aguileraGit/bf/hours.md

#PCB Design
~6 before 16 Sep
16 Sep 3hr
17 Sep 0.5
18 Sep 2
19 Sep 1.5
20 Sep 1.5
21 Sep 0.5
23 Sep 1
24 Sep 0.5
29 Sep 1.5
30 Sep 1.5

#Troubleshooting
