aguileraGit/bf/wishList.md

Dummy Load Tester: https://www.amazon.com/KKmoon-Multi-functional-Constant-Electronic-Discharge/dp/B0713ZMFGZ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

12V Power Supplies:
https://www.alibaba.com/product-detail/ac100v-240v-50-60hz-Power-transformer_60697817835.html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

Fuses:
https://www.amazon.com/Blade-Fuses-Assortment-220PCS-Standard/dp/B07786GPGK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

12V to 5V DC/DC converter:
https://www.digikey.com/products/en/power-supplies-board-mount/dc-dc-converters/922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

http://www.cui.com/product/resource/pdq15-d.pdf Might work. Need to check the specs of the PRi
https://raspberrypi.stackexchange.com/questions/1617/how-do-i-supply-power-through-the-gpio

Connector:
https://www.digikey.com/products/en/connectors-interconnects/terminal-blocks-wire-to-board/371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

Fuse:
https://www.raspberrypi.org/forums/viewtopic.php?t=10500#p1063279

5V specs:
https://electronics.stackexchange.com/questions/12935/stability-of-usb-5v-output

Possible 12V-5V DC-DC Converters - All these meet the USB specs if designed right!
# Option 3
https://www.digikey.com/product-detail/en/delta-electronics/S24SE05004PDFA/941-1603-ND/3528194
I like this option

# Option 2
http://www.cui.com/product/resource/pdq30-d.pdf

# Option 1 with inductor
https://www.digikey.com/product-detail/en/recom-power/R-745.0P/945-1028-ND/2256208
https://www.digikey.com/product-detail/en/murata-power-solutions-inc/60B474C/811-2465-ND/3178536
https://www.digikey.com/product-detail/en/panasonic-electronic-components/EEE-FC1V330AP/PCE4368CT-ND/1142028

Filter:
https://www.digikey.com/products/en/filters/emi-rfi-filters-lc-rc-networks/835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

12V Power supplies
https://www.digikey.com/product-detail/en/mean-well-usa-inc/SP-240-12/1866-4737-ND/7706906
https://www.digikey.com/product-detail/en/mean-well-usa-inc/SP-320-12/1866-4740-ND/7706913 or 709-SP-320-12

USB Specs:
https://en.wikipedia.org/wiki/USB
