aguileraGit/bf/initScope.md

#### Title

### Scope
Design a circuit board to go to market with software being developed.

### Version overview

### Version 1
v1 simple PCB to replace wires.

Deliverables:
- Fully working PCBs (No active components. Only fuses and connections)
- Able to control

### Version 2
Deliverables:
- Fully working HW solution
- All documents needed to source assembled PCBs

A plug and play drop-in replacement

### Cost & Timeline v1
Two iterations.

### Cost & Timeline v2
Three iterations.

Design time.
Manufacturing/wait time.
Troubleshooting/assembly time.

### Assumptions
(5 day lead time + shipping)

### Expectations

### Unknowns
Solenoids being used

Operating conditions (Temp/Hum) standards
