aguileraGit/bf/questions.md

Relays - NO or NC (2-3)

5V and USB 5V - Same?
