aguileraGit/bf/PCB/mainPCB/mainPCB-v04-ImageBottom.png

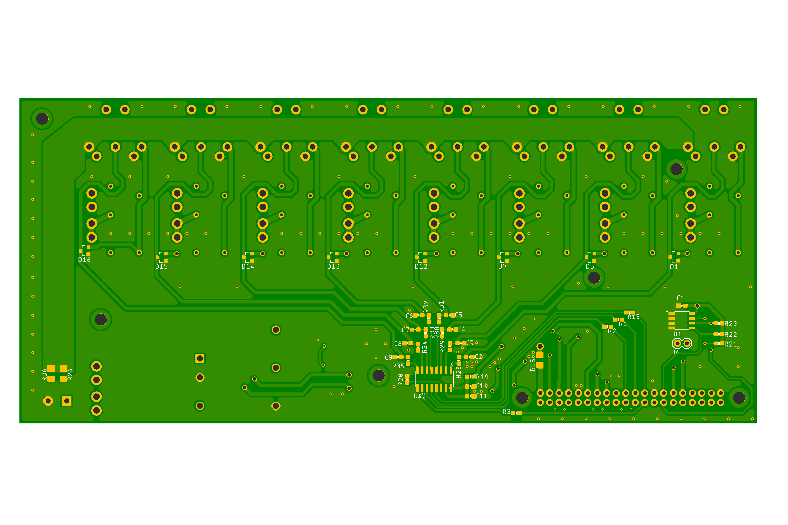
PCB/mainPCB/mainPCB-v04-ImageBottom.png
