aguileraGit/bf/PCB/mainPCB/mainPCB-v04-ImageTop.png

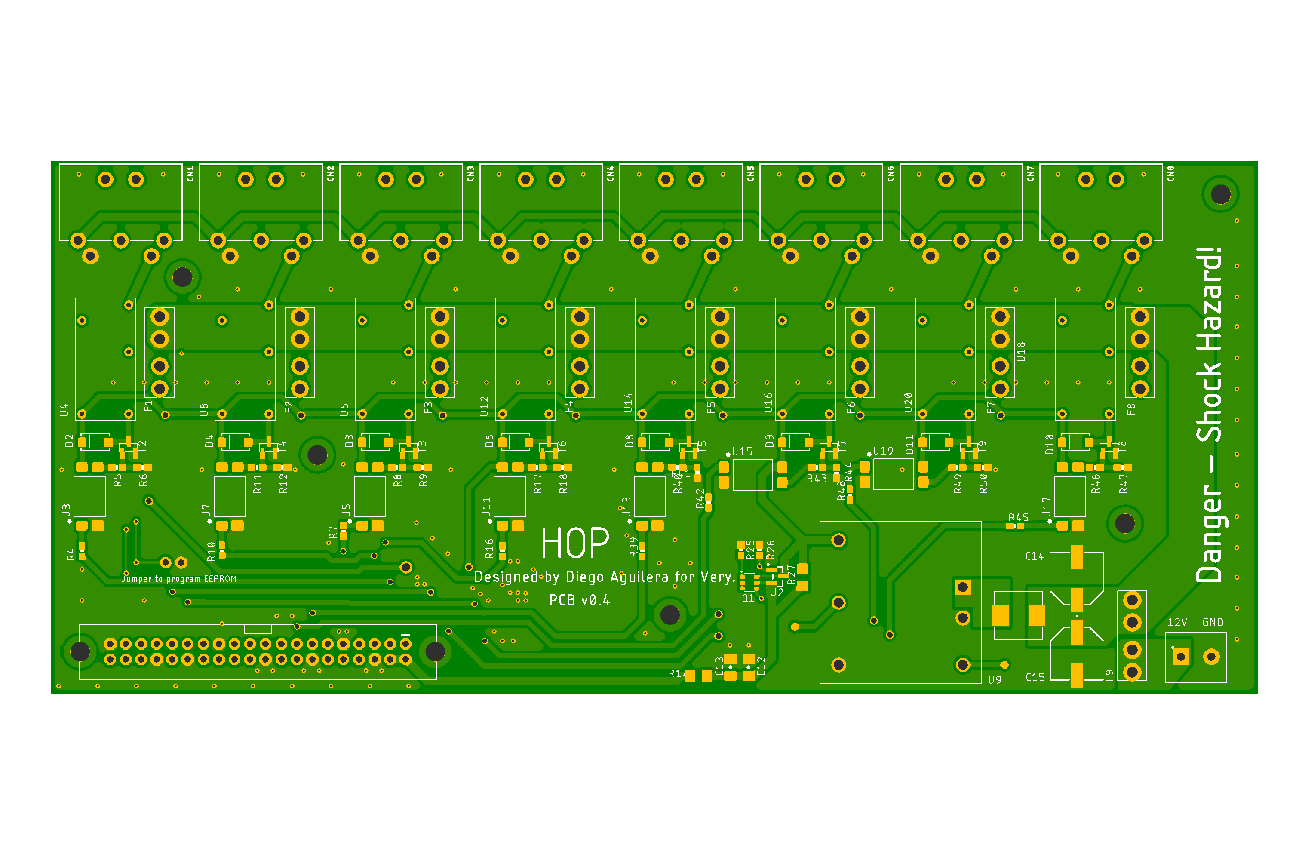
PCB/mainPCB/mainPCB-v04-ImageTop.png
