aguileraGit/bf/components.md

Relays:

Original - http://pub.ucpros.com/download/27115-Songle-Relay-Datasheet.pdf?osCsid=lkmundpgbffvh4nscdn8atdrd6

Z5439-ND
255-4029-5-ND
255-3565-ND  - closest one so far

Optoisolators
TLP785(GR-TP6F)CT-ND
TLP785(TP6F)CT-ND - closest match (https://cdn.instructables.com/FW2/0P9O/IFR69UOP/FW20P9OIFR69UOP.MEDIUM.jpg)

Vishay has spice models
https://www.vishay.com/optocouplers/related/

https://i.stack.imgur.com/lKYxf.png
https://i.stack.imgur.com/pe4n5.png

https://toshiba.semicon-storage.com/ap-en/product/opto/photocoupler/detail.TLP785.html

ratio - https://electronics.stackexchange.com/questions/59456/driving-a-relay-with-transistor-and-opto-isolator

## Final

##### Following sample circuit
http://www.electroschematics.com/8512/microcontroller-relay-interface-and-driver/

#### For LT Simulation help
LT Spice: http://cds.linear.com/docs/en/software-and-simulation/LTspiceShortcutsForMacOSX.pdf

#### Opto-coupler
- SFH615A-3X009TCT-ND (SFH615A-3X007T or SFH615A-3X009T) 100-200% CTR
- 255-3565-ND
https://www.vishay.com/optocouplers/related/#pspzip

#### Transistor
BC817-16WDICT-ND

#### Transistor
