aguileraGit/bf/originalBOM.xlsx

Sheet: Totals
Control Unit Count | Sensor Unit Count | Testing Supplies Count
2 | 16 | 2
Total Price: | $1243.49
Price Per tap: | $77.72

Sheet: Control Unit
Item No. | Item Description | Vendor Info / Purchase Link | Documentation Link | Unit Price | Qty | Qty Units | Total
0 | ADC Pi Hat | http://www.nationelectronics.com/raspberry-pi-extensions/3-raspberry-pi-hat-8-channel-adc-v11-0648260628215.html |  | $19.95 | 1 | unit | $165.98
1 | Raspberry Pi Model 3B | https://www.amazon.com/Raspberry-Model-A1-2GHz-64-bit-quad-core/dp/B01CD5VC92/ |  | $35.70 | 1 | unit
2 | SD Cards | https://www.amazon.com/SanDisk-micro-Memory-Card-Tablets/dp/B013TMN4GW/ |  | $10.08 | 2 | unit
3 | Whole System Power Supply | http://www.mouser.com/ProductDetail/Mean-Well/RD-65A | http://meanwellusa.com/productPdf.aspx?i=166#1 | $20.99 | 1 | unit
4 | Right angle micro USB | https://www.aliexpress.com/item/Free-Shipping-Left-turn-or-Right-turn-90-Degree-USB2-0-Male-to-micro-Extension-mini/32793720467.html |  | $1.20 | 1 | unit
5 | Main Power Switch | https://www.aliexpress.com/item/MYLB-3-Pin-IEC320-C14-Inlet-Module-Plug-Fuse-Switch-Male-Power-Socket-10A-250V/32745820008.html |  | $1.66 | 1 | unit
6 | Relays for Solenoids | https://www.aliexpress.com/item/8-Channel-5V-Relay-Shield-Module-Board-Optocoupler-module-For-Arduino-ARM-AVR/32790038065.html |  | $4.28 | 1 | unit
7 | 5 Pin Female External Connector | https://www.digikey.com/product-detail/en/cui-inc/SD-50SN/CP-1250-ND/97021 |  | $2.24 | 8 | unit
8 | Assorted Fuses | https://www.amazon.com/Ginsco-110pcs-5x20mm-Quick-Assorted/dp/B01CEB6B1Y/ |  | $6.99 | 1 | unit
9 | Fuse Block | https://www.aliexpress.com/item/12V-8-Way-Car-Truck-Automotive-Auto-Blade-Fuse-Box-Block-Holder-Circuit/32377857382.html |  | $8.79 | 1 | unit
10 | 2A Fuses | https://www.digikey.com/product-detail/en/littelfuse-inc/0287002.PXCN/F4192-ND/3102552 |  | $0.28 | 16 | unit
11 | Power Cord | https://www.amazon.com/Amamax-Power-Cable-VIZIO-Warranty/dp/B004TNKZ1I/ |  | $5.99 | 1 | unit
12 | Wire | https://www.amazon.com/Remington-Industries-20UL1007STRKIT-Stranded-Diameter/dp/B00N51OT6C/ |  | $20.85 | 0.25 | unit
13 | Terminal Block | https://www.aliexpress.com/item/1pcs-600V-20A-8-Position-Movable-Terminal-Blocks-TA-2008/783282597.html |  | $6.64 | 1 | unit
14 | 12mm Standoffs | https://www.aliexpress.com/item/100PCS-M2-5-male-to-female-Brass-Standoff-spacer-length-6mm-30mm/32789600225.html |  | $2.55 | 0.12 | unit
15 | M2.5 x 4mm Screws | https://www.aliexpress.com/item/100pcs-brass-flat-head-screw-M2-M2-5-M3-Brass-cross-recessed-countersunk-head-machine-screws/32792555301.html |  | $4.25 | 0.08 | lot (100)
16 | M2.5 Hex Nut | https://www.aliexpress.com/item/1000pcs-Metric-Thread-M2-5-Brass-Hex-Nuts-DIN934-Hexagon-Nut-Screw-Nut/32754809960.html |  | $7.55 | 0.008 | lot (1000)
17 | Heat Shrink | https://www.amazon.com/gp/product/B01MFA3OFA/ |  | $7.39 | 0.25 | unit
18 | Panel Mount Ethernet Jumper | https://www.aliexpress.com/item/Up-Down-Angled-RJ45-Cat5-8P8C-FTP-STP-UTP-Cat-5e-Male-to-Female-Panel-Mount/32809895058.html |  | $2.25 | 1 | unit
19 | 10pin Female Dupont (Relay board to Pi) | https://www.aliexpress.com/item/20Sets-Pitch-2-54mm-1x10-Pin-Single-Row-Dupont-Jumper-Wire-Cable-Female-Pin-Connector-And/32776723875.html |  | $3.13 | 0.05 | lot (20)
20 | 8pin Female Dupont (Pi Flow Signal) | https://www.aliexpress.com/item/Free-shipping-500Pcs-lot-Wholesale-2-54mm-Pitch-1-8-Pins-Female-Dupont-Header-Connector-Pin/1683241962.html |  | $16.40 | 0.001 | lot(1000)
21 | 2x8pin Female Dupont (Pi Flow +/-) | https://www.aliexpress.com/item/Free-shipping-500Pcs-lot-Wholesale-2-0mm-Pitch-2-8-16-Pins-Female-Dupont-Header-Connector/1277901038.html |  | $31.70 | 0.002 | lot(500)
22 | 3pin Female Dupont (Relay board to PSU) | https://www.aliexpress.com/item/200Pcs-3P-Dupont-Jumper-Wire-Cable-Housing-Plug-Female-Pin-Terminal-Dupont-Shell-Kit-Connector-2/32530544555.html |  | $1.44 | 0.005 | lot(200)
23 | 3M VHB Tape 1inch width | https://www.amazon.com/Tape-RP25-width-length-Roll/dp/B007Y7DV4E |  | $11.09 | 0.045 | roll
24 | 1/4" Spade Connector | https://www.aliexpress.com/item/6-3mm-6-3-Crimp-Terminal-Female-Spade-Connector/32679710199.html |  | $5.92 | 0.08 | lot(200)

Sheet: Sensor Unit
Item No. | Item Description | Vendor Info / Purchase Link | Documentation Link | Unit Price | Qty | Qty Units | Total
0 | Flow Meter 3/8" PTC (Male) | https://www.amazon.com/0-1-3L-1-2Mpa-Water-Sensor-Coffer/dp/B01FFHTE0E |  | $7.25 | 1 | unit | $44.33
1 | Solenoid Valve 1/4" NPT (Female) | https://www.amazon.com/Solenoid-Normally-Crack-resistant-U-S-Solid/dp/B007N0DN3Q/ |  | $11.77 | 1 | unit
2 | 5 Conductor Wire | https://www.amazon.com/ALEKO-LM150-5-Core-Conductor-Strand/dp/B01B3PKB1S/ |  | $1.12 | 8 | feet
3 | 5 Pin Male wired connector | https://www.digikey.com/product-detail/en/cui-inc/SD-50/CP-1050-ND/96997 |  | $1.47 | 1 | unit
6 | PTC Adapter 3/8" PTC (Female) to 1/4" NPTF (Male) | https://www.mcmaster.com/#9087K13 |  | $3.44 | 2 | unit
7 | 3/8" Push to Connect Splice | https://www.mcmaster.com/#9087K62 |  | $3.98 | 2 | unit

Sheet: Testing Supplies
Item No. | Item Description | Vendor Info / Purchase Link | Documentation Link | Unit Price | Qty | Qty Units | Total
0 | 3/8" Push to Connect Tubing | https://www.mcmaster.com/#5384K556 |  | $0.34 | 25 | feet | $101.12
1 | 3/8" Push to Connect to 1/4" NPT (Female) | https://www.mcmaster.com/#9087K28 |  | $6.39 | 1 | units
2 | Garden Hose (Female) to 3/8" NPT (Male) | https://www.mcmaster.com/#73605T67 |  | $4.22 | 1 | units
3 | Faucet to Garden Hose Adapter | https://www.amazon.com/LDR-530-2050-Aerator-Adapter/dp/B00BHZLR4K/ |  | $8.33 | 1 | units
4 | 3/8" NPT (Female) to 1/4" NPT (Male) | https://www.amazon.com/Anderson-Metals-Fitting-Adapter-Female/dp/B000BQUI8M/ |  | $5.61 | 1 | units
5 | IR Flashlight | https://www.amazon.com/VastFire-Adjustable-Infrared-Flashlight-Hunting/dp/B01IEYFGNO |  | $21.99 | 1 | units
6 | Extra SD Card | https://www.amazon.com/SanDisk-micro-Memory-Card-Tablets/dp/B013TMN4GW/ |  | $10.08 | 1 | unit
7 | Switched USB Cable | https://www.amazon.com/JBtek-Raspberry-Micro-Cable-Switch/dp/B00JU24Z3W |  | $6.49 | 1 | unit
8 | Peripheral Switch | https://www.amazon.com/IOGEAR-Computer-Peripheral-Sharing-GUS402/dp/B00BD8I2OY/ |  | $29.51 | 1 | unit
