aguileraGit/bf/PCB/mainPCB/mainPCB-BOM-v0_4-01.xlsx

Populate | Qty | Value | Device | Package | Parts | PN | Digikey PN | Description | Unit Price | Ext Price
Y | 8 |  | DIODESMA | SMA-DIODE | D2, D3, D4, D6, D8, D9, D10, D11 | S1A-13-F | S1A-E3/5ATGICT-ND | Diode | 0.33 | 2.64
Y | 1 |  | M02PTH | 1X02 | J6 | M20-9990246 | 952-2262-ND | Standard 2-pin 0.1 header. Use with" | 0.11 | 0.11
Y | 6 | 0 | RESISTOR0603-RES | 0603-RES | R1, R2, R3, R13, R19, R20 | RC0603JR-070RL | 311-0.0GRCT-ND | Resistor | 0.1 | 0.60
Y | 4 | 0 | RESISTOR1206 | 1206 | R14, R15, R24, R36 | HCJ1206ZT0R00 | HCJ1206ZT0R00CT-ND | Resistor | 0.55 | 2.20
Y | 11 | 0.1uF | 0.1UF-25V(+80/-20%)(0603) | 0603-CAP | C1, C2, C3, C4, C5, C6, C7, C8, C9, C10, C11 | C0603C104K8RACTU | 399-1095-1-ND | CAP-00810 | 0.029 | 0.32
Y | 9 | 10k | RESISTOR0603-RES | 0603-RES | R5, R8, R11, R17, R25, R40, R43, R46, R49 | RC0603FR-0710KL | 311-10.0KHRCT-ND | Resistor | 0.1 | 0.90
Y | 1 | 1935161 | 1935161 | PHOENIX_1935161 | J1 | 277-1667-ND | 1935161 | Conn Terminal Blocks 2 POS 5mm Solder ST Thru-Hole 16A | 0.41 | 0.41
Y | 2 | 1uF | 1.0UF50V10%(1206) | 1206-CAP | C12, C13 | CC1206KKX7R6BB105 | 311-1951-1-ND | CAP-09822 | 0.26 | 0.52
Y | 3 | 3.9k | RESISTOR0603-RES | 0603-RES | R21, R22, R23 | RC0603FR-073K9L | 311-3.90KHRCT-ND | Resistor | 0.1 | 0.30
Y | 8 | 330 | RESISTOR0603-RES | 0603-RES | R28, R29, R30, R31, R32, R33, R34, R35 | RC0603FR-07300RL | 311-300HRCT-ND | Resistor | 0.1 | 0.80
Y | 9 | 3544-2 | 3544-2 | 3544-2 | F1, F2, F3, F4, F5, F6, F7, F8, F9 | 3544-2 | 36-3544-2-ND | Keystone Electronics Fuse Holder - 3544-2 | 0.91 | 8.19
Y | 8 | 47 | RESISTOR0603-RES | 0603-RES | R4, R7, R10, R16, R39, R42, R45, R48 | RC0603JR-0747RL | 311-47GRCT-ND | Resistor | 0.1 | 0.80
Y | 9 | 47k | RESISTOR0603-RES | 0603-RES | R6, R9, R12, R18, R26, R41, R44, R47, R50 | RC0603FR-0747KL | 311-47.0KHRCT-ND | Resistor | 0.1 | 0.90
Y | 8 | ALQ105 | ALQ105 | ALQ105 | U4, U6, U8, U12, U14, U16, U18, U20 | ALQ105 | 255-3565-ND | ALQ105 Solenoid | 2.42 | 19.36
Y | 1 | AT24C256C-SSHL-B | AT24C256C-SSHL-B | SOIC127P600X175-8N | U1 | AT24C256C-SSHL-B | AT24C256C-SSHL-B-ND | EEPROM Serial-2Wire 256K-bit 32K x 8 1.8V/2.5V/3.3V/5V 8-Pin SOIC Bulk | 0.7 | 0.70
Y | 8 | BAV99-7-F | BAV99 | SOT23-3 | D1, D5, D7, D12, D13, D14, D15, D16 | BAV99-7-F | BAV99-FDICT-ND | Two small signal silicon diodes connected anode to cathode. | 0.16 | 1.28
Y | 8 | BC817 | BC817 | BC817 | T2, T3, T4, T5, T6, T7, T8, T9 | BC817-25-7-F | BC817-25FDICT-ND | NPN Transistor BC817 | 0.22 | 1.76
Y | 1 | DMG2305UX-13SOT-23-M | DMG2305UX-13SOT-23-M | SOT-23-M | U2 | DMG2305UX-13 | DMG2305UX-13DICT-ND |  | 0.44 | 0.44
Y | 1 | DMMT5401-7-F | DMMT5401-7-F | SOT26 | Q1 | DMMT5401-7-F | DMMT5401-FDICT-ND | http://octopart.com/dmmt5401-7-f-diodes+inc.-39560120 | 0.46 | 0.46
N | 1 | DNP | RESISTOR1206 | 1206 | R27 |  |  | Resistor |  |  |  | N
Y | 1 | DR73-1R0-R | DR73-1R0-R | DR73 | L1 | DR73-1R0-R | 513-1130-1-ND |  | 1.13 | 1.13
Y | 2 | EEE-HA1C471UPCAP_PAN_EEE_F-L | EEE-HA1C471UPCAP_PAN_EEE_F-L | CAP_PAN_EEE_F-L | C14, C15 | EEE-HA1C471UP | PCE4192CT-ND |  | 0.68 | 1.36
N | 1 | FRAME-LETTER | FRAME-LETTER | CREATIVE_COMMONS | FRAME3 |  |  | Schematic Frame |  |  |  | N
N | 2 | FRAME-LETTERNO_PACKAGE | FRAME-LETTERNO_PACKAGE | DUMMY | FRAME1, FRAME2 |  |  | Schematic Frame |  |  | Nobody | N | v01
Y | 1 | MCP3208T-CI/SL | MCP3208T-CI/SL | SOIC16-N_MC | U$2 | MCP3208T-CI/SL | MCP3208T-CI/SLCT-ND | Microchip MCP3208 ADC | 3.69 | 3.69
Y | 1 | RASPBERRYPI-40-PIN-GPIO | RASPBERRYPI-40-PIN-GPIO | 2X20-SHROUDED | J2 | 929975-01-20-RK | 929975E-01-20-ND | Second Generation Raspberry Pi GPIO Header | 3.2 | 3.20
Y | 1 | S24SE05004PDFA | S24SE05004PDFA | CONV_S24SE05002PDFA | U9 | S24SE05004PDFA | 941-1603-ND | None | 34.48 | 34.48
Y | 8 | SDS-50J | SDS-50J | SDS-50J | CN1, CN2, CN3, CN4, CN5, CN6, CN7, CN8 | SDS-50J | CP-2350-ND | DIN 5-Pin - Circular | 1.57 | 12.56
Y | 8 | SFH615A-07 | SFH615A-07 | SFH615A-07 | U3, U5, U7, U11, U13, U15, U17, U19 | SFH615A-4X017T | SFH615A-4X017TCT-ND | Vishay Optocoupler SFH615A-007 | 1.3 | 10.40
N | 2 | TEST-POINT3X5 | TEST-POINT3X5 | PAD.03X.05 | TP_ON/OFF, TP_TRIM |  |  | Bare copper test points for troubleshooting or ICT
 |  |  |  |  |  |  |  |  |  | 109.51
