aguileraGit/bf/PCB/mainPCB/mainPCB-BOM-v0_4-00.xlsx

Sheet: BOM
POPULATE | Qty | Value | Device | Package | Parts | PN | Digikey PN | Price | Description | AVAILABILITY | DESCRIPTION | DESIGNER | DIGI-KEY_PART_NUMBER | DIGI-KEY_PURCHASE_URL | MANUFACTURER_PART_NUMBER | MF | MP | PACKAGE | PRICE | PROD_ID | VALUE | VENDOR | VERSION
Y | 8 |  | DIODESMA | SMA-DIODE | D2, D3, D4, D6, D8, D9, D10, D11 | BAV21WS-7-F | BAV21WS-FDICT-ND | 0.22 | Diode
Y | 1 |  | M02PTH | 1X02 | J6 | M20-9990246 | 952-2262-ND | 0.1 | Standard 2-pin 0.1 header. Use with"
Y | 6 | 0 | RESISTOR0603-RES | 0603-RES | R1, R2, R3, R13, R19, R20 | RC0603JR-070RL | 311-0.0GRCT-ND | 0.1 | Resistor
Y | 3 | 0 | RESISTOR1206 | 1206 | R14, R15, R24 | HCJ1206ZT0R00 | HCJ1206ZT0R00CT-ND | 0.5 | Resistor
Y | 11 | 0.1uF | 0.1UF-25V(+80/-20%)(0603) | 0603-CAP | C1, C2, C3, C4, C5, C6, C7, C8, C9, C10, C11 | C0603C104K8RACTU | 399-1095-1-ND | 0.1 | CAP-00810 |  |  |  |  |  |  |  |  |  |  | CAP-00810 | 0.1uF
Y | 9 | 10k | RESISTOR0603-RES | 0603-RES | R5, R8, R11, R17, R25, R40, R43, R46, R49 | RC0603FR-0710KL | 311-10.0KHRCT-ND | 0.1 | Resistor
Y | 2 | 1uF | 1.0UF50V10%(1206) | 1206-CAP | C12, C13 | CC1206KKX7R6BB105 | 311-1951-1-ND |  | CAP-09822 |  |  |  |  |  |  |  |  |  |  | CAP-09822 | 1.0uF
Y | 1 | 1776244-4 | 1776244-4 | 1776244-4 | CON1 | 1776244-4 | A97998-ND |  | TE 1776244-4
Y | 3 | 3.9k | RESISTOR0603-RES | 0603-RES | R21, R22, R23 | RC0603FR-073K9L | 311-3.90KHRCT-ND |  | Resistor
Y | 8 | 330 | RESISTOR0603-RES | 0603-RES | R28, R29, R30, R31, R32, R33, R34, R35 | RC0603FR-07300RL | 311-300HRCT-ND |  | Resistor
Y | 9 | 3544-2 | 3544-2 | 3544-2 | F1, F2, F3, F4, F5, F6, F7, F8, F9 | 3544-2 | 36-3544-2-ND | 0.91 | Keystone Electronics Fuse Holder - 3544-2
Y | 8 | 47 | RESISTOR0603-RES | 0603-RES | R4, R7, R10, R16, R39, R42, R45, R48 | RC0603JR-0747RL | 311-47GRCT-ND | 0.1 | Resistor
Y | 9 | 47k | RESISTOR0603-RES | 0603-RES | R6, R9, R12, R18, R26, R41, R44, R47, R50 | RC0603FR-0747KL | 311-47.0KHRCT-ND | 0.1 | Resistor
Y | 8 | ALQ105 | ALQ105 | ALQ105 | U4, U6, U8, U12, U14, U16, U18, U20 | ALQ105 | 255-3565-ND | 2.42 | ALQ105 Solenoid
Y | 1 | AT24C256C-SSHL-B | AT24C256C-SSHL-B | SOIC127P600X175-8N | U1 | AT24C256C-SSHL-B | AT24C256C-SSHL-B-ND | 0.69 | EEPROM Serial-2Wire 256K-bit 32K x 8 1.8V/2.5V/3.3V/5V 8-Pin SOIC Bulk |  | EEPROM Serial-2Wire 256K-bit 32K x 8 1.8V/2.5V/3.3V/5V 8-Pin SOIC Bulk |  | AT24C256C-SSHL-B-ND | https://www.digikey.com/product-detail/en/microchip-technology/AT24C256C-SSHL-B/AT24C256C-SSHL-B-ND/2271121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 |  | Atmel | AT24C256C-SSHL-B | SOIC-8 Atmel
Y | 8 | BAV99-7-F | BAV99 | SOT23-3 | D1, D5, D7, D12, D13, D14, D15, D16 | BAV99-7-F | BAV99-FDITR-ND | 0.22 | Two small signal silicon diodes connected anode to cathode. |  |  |  |  |  |  |  |  |  |  | DIO-10647
Y | 8 | BC817 | BC817 | BC817 | T2, T3, T4, T5, T6, T7, T8, T9 | BC817-25-7-F | BC817-25FDICT-ND | 0.22 | NPN Transistor BC817
Y | 1 | DMG2305UX-13SOT-23-M | DMG2305UX-13SOT-23-M | SOT-23-M | U2 | DMG2305UX-13 | DMG2305UX-13DICT-ND |  |  |  |  |  |  |  | DMG2305UX13 |  |  |  |  |  |  | Diodes Inc
Y | 1 | DMMT5401-7-F | DMMT5401-7-F | SOT26 | Q1 | DMMT5401-7-F | DMMT5401-FDICT-ND | 0.46 | http://octopart.com/dmmt5401-7-f-diodes+inc.-39560120 |  | DMMT5401 Series PNP 150 V 300 mW Small Signal Transistor SMT - SOT-26-6 |  | DMMT5401-FDICT-ND | https://www.digikey.com/product-detail/en/diodes-incorporated/DMMT5401-7-F/DMMT5401-FDICT-ND/717881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 |  | Diodes Inc. | DMMT5401-7-F | SOT-23 Diodes Inc.
N | 1 | DNP | RESISTOR1206 | 1206 | R27 |  |  |  | Resistor
Y | 2 | EEE-HA1C471UPCAP_PAN_EEE_F-L | EEE-HA1C471UPCAP_PAN_EEE_F-L | CAP_PAN_EEE_F-L | C14, C15 | EEE-HA1C471UP | PCE4192CT-ND | 0.68 |  |  |  |  |  |  | EEEHA1C471UP |  |  |  |  |  |  | PANASONIC
N | 1 | FRAME-LETTER | FRAME-LETTER | CREATIVE_COMMONS | FRAME3 |  |  |  | Schematic Frame
N | 2 | FRAME-LETTERNO_PACKAGE | FRAME-LETTERNO_PACKAGE | DUMMY | FRAME1, FRAME2 |  |  |  | Schematic Frame |  |  | Nobody |  |  |  |  |  |  |  |  |  |  | v01
Y | 1 | MCP3208T-CI/SL | MCP3208T-CI/SL | SOIC16-N_MC | U$2 | MCP3208T-CI/SL | MCP3208T-CI/SLCT-ND | 3.65 | Microchip MCP3208 ADC | Good | 8 Channel SPI Serial Interface 2.7 V 12-Bit A/D Converter SMT - SOIC-16 |  |  |  |  | Microchip | MCP3208T-CI/SL | SOIC-16 Microchip | 3.04 USD
Y | 1 | RASPBERRYPI-40-PIN-GPIO | RASPBERRYPI-40-PIN-GPIO | 2X20-SHROUDED | J2 | 929975-01-20-RK | 929975E-01-20-ND | 3.32 | Second Generation Raspberry Pi GPIO Header
Y | 8 | SDS-50J | SDS-50J | SDS-50J | CN1, CN2, CN3, CN4, CN5, CN6, CN7, CN8 | SDS-50J | CP-2350-ND | 1.17 | DIN 5-Pin - Circular | Good | 5 Pin%2C Right-Angle Receptacle%2C 180%C2%B0 |  |  |  |  | CUI | SDS-50J | None | 0.77 USD
Y | 8 | SFH615A-07 | SFH615A-07 | SFH615A-07 | U3, U5, U7, U11, U13, U15, U17, U19 | SFH615A-4X017T | SFH615A-4X017TCT-ND | 1.03 | Vishay Optocoupler SFH615A-007

Sheet: Sheet2
Units of X-Y coordinates are in millimeters
Part | X | Y | Rotation | Side | Type | XSize | YSize | Value | Footprint | Populate | MPN
C1 | 20.02 | 31.5 | 180 |  | 1 |  |  | 0.1uF | 0603 | 1
C2 | 76.84 | 17.78 | 0 |  | 1 |  |  | 0.1uF | 0603 | 1
C3 | 79.12 | 21.46 | 0 |  | 1 |  |  | 0.1uF | 0603 | 1
C4 | 81.28 | 25.15 | 0 |  | 1 |  |  | 0.1uF | 0603 | 1
C5 | 82.17 | 28.96 | 0 |  | 1 |  |  | 0.1uF | 0603 | 1
C6 | 90.3 | 28.96 | 180 |  | 1 |  |  | 0.1uF | 0603 | 1
C7 | 91.31 | 25.15 | 180 |  | 1 |  |  | 0.1uF | 0603 | 1
C8 | 93.34 | 21.46 | 180 |  | 1 |  |  | 0.1uF | 0603 | 1
C9 | 95.89 | 17.78 | 180 |  | 1 |  |  | 0.1uF | 0603 | 1 |  | import mainPCB.mnt in dirctory
C10 | 76.53 | 9.93 | 0 |  | 1 |  |  | 0.1uF | 0603 | 1
C11 | 76.53 | 7.24 | 0 |  | 1 |  |  | 0.1uF | 0603 | 1
D1 | 22.02 | 44.58 | 90 |  | 1 |  |  | BAV99-7-F | SOT23-3 | 1
D5 | 44.5 | 44.45 | 90 |  | 1 |  |  | BAV99-7-F | SOT23-3 | 1
D7 | 67.87 | 44.45 | 90 |  | 1 |  |  | BAV99-7-F | SOT23-3 | 1
D12 | 89.71 | 44.45 | 90 |  | 1 |  |  | BAV99-7-F | SOT23-3 | 1
D13 | 113.33 | 44.45 | 90 |  | 1 |  |  | BAV99-7-F | SOT23-3 | 1
D14 | 135.94 | 44.45 | 90 |  | 1 |  |  | BAV99-7-F | SOT23-3 | 1
D15 | 159.05 | 44.45 | 90 |  | 1 |  |  | BAV99-7-F | SOT23-3 | 1
D16 | 180.42 | 46.23 | 90 |  | 1 |  |  | BAV99-7-F | SOT23-3 | 1
R1 | 36.96 | 27.81 | 180 |  | 1 |  |  | 0 | 0603 | 1
R2 | 39.88 | 25.91 | 180 |  | 1 |  |  | 0 | 0603 | 1
R3 | 64.26 | 2.79 | 180 |  | 1 |  |  | 0 | 0603 | 1
R13 | 34.04 | 29.72 | 180 |  | 1 |  |  | 0 | 0603 | 1
R15 | 57.96 | 17.02 | 270 |  | 1 |  |  | 0 | 1206 | 1
R19 | 76.53 | 12.6 | 0 |  | 1 |  |  | 0 | 0603 | 1
R20 | 93.42 | 11.81 | 270 |  | 1 |  |  | 0 | 0603 | 1
R21 | 10.11 | 21.39 | 0 |  | 1 |  |  | 3.9k | 0603 | 1
R22 | 10.11 | 23.93 | 0 |  | 1 |  |  | 3.9k | 0603 | 1
R23 | 10.11 | 26.85 | 0 |  | 1 |  |  | 3.9k | 0603 | 1
R24 | 184.15 | 31.72 | 270 |  | 1 |  |  | 0 | 1206 | 1
R28 | 79.63 | 16.89 | 90 |  | 1 |  |  | 330 | 0603 | 1
R29 | 82.04 | 20.57 | 90 |  | 1 |  |  | 330 | 0603 | 1
R30 | 84.07 | 24.26 | 90 |  | 1 |  |  | 330 | 0603 | 1
R31 | 84.84 | 28.07 | 90 |  | 1 |  |  | 330 | 0603 | 1
R32 | 87.63 | 28.07 | 90 |  | 1 |  |  | 330 | 0603 | 1
R33 | 88.52 | 24.26 | 90 |  | 1 |  |  | 330 | 0603 | 1
R34 | 90.55 | 20.45 | 90 |  | 1 |  |  | 330 | 0603 | 1
R35 | 93.22 | 16.89 | 90 |  | 1 |  |  | 330 | 0603 | 1
U$2 | 86.23 | 11.81 | 270 |  | 1 |  |  | MCP3208T-CI/SL | SOIC16 | 1
U1 | 20.02 | 27.48 | 0 |  | 1 |  |  | AT24C256C-SSHL-B | SOIC127-8N | 1
