aguileraGit/bf/PCB/mainPCB/BF_v0_2-00-BOM.xlsx

Sheet: BOM
Populate | Qty | Value | Device | Package | Parts | Manufacture PN | DigiKey PN | 1 |  | 10 |  | 100 |  | Description | AVAILABILITY | DESCRIPTION | DESIGNER | DIGI-KEY_PART_NUMBER | DIGI-KEY_PURCHASE_URL | MANUFACTURER_PART_NUMBER | MF | MP | PACKAGE | PRICE | PROD_ID | VALUE | VENDOR | VERSION
Y | 9 |  | DIODESMA | SMA-DIODE | D2, D3, D4, D5, D6, D8, D9, D10, D11 | CDBA5200-HF | 641-1706-1-ND | 0.59 | 5.31 | 0.493 | 44.37 | 0.3699 | 332.91 | Diode
Y | 1 |  | M02PTH | 1X02 | J6 | M20-9990246 | 952-2262-ND | 0.11 | 0.11 | 0.099 | 0.99 | 0.0609 | 6.09 | Standard 2-pin 0.1 header. Use with"
Y | 6 | 0 | RESISTOR0603-RES | 0603-RES | R1, R2, R3, R13, R19, R20 | RC0603JR-070RL | 311-0.0GRCT-ND | 0.1 | 0.6 | 0.01 | 0.6 | 0.0041 | 2.46 | Resistor
Y | 3 | 0 | RESISTOR1206 | 1206 | R14, R15, R24 | RC1206JR-070RL | 311-0.0ERCT-ND | 0.1 | 0.3 | 0.024 | 0.72 | 0.0097 | 2.91 | Resistor
Y | 11 | 0.1uF | 0.1UF-25V(+80/-20%)(0603) | 0603-CAP | C1, C2, C3, C4, C5, C6, C7, C8, C9, C10, C11 | GRM188R70J104KA01D | 490-9730-1-ND | 0.1 | 1.1 | 0.071 | 7.81 | 0.0316 | 34.76 | CAP-00810 |  |  |  |  |  |  |  |  |  |  | CAP-00810 | 0.1uF
Y | 2 | 10uF | 1.0UF50V10%(1206) | 1206-CAP | C12, C13 | LMK316B7106KL-TD | 587-2596-1-ND | 0.27 | 0.54 | 0.182 | 3.64 | 0.1032 | 20.64 | CAP-09822 |  |  |  |  |  |  |  |  |  |  | CAP-09822 | 1.0uF
Y | 9 | 10k | RESISTOR0603-RES | 0603-RES | R5, R8, R11, R17, R25, R40, R43, R46, R49 | RC0603FR-0710KL | 311-10.0KHRCT-ND | 0.1 | 0.9 | 0.015 | 1.35 | 0.006 | 5.4 | Resistor
Y | 1 | 1776244-4 | 1776244-4 | 1776244-4 | CON1 | 1776244-4 | A97998-ND | 1.74 | 1.74 | 1.225 | 12.25 | 1.0319 | 103.19 | TE 1776244-4
Y | 3 | 3.9k | RESISTOR0603-RES | 0603-RES | R21, R22, R23 | RC0603FR-073K9L | 311-3.90KHRDKR-ND | 0.1 | 0.3 | 0.015 | 0.45 | 0.006 | 1.8 | Resistor
Y | 8 | 330 | RESISTOR0603-RES | 0603-RES | R28, R29, R30, R31, R32, R33, R34, R35 | RC0603FR-07300RL | 311-300HRCT-ND | 0.1 | 0.8 | 0.015 | 1.2 | 0.006 | 4.8 | Resistor
Y | 8 | 3544-2 | 3544-2 | 3544-2 | F1, F2, F3, F4, F5, F6, F7, F8 | 3544-2 | 36-3544-2-ND | 0.91 | 7.28 | 0.778 | 62.24 | 0.6714 | 537.12 | Keystone Electronics Fuse Holder - 3544-2
Y | 8 | 47 | RESISTOR0603-RES | 0603-RES | R4, R7, R10, R16, R39, R42, R45, R48 | RC0603FR-0747RL | 311-47.0HRCT-ND | 0.1 | 0.8 | 0.015 | 1.2 | 0.006 | 4.8 | Resistor
Y | 9 | 47k | RESISTOR0603-RES | 0603-RES | R6, R9, R12, R18, R26, R41, R44, R47, R50 | RC0603FR-0747KL | 311-47.0KHRCT-ND | 0.1 | 0.9 | 0.015 | 1.35 | 0.006 | 5.4 | Resistor
Y | 8 | ALQ105 | ALQ105 | ALQ105 | U4, U6, U8, U12, U14, U16, U18, U20 | ALQ105 | 255-3565-ND | 2.42 | 19.36 | 2.273 | 181.84 | 1.818 | 1454.4 | ALQ105 Solenoid
Y | 1 | AT24C256C-SSHL-B | AT24C256C-SSHL-B | SOIC127P600X175-8N | U1 | AT24C256C-SSHL-B | AT24C256C-SSHL-B-ND | 0.69 | 0.69 | 0.631 | 6.31 | 0.5537 | 55.37 | EEPROM Serial-2Wire 256K-bit 32K x 8 1.8V/2.5V/3.3V/5V 8-Pin SOIC Bulk |  | EEPROM Serial-2Wire 256K-bit 32K x 8 1.8V/2.5V/3.3V/5V 8-Pin SOIC Bulk |  | AT24C256C-SSHL-B-ND | https://www.digikey.com/product-detail/en/microchip-technology/AT24C256C-SSHL-B/AT24C256C-SSHL-B-ND/2271121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 |  | Atmel | AT24C256C-SSHL-B | SOIC-8 Atmel
Y | 8 | BC817 | BC817 | BC817 | T2, T3, T4, T5, T6, T7, T8, T9 | BC817-25-7-F | BC817-25FDICT-ND | 0.22 | 1.76 | 0.183 | 14.64 | 0.0969 | 77.52 | NPN Transistor BC817
Y | 1 | DMG2305UX-13SOT-23-M | DMG2305UX-13SOT-23-M | SOT-23-M | U2 | DMG2305UX-13 | DMG2305UX-13DICT-ND | 0.44 | 0.44 | 0.398 | 3.98 | 0.2228 | 22.28 |  |  |  |  |  |  | DMG2305UX13 |  |  |  |  |  |  | Diodes Inc
Y | 1 | DMMT5401-7-F | DMMT5401-7-F | SOT26 | Q1 | DMMT5401-7-F | DMMT5401-FDICT-ND | 0.46 | 0.46 | 0.346 | 3.46 | 0.2153 | 21.53 | http://octopart.com/dmmt5401-7-f-diodes+inc.-39560120 |  | DMMT5401 Series PNP 150 V 300 mW Small Signal Transistor SMT - SOT-26-6 |  | DMMT5401-FDICT-ND | https://www.digikey.com/product-detail/en/diodes-incorporated/DMMT5401-7-F/DMMT5401-FDICT-ND/717881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 |  | Diodes Inc. | DMMT5401-7-F | SOT-23 Diodes Inc.
N | 1 | DNP | RESISTOR1206 | 1206 | R27 |  |  |  |  |  |  |  |  | Resistor
Y | 2 | EEE-HA1C471UPCAP_PAN_EEE_F-L | EEE-HA1C471UPCAP_PAN_EEE_F-L | CAP_PAN_EEE_F-L | C14, C15 | EEE-HA1C471UP | PCE4192CT-ND | 0.68 | 1.36 | 0.481 | 9.62 | 0.3166 | 63.32 |  |  |  |  |  |  | EEEHA1C471UP |  |  |  |  |  |  | PANASONIC
N | 1 | FRAME-LETTER | FRAME-LETTER | CREATIVE_COMMONS | FRAME3 |  |  |  |  |  |  |  |  | Schematic Frame
N | 2 | FRAME-LETTERNO_PACKAGE | FRAME-LETTERNO_PACKAGE | DUMMY | FRAME1, FRAME2 |  |  |  |  |  |  |  |  | Schematic Frame |  |  | Nobody |  |  |  |  |  |  |  |  |  |  | v01
Y | 1 | MCP3208T-CI/SL | MCP3208T-CI/SL | SOIC16-N_MC | U$2 | MCP3208T-CI/SL | MCP3208T-CI/SLCT-ND | 3.65 | 3.65 | 3.65 | 36.5 | 2.772 | 277.2 | Microchip MCP3208 ADC | Good | 8 Channel SPI Serial Interface 2.7 V 12-Bit A/D Converter SMT - SOIC-16 |  |  |  |  | Microchip | MCP3208T-CI/SL | SOIC-16 Microchip | 3.04 USD
N | 1 | RASPBERRYPI-40-PIN-GPIO | RASPBERRYPI-40-PIN-GPIO | 2X20-SHROUDED | J2 |  |  |  |  |  |  |  |  | Second Generation Raspberry Pi GPIO Header
Y | 8 | SDS-50J | SDS-50J | SDS-50J | CN1, CN2, CN3, CN4, CN5, CN6, CN7, CN8 | SDS-50J | CP-2350-ND | 1.17 | 9.36 | 1.028 | 82.24 | 0.8866 | 709.28 | DIN 5-Pin - Circular | Good | 5 Pin%2C Right-Angle Receptacle%2C 180%C2%B0 |  |  |  |  | CUI | SDS-50J | None | 0.77 USD
Y | 8 | SFH615A-07 | SFH615A-07 | SFH615A-07 | U3, U5, U7, U11, U13, U15, U17, U19 | SFH615A-4X017T | SFH615A-4X017TCT-ND | 1.03 | 8.24 | 0.84 | 67.2 | 0.5816 | 465.28 | Vishay Optocoupler SFH615A-007
N | 1 |  | Fuse |  |  | 0287002.PXCN | F4192-ND | 0.28 | 0.28 | 0.26 | 2.6 | 0.216 | 21.6
 |  |  |  |  |  |  | Total Cost |  | 66.28 |  | 546.56 |  | 4230.06
 |  |  |  |  |  |  | Cost per board |  | 66.28 |  | 54.656 |  | 42.3006

Sheet: Revisions
2017-11-29 | 00 | Started v0.2
