aguileraGit/bf/timeline.xlsx

Sheet: Sheet1
 | 100
Phase I |  | Hours | Rate | Fixed
 | Research | 4 | 400
 | Design | 20 | 2000 |  | 10.66666667 | 16
 | PCB + Parts (3) |  |  | 400
 | Assembly | 3 | 300
 | Troubleshooting | 5 | 500
 |  |  |  | $3600
Phase II - Projected |  | Hours | Rate | Fixed
 | Design | 10 | 1000 |  | 5.166666667 | 7.75
 | PCB + Parts (3) |  |  | 400
 | Assembly | 3 | 300
 | Troubleshooting | 2.5 | 250
 |  |  |  | $1950
Phase III - Projected |  | Hours | Rate | Fixed
 | Design | 5 | 500
 | PCB + Parts (3) |  |  | 400 | 3.666666667 | 5.5
 | Assembly | 3 | 300 |  |  | 29.25 | 50.25 |  | 7.178571429 | 2017-11-04
 | Work with FAB House | 3 | 300
 |  |  |  | $1500
 |  |  |  |  | 20 | 21 | 41 | 5.857142857
 |  |  |  | 7050 |  |  | 2017-09-08 | 2017-10-25

Sheet: Parts Estimate
Parts |  |  | On PCB | Total
Rpi headers | 2.95 | 1528-1783-ND | 1 | 2.95
ADC | 4.57 | MCP3208-BI/P-ND | 1 | 4.57
vRef | 3 |  | 1 | 3
Connector | 1.17 | CP-2350-ND | 8 | 9.36
Relay | 5 |  | 8 | 40
Fuse holder | 0.75 |  | 8 | 6
opto isolator | 0.25 |  | 8 | 2
Passives - RLC | 10 |  | 1 | 10
Screw terminals | 0.3 |  | 4 | 1.2
 |  |  |  | 79.08 | 237.24
