aguileraGit/bf/PCB/downloads/DR73-1R0-R/STL\STL\STEP\DR73.step

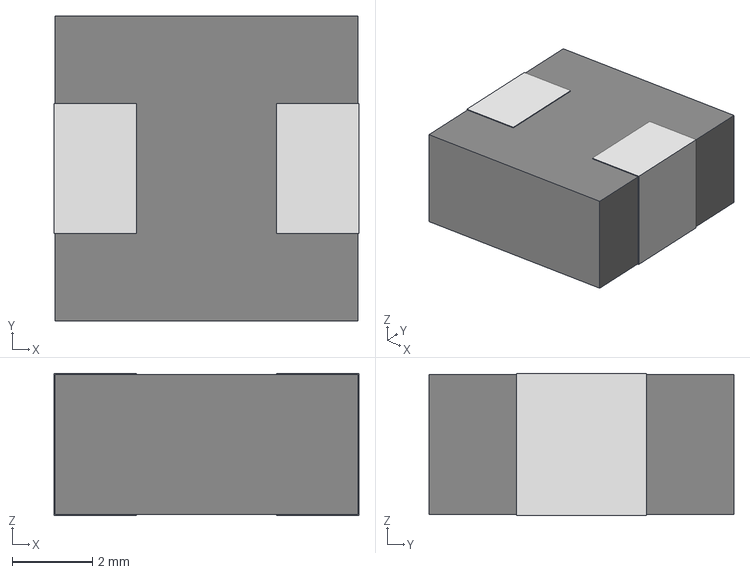
[picture p3: CAD file, 2018-02-24]
PCB/downloads/DR73-1R0-R/STL\STL\STEP\DR73.step
7.62 x 7.62 x 3.56 mm
