aguileraGit/bf/PCB/downloads/sdf-50j.stp

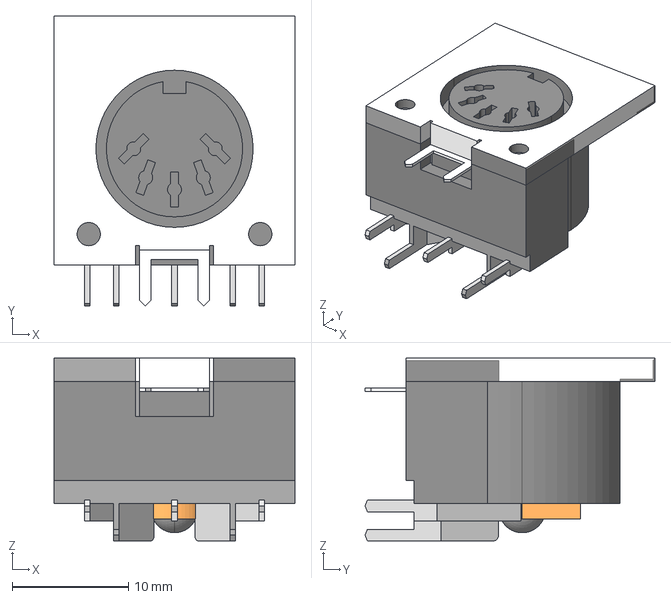
[picture p4: CAD file, 2017-10-07]
PCB/downloads/sdf-50j.stp
20.7 x 24.9 x 15.7 mm
