aguileraGit/bf/PCB/downloads/PAN_ALQ1.step

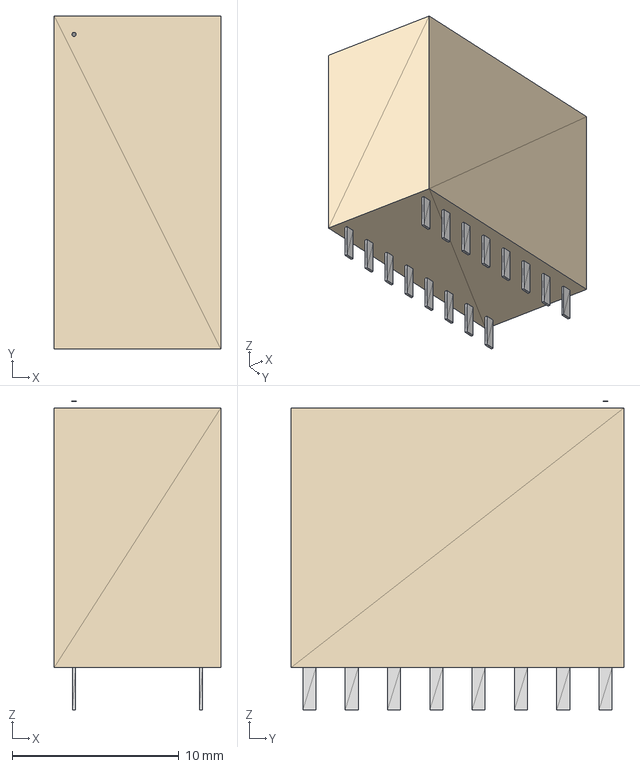
[picture p5: CAD file, 2017-10-07]
PCB/downloads/PAN_ALQ1.step
10.0 x 20.0 x 18.5 mm
