aguileraGit/bf/PCB/downloads/keystone-PN3544-2.STEP.txt

ISO-10303-21; HEADER; FILE_DESCRIPTION (( 'STEP AP214' ), '1' ); FILE_NAME ('3544-2.STEP', '2013-03-27T20:41:27', ( 'Richard Maletta' ), ( '' ), 'SwSTEP 2.0', 'SolidWorks 2009', '' ); FILE_SCHEMA (( 'AUTOMOTIVE_DESIGN' )); ENDSEC; DATA; #1 =( NAMED_UNIT ( * ) PLANE_ANGLE_UNIT ( ) SI_UNIT ( $, .RADIA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
04311369527748131600 ) ) ; #842 = LINE ( 'NONE', #841, #840 ) ; #843 = LINE ( 'NONE', #863, #860 ) ; #844 = SURFACE_STYLE_FILL_AREA ( #845 ) ; #845 = FILL_AREA_STYLE ('',( #850 ) ) ; #846 = COLOUR_RGB ( '',0.7960784313725489700, 0.8235294117647058400, 0.9372549019607843100 ) ; #847 = FACE_OUTER_BOUND ( 'NONE', #4868, .T. ) ; #848 = DIRECTION ( 'NONE', ( -5.773722060964636400E-018, -1.621377732827185500E-016, 1.000000000000000000 ) ) ; #849 = VECTOR ( 'NONE', #848, 1000.000000000000000 ) ; #850 = FILL_AREA_STYLE_COLOUR ( '', #846 ) ; #851 = VECTOR ( 'NONE', #866, 1000.000000000000100 ) ; #852 =( LENGTH_UNIT ( ) NAMED_UNIT ( * ) SI_UNIT ( .MILLI., .METRE. ) ); #853 = MECHANICAL_DESIGN_GEOMETRIC_PRESENTATION_REPRESENTATION ( '', ( #855 ), #759 ) ; #854 = PRESENTATION_LAYER_ASSIGNMENT ( '', '', ( #855 ) ) ; #855 = STYLED_ITEM ( 'NONE', ( #856 ), #5038 ) ; #856 = PRESENTATION_STYLE_ASSIGNMENT (( #857 ) ) ; #857 = SURFACE_STYLE_USAGE ( .BOTH. , #858 ) ; #858 = SURFACE_SIDE_STYLE ('',( #844 ) ) ; #859 = LINE ( 'NONE', #862, #851 ) ; #860 = VECTOR ( 'NONE', #865, 1000.000000000000000 ) ; #861 = CARTESIAN_POINT ( 'NONE', ( -0.4799178465506506200, 1.442144520634609500, 0.04311369527748056000 ) ) ; #862 = CARTESIAN_POINT ( 'NONE', ( -0.4799178465506501700, 0.2737445206345858200, -6.103686304722515400 ) ) ; #863 = CARTESIAN_POINT ( 'NONE', ( -4.237517846550652200, -1.647855479365389500, 0.7289136952774795100 ) ) ; #864 = LINE ( 'NONE', #861, #849 ) ; #865 = DIRECTION ( 'NONE', ( 1.000000000000000000, 0.0000000000000000000, 0.0000000000000000000 ) ) ; #866 = DIRECTION ( 'NONE', ( 1.921789193134769600E-016, -0.7071067811865461300, 0.7071067811865489100 ) ) ; #867 = SURFACE_STYLE_USAGE ( .BOTH. , #868 ) ; #868 = SURFACE_SIDE_STYLE ('',( #869 ) ) ; #869 = SURFACE_STYLE_FILL_AREA ( #883 ) ; #870 = COLOUR_RGB ( '',0.7960784313725489700, 0.8235294117647058400, 0.9372549019607843100 ) ; #871 = FACE_OUTER_BOUND ( 'NONE', #4936, .T. ) ; #872 = AXIS2_PLACEMENT_3D ( 'NONE', #882, #874, #881 ) ; #873 = CYLINDRICAL_SURFACE ( 'NONE', #872, 0.4826000000000002000 ) ; #874 = DIRECTION ( 'NONE', ( 2.775557561562890900E-016, -1.000000000000000000, -1.621377732827185800E-016 ) ) ; #875 =( LENGTH_UNIT ( ) NAMED_UNIT ( * ) SI_UNIT ( .MILLI., .METRE. ) ); #876 = MECHANICAL_DESIGN_GEOMETRIC_PRESENTATION_REPRESENTATION ( '', ( #878 ), #885 ) ; #877 = PRESENTATION_LAYER_ASSIGNMENT ( '', '', ( #878 ) ) ; #878 = STYLED_ITEM ( 'NONE', ( #879 ), #5039 ) ; #879 = PRESENTATION_STYLE_ASSIGNMENT (( #867 ) ) ; #880 = FILL_AREA_STYLE_COLOUR ( '', #870 ) ; #881 = DIRECTION ( 'NONE', ( 0.0000000000000000000, 0.0000000000000000000, 1.000000000000000000 ) ) ; #882 = CARTESIAN_POINT ( 'NONE', ( -0.9625178465506524200, 6.420544520634610600, -0.3886863047225181400 ) ) ; #883 = FILL_AREA_STYLE ('',( #880 ) ) ; #884 = PLANE ( 'NONE', #889 ) ; #885 =( GEOMETRIC_REPRESENTATION_CONTEXT ( 3 ) GLOBAL_UNCERTAINTY_ASSIGNED_CONTEXT ( ( #894 ) ) GLOBAL_UNIT_ASSIGNED_CONTEXT ( ( #875, #764, #893 ) ) REPRESENTATION_CONTEXT ( 'NONE', 'WORKASPACE' ) ); #886 = CARTESIAN_POINT ( 'NONE', ( -3.451717846550651700, 6.420544520634610600, 0.4241136952774812700 ) ) ; #887 = DIRECTION ( 'NONE', ( 5.773722060964636400E-018, 1.621377732827185500E-016, -1.000000000000000000 ) ) ; #888 = DIRECTION ( 'NONE', ( -2.775557561562890900E-016, 1.000000000000000000, 1.621377732827185500E-016 ) ) ; #889 = AXIS2_PLACEMENT_3D ( 'NONE', #886, #888, #887 ) ; #890 = CARTESIAN_POINT ( 'NONE', ( 4.347682153449347300, -1.647855479365389500, 0.7289136952774799600 ) ) ; #891 = CARTESIAN_POINT ( 'NONE', ( -4.137517846550649900, 1.442144520634609500, 0.04311369527748056000 ) ) ; #892 = LINE ( 'NONE', #891, #896 ) ; #893 =( NAMED_UNIT ( * ) SI_UNIT ( $, .STERADIAN. ) SOLID_ANGLE_UNIT ( ) ); #894 = UNCERTAINTY_MEASURE_WITH_UNIT (LENGTH_MEASURE( 1.000000000000000100E-005 ), #875, 'distance_accuracy_value', 'NONE'); #895 =( NAMED_UNIT ( * ) SI_UNIT ( $, .STERADIAN. ) SOLID_ANGLE_UNIT ( ) ); #896 = VECTOR ( 'NONE', #899, 1000.000000000000000 ) ; #897 =( NAMED_UNIT ( * ) PLANE_ANGLE_UNIT ( ) SI_UNIT ( $, .RADIAN. ) ); #898 = UNCERTAINTY_MEASURE_WITH_UNIT (LENGTH_MEASURE( 1.000000000000000100E-005 ), #914, 'distance_accuracy_value', 'NONE'); #899 = DIRECTION ( 'NONE', ( 5.773722060964636400E-018, 1.621377732827185500E-016, -1.000000000000000000 ) ) ; #900 = LINE ( 'NONE', #938, #902 ) ; #901 =( GEOMETRIC_REPRESENTATION_CONTEXT ( 3 ) GLOBAL_UNCERTAINTY_ASSIGNED_CONTEXT ( ( #930 ) ) GLOBAL_UNIT_ASSIGNED_CONTEXT ( ( #904, #924, #923 ) ) REPRESENTATION_CONTEXT ( 'NONE', 'WORKASPACE' ) ); #902 = VECTOR ( 'NONE', #936, 1000.000000000000000 ) ; #903 = FILL_AREA_STYLE_COLOUR ( '', #934 ) ; #904 =( LENGTH_UNIT ( ) NAMED_UNIT ( * ) SI_UNIT ( .MILLI., .METRE. ) ); #905 = MECHANICAL_DESIGN_GEOMETRIC_PRESENTATION_REPRESENTATION ( '', ( #926 ), #901 ) ; #906 = COLOUR_RGB ( '',0.7960784313725489700, 0.8235294117647058400, 0.9372549019607843100 ) ; #907 = FACE_OUTER_BOUND ( 'NONE', #5056, .T. ) ; #908 = DIRECTION ( 'NONE', ( 5.773722060964636400E-018, 1.621377732827185500E-016, -1.000000000000000000 ) ) ; #909 = DIRECTION ( 'NONE', ( -2.775557561562890900E-016, 1.000000000000000000, 1.621377732827185500E-016 ) ) ; #910 = FILL_AREA_STYLE ('',( #911 ) ) ; #911 = FILL_AREA_STYLE_COLOUR ( '', #906 ) ; #912 = CARTESIAN_POINT ( 'NONE', ( -4.137517846550649000, -1.580455479365391100, 0.04311369527748001900 ) ) ; #913 = VECTOR ( 'NONE', #931, 1000.000000000000000 ) ; #914 =( LENGTH_UNIT ( ) NAMED_UNIT ( * ) SI_UNIT ( .MILLI., .METRE. ) ); #915 = MECHANICAL_DESIGN_GEOMETRIC_PRESENTATION_REPRESENTATION ( '', ( #917 ), #1253 ) ; #916 = PRESENTATION_LAYER_ASSIGNMENT ( '', '', ( #917 ) ) ; #917 = STYLED_ITEM ( 'NONE', ( #918 ), #5055 ) ; #918 = PRESENTATION_STYLE_ASSIGNMENT (( #919 ) ) ; #919 = SURFACE_STYLE_USAGE ( .BOTH. , #920 ) ; #920 = SURFACE_SIDE_STYLE ('',( #921 ) ) ; #921 = SURFACE_STYLE_FILL_AREA ( #910 ) ; #922 = CARTESIAN_POINT ( 'NONE', ( 7.573482153449347700, 0.8921445206346105800, -1.785686304722517100 ) ) ; #923 =( NAMED_UNIT ( * ) SI_UNIT ( $, .STERADIAN. ) SOLID_ANGLE_UNIT ( ) ); #924 =( NAMED_UNIT ( * ) PLANE_ANGLE_UNIT ( ) SI_UNIT ( $, .RADIAN. ) ); #925 = PRESENTATION_LAYER_ASSIGNMENT ( '', '', ( #926 ) ) ; #926 = STYLED_ITEM ( 'NONE', ( #927 ), #5052 ) ; #927 = PRESENTATION_STYLE_ASSIGNMENT (( #928 ) ) ; #928 = SURFACE_STYLE_USAGE ( .BOTH. , #929 ) ; #929 = SURFACE_SIDE_STYLE ('',( #932 ) ) ; #930 = UNCERTAINTY_MEASURE_WITH_UNIT (LENGTH_MEASURE( 1.000000000000000100E-005 ), #904, 'distance_accuracy_value', 'NONE'); #931 = DIRECTION ( 'NONE', ( -0.0000000000000000000, -0.0000000000000000000, -1.000000000000000000 ) ) ; #932 = SURFACE_STYLE_FILL_AREA ( #933 ) ; #933 = FILL_AREA_STYLE ('',( #903 ) ) ; #934 = COLOUR_RGB ( '',0.7960784313725489700, 0.8235294117647058400, 0.9372549019607843100 ) ; #935 = FACE_OUTER_BOUND ( 'NONE', #5053, .T. ) ; #936 = DIRECTION ( 'NONE', ( 5.773722060964636400E-018, 1.621377732827185500E-016, -1.000000000000000000 ) ) ; #937 = LINE ( 'NONE', #922, #913 ) ; #938 = CARTESIAN_POINT ( 'NONE', ( -0.8609178465506517300, 6.420544520634610600, 0.7289136952774809600 ) ) ; #939 = PLANE ( 'NONE', #941 ) ; #940 = CARTESIAN_POINT ( 'NONE', ( -0.8609178465506517300, 6.420544520634610600, 0.7289136952774809600 ) ) ; #941 = AXIS2_PLACEMENT_3D ( 'NONE', #940, #909, #908 ) ; #942 = VECTOR ( 'NONE', #945, 1000.000000000000000 ) ; #943 = CARTESIAN_POINT ( 'NONE', ( -5.444017846550655000, 0.8921445206346105800, -2.903286304722517000 ) ) ; #944 = LINE ( 'NONE', #943, #942 ) ; #945 = DIRECTION ( 'NONE', ( -1.000000000000000000, -0.0000000000000000000, -0.0000000000000000000 ) ) ; #946 =( LENGTH_UNIT ( ) NAMED_UNIT ( * ) SI_UNIT ( .MILLI., .METRE. ) ); #947 = MECHANICAL_DESIGN_GEOMETRIC_PRESENTATION_REPRESENTATION ( '', ( #949 ), #973 ) ; #948 = PRESENTATION_LAYER_ASSIGNMENT ( '', '', ( #949 ) ) ; #949 = STYLED_ITEM ( 'NONE', ( #950 ), #5315 ) ; #950 = PRESENTATION_STYLE_ASSIGNMENT (( #951 ) ) ; #951 = SURFACE_STYLE_USAGE ( .BOTH. , #952 ) ; #952 = SURFACE_SIDE_STYLE ('',( #953 ) ) ; #953 = SURFACE_STYLE_FILL_AREA ( #954 ) ; #954 = FILL_AREA_STYLE ('',( #961 ) ) ; #955 = COLOUR_RGB ( '',0.7960784313725489700, 0.8235294117647058400, 0.9372549019607843100 ) ; #956 = FACE_OUTER_BOUND ( 'NONE', #5316, .T. ) ; #957 = DIRECTION ( 'NONE', ( 1.000000000000000000, 0.0000000000000000000, -5.606166404184160800E-017 ) ) ; #958 = VECTOR ( 'NONE', #957, 1000.000000000000000 ) ; #959 = CARTESIAN_POINT ( 'NONE', ( 3.917482153449351100, -1.580455479365387300, -0.08388630472251905300 ) ) ; #960 = LINE ( 'NONE', #959, #958 ) ; #961 = FILL_AREA_STYLE_COLOUR ( '', #955 ) ; #962 = VECTOR ( 'NONE', #965, 1000.000000000000000 ) ; #963 = LINE ( 'NONE', #964, #962 ) ; #964 = CARTESIAN_POINT ( 'NONE', ( 7.930682153449351900, -4.755455479365387800, -1.455486304722520200 ) ) ; #965 = DIRECTION ( 'NONE', ( -2.775557561562890900E-016, 1.000000000000000000, 5.993114065094845700E-017 ) ) ; #966 =( NAMED_UNIT ( * ) PLANE_ANGLE_UNIT ( ) SI_UNIT ( $, .RADIAN. ) ); #967 = UNCERTAINTY_MEASURE_WITH_UNIT (LENGTH_MEASURE( 1.000000000000000100E-005 ), #946, 'distance_accuracy_value', 'NONE'); #968 =( NAMED_UNIT ( * ) SI_UNIT ( $, .STERADIAN. ) SOLID_ANGLE_UNIT ( ) ); #969 = UNCERTAINTY_MEASURE_WITH_UNIT (LENGTH_MEASURE( 1.000000000000000100E-005 ), #1539, 'distance_accuracy_value', 'NONE'); #970 =( NAMED_UNIT ( * ) SI_UNIT ( $, .STERADIAN. ) SOLID_ANGLE_UNIT ( ) ); #971 =( NAMED_UNIT ( * ) PLANE_ANGLE_UNIT ( ) SI_UNIT ( $, .RADIAN. ) ); #972 =( NAMED_UNIT ( * ) PLANE_ANGLE_UNIT ( ) SI_UNIT ( $, .RADIAN. ) ); #973 =( GEOMETRIC_REPRESENTATION_CONTEXT ( 3 ) GLOBAL_UNCERTAINTY_ASSIGNED_CONTEXT ( ( #967 ) ) GLOBAL_UNIT_ASSIGNED_CONTEXT ( ( #946, #971, #970 ) ) REPRESENTATION_CONTEXT ( 'NONE', 'WORKASPACE' ) ); #974 = AXIS2_PLACEMENT_3D ( 'NONE', #997, #975, #1001 ) ; #975 = DIRECTION ( 'NONE', ( 2.359031401440604700E-016, -0.7071067811865490200, 0.7071067811865460200 ) ) ; #976 =( GEOMETRIC_REPRESENTATION_CONTEXT ( 3 ) GLOBAL_UNCERTAINTY_ASSIGNED_CONTEXT ( ( #969 ) ) GLOBAL_UNIT_ASSIGNED_CONTEXT ( ( #1539, #966, #968 ) ) REPRESENTATION_CONTEXT ( 'NONE', 'WORKASPACE' ) ); #977 = VECTOR ( 'NONE', #987, 1000.000000000000000 ) ; #978 = DIRECTION ( 'NONE', ( -2.775557561562890900E-016, 1.000000000000000000, -7.666125903226468000E-017 ) ) ; #979 = VECTOR ( 'NONE', #978, 1000.000000000000000 ) ; #980 = SURFACE_STYLE_FILL_AREA ( #995 ) ; #981 = COLOUR_RGB ( '',0.7960784313725489700, 0.8235294117647058400, 0.9372549019607843100 ) ; #982 = MECHANICAL_DESIGN_GEOMETRIC_PRESENTATION_REPRESENTATION ( '', ( #1005 ), #1007 ) ; #983 = UNCERTAINTY_MEASURE_WITH_UNIT (LENGTH_MEASURE( 1.000000000000000100E-005 ), #1009, 'distance_accuracy_value', 'NONE'); #984 = PLANE ( 'NONE', #998 ) ; #985 = DIRECTION ( 'NONE', ( 5.606166404184158300E-017, 7.666125903226469200E-017, 1.000000000000000000 ) ) ; #986 = CARTESIAN_POINT ( 'NONE', ( 3.917482153449351100, -1.580455479365387300, -0.08388630472251905300 ) ) ; #987 = DIRECTION ( 'NONE', ( 0.0000000000000000000, -1.000000000000000000, -1.707404996040164300E-016 ) ) ; #988 = PRESENTATION_STYLE_ASSIGNMENT (( #989 ) ) ; #990 = CARTESIAN_POINT ( 'NONE', ( 3.890482153449347400, 0.8921445206346105800, 0.7289136952774799600 ) ) ; #989 = SURFACE_STYLE_USAGE ( .BOTH. , #991 ) ; #991 = SURFACE_SIDE_STYLE ('',( #980 ) ) ; #992 = CARTESIAN_POINT ( 'NONE', ( 7.625882153449348200, 6.420544520634614100, -0.08388630472251981700 ) ) ; #993 = LINE ( 'NONE', #992, #979 ) ; #994 = LINE ( 'NONE', #990, #977 ) ; #995 = FILL_AREA_STYLE ('',( #1002 ) ) ; #996 =( NAMED_UNIT ( * ) SI_UNIT ( $, .STERADIAN. ) SOLID_ANGLE_UNIT ( ) ); #997 = CARTESIAN_POINT ( 'NONE', ( 3.917482153449352000, -4.374455479365387600, -0.08388630472251873400 ) ) ; #998 = AXIS2_PLACEMENT_3D ( 'NONE', #986, #985, #1010 ) ; #999 = DIRECTION ( 'NONE', ( 2.775557561562890900E-016, -1.000000000000000000, 7.776281064261323500E-017 ) ) ; #1000 = VECTOR ( 'NONE', #999, 1000.000000000000000 ) ; #1001 = DIRECTION ( 'NONE', ( -1.566199745268830900E-016, 0.7071067811865460200, 0.7071067811865490200 ) ) ; #1002 = FILL_AREA_STYLE_COLOUR ( '', #981 ) ; #1003 = FACE_OUTER_BOUND ( 'NONE', #5321, .T. ) ; #1004 = PRESENTATION_LAYER_ASSIGNMENT ( '', '', ( #1005 ) ) ; #1005 = STYLED_ITEM ( 'NONE', ( #988 ), #5320 ) ; #1006 = PLANE ( 'NONE', #974 ) ; #1007 =( GEOMETRIC_REPRESENTATION_CONTEXT ( 3 ) GLOBAL_UNCERTAINTY_ASSIGNED_CONTEXT ( ( #983 ) ) GLOBAL_UNIT_ASSIGNED_CONTEXT ( ( #1009, #972, #996 ) ) REPRESENTATION_CONTEXT ( 'NONE', 'WORKASPACE' ) ); #1008 = CARTESIAN_POINT ( 'NONE', ( 7.625882153449351700, -4.755455479365386900, -0.4648863047225209600 ) ) ; #1009 =( LENGTH_UNIT ( ) NAMED_UNIT ( * ) SI_UNIT ( .MILLI., .METRE. ) ); #1010 = DIRECTION ( 'NONE', ( -2.775557561562890900E-016, 1.000000000000000000, -7.666125903226468000E-017 ) ) ; #1011 = LINE ( 'NONE', #1013, #1017 ) ; #1012 = DIRECTION ( 'NONE', ( 1.000000000000000000, 1.705445482763587300E-031, -2.901736657442119600E-015 ) ) ; #1013 = CARTESIAN_POINT ( 'NONE', ( 7.930682153449350100, -0.1326554793653869900, 0.04311369527748099000 ) ) ; #1014 = CARTESIAN_POINT ( 'NONE', ( 7.625882153449348200, 6.420544520634614100, -0.08388630472251938600 ) ) ; #1015 = LINE ( 'NONE', #1014, #1000 ) ; #1016 = DIRECTION ( 'NONE', ( -5.606166404184162000E-017, 5.993114065094840700E-017, -1.000000000000000000 ) ) ; #1017 = VECTOR ( 'NONE', #1016, 1000.000000000000000 ) ; #1018 = LINE ( 'NONE', #1019, #1021 ) ; #1019 = CARTESIAN_POINT ( 'NONE', ( 7.930682153449351900, -4.755455479365387800, -1.074486304722519300 ) ) ; #1020 = CARTESIAN_POINT ( 'NONE', ( 7.625882153449350800, -4.755455479365387800, -1.074486304722518200 ) ) ; #1021 = VECTOR ( 'NONE', #1012, 1000.000000000000000 ) ; #1022 = CARTESIAN_POINT ( 'NONE', ( 7.625882153449350800, -1.580455479365387300, -0.08388630472251927500 ) ) ; #1023 = CARTESIAN_POINT ( 'NONE', ( 7.625882153449351700, -4.374455479365385800, -0.08388630472251905300 ) ) ; #1024 = CARTESIAN_POINT ( 'NONE', ( 7.930682153438154600, -1.853216928145228600, -0.7649217471639049300 ) ) ; #1025 = CARTESIAN_POINT ( 'NONE', ( 3.968282153460548100, -1.853216928145228600, -0.7649217471639049300 ) ) ; #1026 = FACE_OUTER_BOUND ( 'NONE', #5341, .T. ) ; #1027 = LINE ( 'NONE', #1033, #1031 ) ; #1028 = FILL_AREA_STYLE_COLOUR ( '', #1029 ) ; #1029 = COLOUR_RGB ( '',0.7960784313725489700, 0.8235294117647058400, 0.9372549019607843100 ) ; #1030 = DIRECTION ( 'NONE', ( 5.606166404184162000E-017, -5.993114065094840700E-017, 1.000000000000000000 ) ) ; #1031 = VECTOR ( 'NONE', #1030, 1000.000000000000000 ) ; #1032 = VECTOR ( 'NONE', #1039, 1000.000000000000000 ) ; #1033 = CARTESIAN_POINT ( 'NONE', ( 7.930682153449350100, 1.442144520634612800, 0.04311369527748110100 ) ) ; #1034 = LINE ( 'NONE', #1040, #1032 ) ; #1035 = SURFACE_STYLE_USAGE ( .BOTH. , #1036 ) ; #1036 = SURFACE_SIDE_STYLE ('',( #1037 ) ) ; #1037 = SURFACE_STYLE_FILL_AREA ( #1038 ) ; #1038 = FILL_AREA_STYLE ('',( #1028 ) ) ; #1039 = DIRECTION ( 'NONE', ( 1.000000000000000000, 1.705445482763587300E-031, -2.901736657442119600E-015 ) ) ; #1040 = CARTESIAN_POINT ( 'NONE', ( 7.625882153449349900, -0.1326554793653867700, -1.455486304722518800 ) ) ; #1041 = MECHANICAL_DESIGN_GEOMETRIC_PRESENTATION_REPRESENTATION ( '', ( #1043 ), #1045 ) ; #1042 = PRESENTATION_LAYER_ASSIGNMENT ( '', '', ( #1043 ) ) ; #1043 = STYLED_ITEM ( 'NONE', ( #1044 ), #5340 ) ; #1044 = PRESENTATION_STYLE_ASSIGNMENT (( #1035 ) ) ; #1045 =( GEOMETRIC_REPRESENTATION_CONTEXT ( 3 ) GLOBAL_UNCERTAINTY_ASSIGNED_CONTEXT ( ( #1046 ) ) GLOBAL_UNIT_ASSIGNED_CONTEXT ( ( #1051, #1056, #1070 ) ) REPRESENTATION_CONTEXT ( 'NONE', 'WORKASPACE' ) ); #1046 = UNCERTAINTY_MEASURE_WITH_UNIT (LENGTH_MEASURE( 1.000000000000000100E-005 ), #1051, 'distance_accuracy_value', 'NONE'); #1047 = SURFACE_STYLE_USAGE ( .BOTH. , #1048 ) ; #1048 = SURFACE_SIDE_STYLE ('',( #1049 ) ) ; #1049 = SURFACE_STYLE_FILL_AREA ( #1050 ) ; #1050 = FILL_AREA_STYLE ('',( #1057 ) ) ; #1051 =( LENGTH_UNIT ( ) NAMED_UNIT ( * ) SI_UNIT ( .MILLI., .METRE. ) ); #1052 = MECHANICAL_DESIGN_GEOMETRIC_PRESENTATION_REPRESENTATION ( '', ( #1054 ), #1072 ) ; #1053 = PRESENTATION_LAYER_ASSIGNMENT ( '', '', ( #1054 ) ) ; #1054 = STYLED_ITEM ( 'NONE', ( #1055 ), #5346 ) ; #1055 = PRESENTATION_STYLE_ASSIGNMENT (( #1047 ) ) ; #1056 =( NAMED_UNIT ( * ) PLANE_ANGLE_UNIT ( ) SI_UNIT ( $, .RADIAN. ) ); #1057 = FILL_AREA_STYLE_COLOUR ( '', #1058 ) ; #1058 = COLOUR_RGB ( '',0.7960784313725489700, 0.8235294117647058400, 0.9372549019607843100 ) ; #1059 = FACE_OUTER_BOUND ( 'NONE', #5322, .T. ) ; #1060 = DIRECTION ( 'NONE', ( 1.000000000000000000, 0.0000000000000000000, -5.606166404184160800E-017 ) ) ; #1061 = VECTOR ( 'NONE', #1060, 1000.000000000000000 ) ; #1062 = CARTESIAN_POINT ( 'NONE', ( 7.930682153449351900, -4.374455479365387600, -0.08388630472251895600 ) ) ; #1063 = CARTESIAN_POINT ( 'NONE', ( 7.930682153449351900, -4.374455479365387600, -0.08388630472251873400 ) ) ; #1064 = DIRECTION ( 'NONE', ( 2.359031401440597800E-016, -0.7071067811865460200, 0.7071067811865490200 ) ) ; #1065 = DIRECTION ( 'NONE', ( -1.855576110359431800E-015, -0.7071067811865490200, -0.7071067811865460200 ) ) ; #1066 = CARTESIAN_POINT ( 'NONE', ( 7.625882153449350800, -4.374455479365387600, -1.455486304722519300 ) ) ; #1067 = AXIS2_PLACEMENT_3D ( 'NONE', #1066, #1065, #1064 ) ; #1068 = PLANE ( 'NONE', #1067 ) ; #1069 = LINE ( 'NONE', #1062, #1061 ) ; #1070 =( NAMED_UNIT ( * ) SI_UNIT ( $, .STERADIAN. ) SOLID_ANGLE_UNIT ( ) ); #1071 =( NAMED_UNIT ( * ) PLANE_ANGLE_UNIT ( ) SI_UNIT ( $, .RADIAN. ) ); #1072 =( GEOMETRIC_REPRESENTATION_CONTEXT ( 3 ) GLOBAL_UNCERTAINTY_ASSIGNED_CONTEXT ( ( #1087 ) ) GLOBAL_UNIT_ASSIGNED_CONTEXT ( ( #1086, #1071, #1074 ) ) REPRESENTATION_CONTEXT ( 'NONE', 'WORKASPACE' ) ); #1073 = DIRECTION ( 'NONE', ( 6.095048960246059200E-033, 1.000000000000000000, 1.087204431837239300E-016 ) ) ; #1074 =( NAMED_UNIT ( * ) SI_UNIT ( $, .STERADIAN. ) SOLID_ANGLE_UNIT ( ) ); #1075 = DIRECTION ( 'NONE', ( -1.000000000000000000, 0.0000000000000000000, 5.606166404184160800E-017 ) ) ; #1076 = AXIS2_PLACEMENT_3D ( 'NONE', #1085, #1075, #1073 ) ; #1077 = AXIS2_PLACEMENT_3D ( 'NONE', #1084, #1083, #1082 ) ; #1078 = CIRCLE ( 'NONE', #1077, 0.3809999999999998900 ) ; #1079 = AXIS2_PLACEMENT_3D ( 'NONE', #1099, #1093, #1092 ) ; #1080 = TOROIDAL_SURFACE ( 'NONE', #1076, 0.4892385512201587500, 0.5080000000000000100 ) ; #1081 = CIRCLE ( 'NONE', #1079, 0.5588000000000014100 ) ; #1082 = DIRECTION ( 'NONE', ( 0.0000000000000000000, 0.0000000000000000000, 1.000000000000000000 ) ) ; #1083 = DIRECTION ( 'NONE', ( 2.775557561562890900E-016, -1.000000000000000000, -5.993114065094845700E-017 ) ) ; #1084 = CARTESIAN_POINT ( 'NONE', ( 4.654082153449350800, -1.580455479365387300, 0.04311369527748099000 ) ) ; #1085 = CARTESIAN_POINT ( 'NONE', ( 4.476282153460547700, -2.342455479365387600, -0.7649217471639049300 ) ) ; #1086 =( LENGTH_UNIT ( ) NAMED_UNIT ( * ) SI_UNIT ( .MILLI., .METRE. ) ); #1087 = UNCERTAINTY_MEASURE_WITH_UNIT (LENGTH_MEASURE( 1.000000000000000100E-005 ), #1086, 'distance_accuracy_value', 'NONE'); #1088 = DIRECTION ( 'NONE', ( -2.775557561562890900E-016, 1.000000000000000000, -7.666125903226468000E-017 ) ) ; #1089 = CARTESIAN_POINT ( 'NONE', ( 7.930682153449348300, 6.420544520634614100, -0.08388630472251981700 ) ) ; #1090 = LINE ( 'NONE', #1089, #1094 ) ; #1091 = CIRCLE ( 'NONE', #1138, 0.2540000000000013900 ) ; #1092 = DIRECTION ( 'NONE', ( 0.0000000000000000000, 0.0000000000000000000, 1.000000000000000000 ) ) ; #1093 = DIRECTION ( 'NONE', ( -9.361384385181154300E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
uracy_value', 'NONE'); #1147 = FILL_AREA_STYLE ('',( #1162 ) ) ; #1148 = PRESENTATION_STYLE_ASSIGNMENT (( #1154 ) ) ; #1149 =( NAMED_UNIT ( * ) SI_UNIT ( $, .STERADIAN. ) SOLID_ANGLE_UNIT ( ) ); #1150 = COLOUR_RGB ( '',0.7960784313725489700, 0.8235294117647058400, 0.9372549019607843100 ) ; #1151 = MECHANICAL_DESIGN_GEOMETRIC_PRESENTATION_REPRESENTATION ( '', ( #1160 ), #1155 ) ; #1152 = PRESENTATION_LAYER_ASSIGNMENT ( '', '', ( #1160 ) ) ; #1153 = CIRCLE ( 'NONE', #1156, 0.3587749375614497900 ) ; #1154 = SURFACE_STYLE_USAGE ( .BOTH. , #1161 ) ; #1155 =( GEOMETRIC_REPRESENTATION_CONTEXT ( 3 ) GLOBAL_UNCERTAINTY_ASSIGNED_CONTEXT ( ( #1146 ) ) GLOBAL_UNIT_ASSIGNED_CONTEXT ( ( #1163, #1158, #1149 ) ) REPRESENTATION_CONTEXT ( 'NONE', 'WORKASPACE' ) ); #1156 = AXIS2_PLACEMENT_3D ( 'NONE', #1164, #1165, #1145 ) ; #1157 = SURFACE_STYLE_FILL_AREA ( #1147 ) ; #1158 =( NAMED_UNIT ( * ) PLANE_ANGLE_UNIT ( ) SI_UNIT ( $, .RADIAN. ) ); #1159 = FACE_OUTER_BOUND ( 'NONE', #5542, .T. ) ; #1160 = STYLED_ITEM ( 'NONE', ( #1148 ), #5375 ) ; #1161 = SURFACE_SIDE_STYLE ('',( #1157 ) ) ; #1162 = FILL_AREA_STYLE_COLOUR ( '', #1150 ) ; #1163 =( LENGTH_UNIT ( ) NAMED_UNIT ( * ) SI_UNIT ( .MILLI., .METRE. ) ); #1164 = CARTESIAN_POINT ( 'NONE', ( 7.578468820104820500, -2.342455479365387600, -0.7649217471639049300 ) ) ; #1165 = DIRECTION ( 'NONE', ( -1.000000000000000000, -0.0000000000000000000, 5.606166404184160800E-017 ) ) ; #1166 = DIRECTION ( 'NONE', ( 0.0000000000000000000, 0.0000000000000000000, 1.000000000000000000 ) ) ; #1167 = DIRECTION ( 'NONE', ( 0.0000000000000000000, -1.000000000000000000, 0.0000000000000000000 ) ) ; #1168 = CARTESIAN_POINT ( 'NONE', ( 8.006882153438155600, -2.342455479365387600, -0.7649217471639051500 ) ) ; #1169 = AXIS2_PLACEMENT_3D ( 'NONE', #1168, #1167, #1166 ) ; #1170 = SPHERICAL_SURFACE ( 'NONE', #1169, 0.5588000000000014100 ) ; #1171 = SURFACE_STYLE_FILL_AREA ( #1172 ) ; #1172 = FILL_AREA_STYLE ('',( #1202 ) ) ; #1173 = COLOUR_RGB ( '',0.7960784313725489700, 0.8235294117647058400, 0.9372549019607843100 ) ; #1174 = FACE_OUTER_BOUND ( 'NONE', #5476, .T. ) ; #1175 = DIRECTION ( 'NONE', ( 2.775557561562890900E-016, -1.000000000000000000, -5.993114065094845700E-017 ) ) ; #1176 = VECTOR ( 'NONE', #1175, 1000.000000000000000 ) ; #1177 = UNCERTAINTY_MEASURE_WITH_UNIT (LENGTH_MEASURE( 1.000000000000000100E-005 ), #1233, 'distance_accuracy_value', 'NONE'); #1178 = CIRCLE ( 'NONE', #1450, 0.5080000000000000100 ) ; #1179 = CIRCLE ( 'NONE', #1285, 0.5080000000000002300 ) ; #1180 =( GEOMETRIC_REPRESENTATION_CONTEXT ( 3 ) GLOBAL_UNCERTAINTY_ASSIGNED_CONTEXT ( ( #1177 ) ) GLOBAL_UNIT_ASSIGNED_CONTEXT ( ( #1233, #1206, #1205 ) ) REPRESENTATION_CONTEXT ( 'NONE', 'WORKASPACE' ) ); #1181 = DIRECTION ( 'NONE', ( -5.773722060964641000E-018, -3.967713790048084500E-017, 1.000000000000000000 ) ) ; #1182 = DIRECTION ( 'NONE', ( -1.000000000000000000, -0.0000000000000000000, -5.773722060964641000E-018 ) ) ; #1183 = SURFACE_STYLE_USAGE ( .BOTH. , #1184 ) ; #1184 = SURFACE_SIDE_STYLE ('',( #1185 ) ) ; #1185 = SURFACE_STYLE_FILL_AREA ( #1186 ) ; #1186 = FILL_AREA_STYLE ('',( #1214 ) ) ; #1187 = CIRCLE ( 'NONE', #1221, 0.3587749375614497900 ) ; #1188 = AXIS2_PLACEMENT_3D ( 'NONE', #1237, #1236, #1213 ) ; #1189 = DIRECTION ( 'NONE', ( 0.0000000000000000000, 0.0000000000000000000, -1.000000000000000000 ) ) ; #1190 = MECHANICAL_DESIGN_GEOMETRIC_PRESENTATION_REPRESENTATION ( '', ( #1192 ), #1180 ) ; #1191 = PRESENTATION_LAYER_ASSIGNMENT ( '', '', ( #1192 ) ) ; #1192 = STYLED_ITEM ( 'NONE', ( #1193 ), #5399 ) ; #1193 = PRESENTATION_STYLE_ASSIGNMENT (( #1194 ) ) ; #1194 = SURFACE_STYLE_USAGE ( .BOTH. , #1195 ) ; #1195 = SURFACE_SIDE_STYLE ('',( #1171 ) ) ; #1196 = CARTESIAN_POINT ( 'NONE', ( -0.6831178465618461500, -2.831694030585549400, -0.7649217471639060400 ) ) ; #1197 = CARTESIAN_POINT ( 'NONE', ( -0.5273311798951795200, -2.342455479365390700, -0.7649217471639060400 ) ) ; #1198 = CARTESIAN_POINT ( 'NONE', ( -0.2936511798951790800, -2.342455479365390700, -0.9280012642372930100 ) ) ; #1199 = CIRCLE ( 'NONE', #1232, 0.2032000000000001600 ) ; #1200 = CARTESIAN_POINT ( 'NONE', ( 7.625882153449348200, 6.420544520634614100, -0.3886863047225181400 ) ) ; #1201 = LINE ( 'NONE', #1200, #1176 ) ; #1202 = FILL_AREA_STYLE_COLOUR ( '', #1173 ) ; #1203 = DIRECTION ( 'NONE', ( 5.606166404184162000E-017, -5.993114065094840700E-017, 1.000000000000000000 ) ) ; #1204 =( NAMED_UNIT ( * ) SI_UNIT ( $, .STERADIAN. ) SOLID_ANGLE_UNIT ( ) ); #1205 =( NAMED_UNIT ( * ) SI_UNIT ( $, .STERADIAN. ) SOLID_ANGLE_UNIT ( ) ); #1206 =( NAMED_UNIT ( * ) PLANE_ANGLE_UNIT ( ) SI_UNIT ( $, .RADIAN. ) ); #1207 = PRESENTATION_LAYER_ASSIGNMENT ( '', '', ( #1208 ) ) ; #1208 = STYLED_ITEM ( 'NONE', ( #1209 ), #5391 ) ; #1209 = PRESENTATION_STYLE_ASSIGNMENT (( #1183 ) ) ; #1210 = DIRECTION ( 'NONE', ( -3.324151898235040700E-016, 1.000000000000000000, 0.0000000000000000000 ) ) ; #1211 = FACE_OUTER_BOUND ( 'NONE', #5454, .T. ) ; #1212 = CARTESIAN_POINT ( 'NONE', ( -0.5273311798951795200, -2.701230416926840000, -0.7649217471639060400 ) ) ; #1213 = DIRECTION ( 'NONE', ( 0.0000000000000000000, 0.0000000000000000000, -1.000000000000000000 ) ) ; #1214 = FILL_AREA_STYLE_COLOUR ( '', #1215 ) ; #1215 = COLOUR_RGB ( '',0.7960784313725489700, 0.8235294117647058400, 0.9372549019607843100 ) ; #1216 = FACE_BOUND ( 'NONE', #5451, .T. ) ; #1217 = AXIS2_PLACEMENT_3D ( 'NONE', #1219, #1182, #1210 ) ; #1218 = CARTESIAN_POINT ( 'NONE', ( -0.3529178465618459400, -2.342455479365390700, -0.7649217471639060400 ) ) ; #1219 = CARTESIAN_POINT ( 'NONE', ( -0.2936511798951790800, -2.342455479365390700, -0.7649217471639060400 ) ) ; #1220 = PLANE ( 'NONE', #1229 ) ; #1221 = AXIS2_PLACEMENT_3D ( 'NONE', #1197, #1228, #1189 ) ; #1222 = UNCERTAINTY_MEASURE_WITH_UNIT (LENGTH_MEASURE( 1.000000000000000100E-005 ), #1234, 'distance_accuracy_value', 'NONE'); #1223 = CIRCLE ( 'NONE', #1188, 0.4892385512201588600 ) ; #1224 = DIRECTION ( 'NONE', ( 0.0000000000000000000, -1.000000000000000000, 0.0000000000000000000 ) ) ; #1225 = DIRECTION ( 'NONE', ( -1.000000000000000000, -6.842277657836020900E-049, 5.606166404184162000E-017 ) ) ; #1226 = CARTESIAN_POINT ( 'NONE', ( 7.930682153449348300, 6.420544520634614100, 0.04311369527748142700 ) ) ; #1227 =( NAMED_UNIT ( * ) PLANE_ANGLE_UNIT ( ) SI_UNIT ( $, .RADIAN. ) ); #1228 = DIRECTION ( 'NONE', ( -1.000000000000000000, -0.0000000000000000000, -5.773722060964641000E-018 ) ) ; #1229 = AXIS2_PLACEMENT_3D ( 'NONE', #1226, #1225, #1203 ) ; #1230 =( GEOMETRIC_REPRESENTATION_CONTEXT ( 3 ) GLOBAL_UNCERTAINTY_ASSIGNED_CONTEXT ( ( #1222 ) ) GLOBAL_UNIT_ASSIGNED_CONTEXT ( ( #1234, #1227, #1204 ) ) REPRESENTATION_CONTEXT ( 'NONE', 'WORKASPACE' ) ); #1231 = DIRECTION ( 'NONE', ( 0.0000000000000000000, 0.0000000000000000000, -1.000000000000000000 ) ) ; #1232 = AXIS2_PLACEMENT_3D ( 'NONE', #1196, #1181, #1224 ) ; #1233 =( LENGTH_UNIT ( ) NAMED_UNIT ( * ) SI_UNIT ( .MILLI., .METRE. ) ); #1234 =( LENGTH_UNIT ( ) NAMED_UNIT ( * ) SI_UNIT ( .MILLI., .METRE. ) ); #1235 = MECHANICAL_DESIGN_GEOMETRIC_PRESENTATION_REPRESENTATION ( '', ( #1208 ), #1230 ) ; #1236 = DIRECTION ( 'NONE', ( -1.000000000000000000, -0.0000000000000000000, -5.773722060964641000E-018 ) ) ; #1237 = CARTESIAN_POINT ( 'NONE', ( -0.4799178465618462700, -2.342455479365390700, -0.7649217471639060400 ) ) ; #1238 = CIRCLE ( 'NONE', #1217, 0.1630795170733867200 ) ; #1239 = DIRECTION ( 'NONE', ( 2.290847664119424400E-034, -1.000000000000000000, -3.967713790048082700E-017 ) ) ; #1240 = SPHERICAL_SURFACE ( 'NONE', #1255, 0.5588000000000014100 ) ; #1241 = FILL_AREA_STYLE_COLOUR ( '', #1246 ) ; #1242 = FACE_OUTER_BOUND ( 'NONE', #5437, .T. ) ; #1243 = DIRECTION ( 'NONE', ( 0.0000000000000000000, 1.000000000000000000, 0.0000000000000000000 ) ) ; #1244 = SURFACE_SIDE_STYLE ('',( #1245 ) ) ; #1245 = SURFACE_STYLE_FILL_AREA ( #1268 ) ; #1246 = COLOUR_RGB ( '',0.7960784313725489700, 0.8235294117647058400, 0.9372549019607843100 ) ; #1247 = MECHANICAL_DESIGN_GEOMETRIC_PRESENTATION_REPRESENTATION ( '', ( #1273 ), #1276 ) ; #1248 = PRESENTATION_LAYER_ASSIGNMENT ( '', '', ( #1273 ) ) ; #1249 = CARTESIAN_POINT ( 'NONE', ( -3.451717846550651700, 6.420544520634610600, 0.04311369527748121200 ) ) ; #1250 = AXIS2_PLACEMENT_3D ( 'NONE', #1249, #1258, #1257 ) ; #1251 =( LENGTH_UNIT ( ) NAMED_UNIT ( * ) SI_UNIT ( .MILLI., .METRE. ) ); #1252 = CYLINDRICAL_SURFACE ( 'NONE', #1250, 0.6857999999999998500 ) ; #1253 =( GEOMETRIC_REPRESENTATION_CONTEXT ( 3 ) GLOBAL_UNCERTAINTY_ASSIGNED_CONTEXT ( ( #898 ) ) GLOBAL_UNIT_ASSIGNED_CONTEXT ( ( #914, #897, #895 ) ) REPRESENTATION_CONTEXT ( 'NONE', 'WORKASPACE' ) ); #1254 = CARTESIAN_POINT ( 'NONE', ( -4.213717846539454500, -2.342455479365390700, -0.7649217471639060400 ) ) ; #1255 = AXIS2_PLACEMENT_3D ( 'NONE', #1254, #1287, #1286 ) ; #1256 = CARTESIAN_POINT ( 'NONE', ( -4.137517846550650800, 6.420544520634610600, 0.04311369527748131600 ) ) ; #1257 = DIRECTION ( 'NONE', ( 0.0000000000000000000, 0.0000000000000000000, 1.000000000000000000 ) ) ; #1258 = DIRECTION ( 'NONE', ( 2.775557561562890900E-016, -1.000000000000000000, -1.621377732827185800E-016 ) ) ; #1259 = CARTESIAN_POINT ( 'NONE', ( -0.1751178465506492700, -4.755455479365391400, -0.4648863047225214000 ) ) ; #1260 = UNCERTAINTY_MEASURE_WITH_UNIT (LENGTH_MEASURE( 1.000000000000000100E-005 ), #1251, 'distance_accuracy_value', 'NONE'); #1261 =( NAMED_UNIT ( * ) SI_UNIT ( $, .STERADIAN. ) SOLID_ANGLE_UNIT ( ) ); #1262 = DIRECTION ( 'NONE', ( 0.0000000000000000000, 1.000000000000000000, -0.0000000000000000000 ) ) ; #1263 = DIRECTION ( 'NONE', ( -5.773722060964636400E-018, -1.621377732827185500E-016, 1.000000000000000000 ) ) ; #1264 = VECTOR ( 'NONE', #1263, 1000.000000000000000 ) ; #1265 = CARTESIAN_POINT ( 'NONE', ( -0.1751178465506497100, -1.580455479365391100, 0.04311369527748001900 ) ) ; #1266 = LINE ( 'NONE', #1265, #1264 ) ; #1267 =( NAMED_UNIT ( * ) PLANE_ANGLE_UNIT ( ) SI_UNIT ( $, .RADIAN. ) ); #1268 = FILL_AREA_STYLE ('',( #1241 ) ) ; #1269 = CARTESIAN_POINT ( 'NONE', ( -0.1751178465618462000, -2.831694030585549400, -0.7649217471639060400 ) ) ; #1270 = CARTESIAN_POINT ( 'NONE', ( -4.018984513206119900, -2.342455479365390700, -0.7649217471639060400 ) ) ; #1271 = DIRECTION ( 'NONE', ( 0.0000000000000000000, 0.0000000000000000000, 1.000000000000000000 ) ) ; #1272 = SPHERICAL_SURFACE ( 'NONE', #1280, 0.2540000000000013900 ) ; #1273 = STYLED_ITEM ( 'NONE', ( #1274 ), #5402 ) ; #1274 = PRESENTATION_STYLE_ASSIGNMENT (( #1275 ) ) ; #1275 = SURFACE_STYLE_USAGE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
 =( NAMED_UNIT ( * ) PLANE_ANGLE_UNIT ( ) SI_UNIT ( $, .RADIAN. ) ); #1327 = CARTESIAN_POINT ( 'NONE', ( -3.832717846539452500, -2.831694030585549400, -0.7649217471639062600 ) ) ; #1328 = CARTESIAN_POINT ( 'NONE', ( -3.785304513206119400, -2.342455479365390700, -0.7649217471639060400 ) ) ; #1329 = LINE ( 'NONE', #1365, #1364 ) ; #1330 = CARTESIAN_POINT ( 'NONE', ( 6.660682153449347900, 6.420544520634614100, -0.3886863047225176900 ) ) ; #1331 = AXIS2_PLACEMENT_3D ( 'NONE', #1330, #1296, #1295 ) ; #1332 = STYLED_ITEM ( 'NONE', ( #1316 ), #5422 ) ; #1333 = FILL_AREA_STYLE ('',( #1334 ) ) ; #1334 = FILL_AREA_STYLE_COLOUR ( '', #1311 ) ; #1335 =( NAMED_UNIT ( * ) PLANE_ANGLE_UNIT ( ) SI_UNIT ( $, .RADIAN. ) ); #1336 = MECHANICAL_DESIGN_GEOMETRIC_PRESENTATION_REPRESENTATION ( '', ( #1332 ), #1351 ) ; #1337 = PRESENTATION_LAYER_ASSIGNMENT ( '', '', ( #1332 ) ) ; #1338 = FILL_AREA_STYLE_COLOUR ( '', #1356 ) ; #1339 = DIRECTION ( 'NONE', ( 0.0000000000000000000, 1.208782508449109200E-015, -1.000000000000000000 ) ) ; #1340 = DIRECTION ( 'NONE', ( -1.000000000000000000, -0.0000000000000000000, -5.773722060964641000E-018 ) ) ; #1341 = CARTESIAN_POINT ( 'NONE', ( -0.5273311798951795200, -2.342455479365390700, -0.7649217471639060400 ) ) ; #1342 = AXIS2_PLACEMENT_3D ( 'NONE', #1341, #1340, #1339 ) ; #1343 = CIRCLE ( 'NONE', #1309, 0.1630795170733867200 ) ; #1344 = PLANE ( 'NONE', #1331 ) ; #1345 =( GEOMETRIC_REPRESENTATION_CONTEXT ( 3 ) GLOBAL_UNCERTAINTY_ASSIGNED_CONTEXT ( ( #1320 ) ) GLOBAL_UNIT_ASSIGNED_CONTEXT ( ( #1350, #1362, #1289 ) ) REPRESENTATION_CONTEXT ( 'NONE', 'WORKASPACE' ) ); #1346 = STYLED_ITEM ( 'NONE', ( #1347 ), #5423 ) ; #1347 = PRESENTATION_STYLE_ASSIGNMENT (( #1348 ) ) ; #1348 = SURFACE_STYLE_USAGE ( .BOTH. , #1368 ) ; #1349 = LINE ( 'NONE', #1321, #1315 ) ; #1350 =( LENGTH_UNIT ( ) NAMED_UNIT ( * ) SI_UNIT ( .MILLI., .METRE. ) ); #1351 =( GEOMETRIC_REPRESENTATION_CONTEXT ( 3 ) GLOBAL_UNCERTAINTY_ASSIGNED_CONTEXT ( ( #1319 ) ) GLOBAL_UNIT_ASSIGNED_CONTEXT ( ( #1305, #1326, #1310 ) ) REPRESENTATION_CONTEXT ( 'NONE', 'WORKASPACE' ) ); #1352 = FILL_AREA_STYLE ('',( #1338 ) ) ; #1353 = SURFACE_STYLE_USAGE ( .BOTH. , #1354 ) ; #1354 = SURFACE_SIDE_STYLE ('',( #1355 ) ) ; #1355 = SURFACE_STYLE_FILL_AREA ( #1352 ) ; #1356 = COLOUR_RGB ( '',0.7960784313725489700, 0.8235294117647058400, 0.9372549019607843100 ) ; #1357 = CARTESIAN_POINT ( 'NONE', ( -4.137517846539452600, -2.831694030585549400, -0.7649217471639062600 ) ) ; #1358 = DIRECTION ( 'NONE', ( 0.0000000000000000000, 0.0000000000000000000, -1.000000000000000000 ) ) ; #1359 = DIRECTION ( 'NONE', ( 9.361384385181154300E-034, -1.000000000000000000, -1.621377732827185500E-016 ) ) ; #1360 = CARTESIAN_POINT ( 'NONE', ( -4.213717846539454500, -2.342455479365390700, -0.7649217471639060400 ) ) ; #1361 = AXIS2_PLACEMENT_3D ( 'NONE', #1360, #1359, #1358 ) ; #1362 =( NAMED_UNIT ( * ) PLANE_ANGLE_UNIT ( ) SI_UNIT ( $, .RADIAN. ) ); #1363 = DIRECTION ( 'NONE', ( -2.775557561562890900E-016, 1.000000000000000000, 5.993114065094845700E-017 ) ) ; #1364 = VECTOR ( 'NONE', #1363, 1000.000000000000000 ) ; #1365 = CARTESIAN_POINT ( 'NONE', ( 7.625882153449350800, -4.755455479365387800, -1.455486304722519300 ) ) ; #1366 = SURFACE_SIDE_STYLE ('',( #1367 ) ) ; #1367 = SURFACE_STYLE_FILL_AREA ( #1333 ) ; #1368 = SURFACE_SIDE_STYLE ('',( #1369 ) ) ; #1369 = SURFACE_STYLE_FILL_AREA ( #1370 ) ; #1370 = FILL_AREA_STYLE ('',( #1301 ) ) ; #1371 = FACE_OUTER_BOUND ( 'NONE', #5545, .T. ) ; #1372 = DIRECTION ( 'NONE', ( -1.000000000000000000, -1.705445482763587300E-031, 2.901736657442119600E-015 ) ) ; #1373 =( GEOMETRIC_REPRESENTATION_CONTEXT ( 3 ) GLOBAL_UNCERTAINTY_ASSIGNED_CONTEXT ( ( #1290 ) ) GLOBAL_UNIT_ASSIGNED_CONTEXT ( ( #1325, #1335, #1312 ) ) REPRESENTATION_CONTEXT ( 'NONE', 'WORKASPACE' ) ); #1374 = DIRECTION ( 'NONE', ( -1.000000000000000000, -0.0000000000000000000, -5.773722060964641000E-018 ) ) ; #1375 = CARTESIAN_POINT ( 'NONE', ( -0.2936511798951790800, -2.342455479365390700, -0.7649217471639060400 ) ) ; #1376 = AXIS2_PLACEMENT_3D ( 'NONE', #1375, #1374, #1390 ) ; #1377 = CIRCLE ( 'NONE', #1376, 0.1630795170733867200 ) ; #1378 = MECHANICAL_DESIGN_GEOMETRIC_PRESENTATION_REPRESENTATION ( '', ( #1380 ), #1373 ) ; #1379 = PRESENTATION_LAYER_ASSIGNMENT ( '', '', ( #1380 ) ) ; #1380 = STYLED_ITEM ( 'NONE', ( #1381 ), #5427 ) ; #1381 = PRESENTATION_STYLE_ASSIGNMENT (( #1353 ) ) ; #1382 = CIRCLE ( 'NONE', #1342, 0.3587749375614497900 ) ; #1383 = FACE_OUTER_BOUND ( 'NONE', #5426, .T. ) ; 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
( ) SI_UNIT ( $, .RADIAN. ) ); #1433 = DIRECTION ( 'NONE', ( 0.0000000000000000000, 1.000000000000000000, 1.087204431837239300E-016 ) ) ; #1434 = DIRECTION ( 'NONE', ( -1.000000000000000000, 0.0000000000000000000, -5.773722060964641000E-018 ) ) ; #1435 = CARTESIAN_POINT ( 'NONE', ( -3.629517846539452200, -2.342455479365390700, -0.7649217471639060400 ) ) ; #1436 = AXIS2_PLACEMENT_3D ( 'NONE', #1435, #1434, #1433 ) ; #1437 = FACE_OUTER_BOUND ( 'NONE', #5412, .T. ) ; #1438 = FILL_AREA_STYLE_COLOUR ( '', #1470 ) ; #1439 = CARTESIAN_POINT ( 'NONE', ( -0.6831178465618463800, -1.853216928145231800, -0.7649217471639059300 ) ) ; #1440 = CARTESIAN_POINT ( 'NONE', ( -4.018984513206119900, -2.342455479365390700, -0.7649217471639060400 ) ) ; #1441 = DIRECTION ( 'NONE', ( -5.773722060964641000E-018, -3.967713790048084500E-017, 1.000000000000000000 ) ) ; #1442 = MECHANICAL_DESIGN_GEOMETRIC_PRESENTATION_REPRESENTATION ( '', ( #1444 ), #1423 ) ; #1443 = PRESENTATION_LAYER_ASSIGNMENT ( '', '', ( #1444 ) ) ; #1444 = STYLED_ITEM ( 'NONE', ( #1477 ), #5483 ) ; #1445 = TOROIDAL_SURFACE ( 'NONE', #1436, 0.4892385512201587500, 0.5080000000000000100 ) ; #1446 =( NAMED_UNIT ( * ) PLANE_ANGLE_UNIT ( ) SI_UNIT ( $, .RADIAN. ) ); #1447 = AXIS2_PLACEMENT_3D ( 'NONE', #1489, #1471, #1424 ) ; #1448 = CIRCLE ( 'NONE', #1447, 0.5588000000000014100 ) ; #1449 = CIRCLE ( 'NONE', #1427, 0.5588000000000014100 ) ; #1450 = AXIS2_PLACEMENT_3D ( 'NONE', #1439, #1482, #1481 ) ; #1451 =( NAMED_UNIT ( * ) SI_UNIT ( $, .STERADIAN. ) SOLID_ANGLE_UNIT ( ) ); #1452 = CARTESIAN_POINT ( 'NONE', ( -0.1751178465618464200, -1.853216928145231800, -0.7649217471639059300 ) ) ; #1453 = DIRECTION ( 'NONE', ( 0.0000000000000000000, 1.000000000000000000, 0.0000000000000000000 ) ) ; #1454 = UNCERTAINTY_MEASURE_WITH_UNIT (LENGTH_MEASURE( 1.000000000000000100E-005 ), #1463, 'distance_accuracy_value', 'NONE'); #1455 =( LENGTH_UNIT ( ) NAMED_UNIT ( * ) SI_UNIT ( .MILLI., .METRE. ) ); #1456 = MECHANICAL_DESIGN_GEOMETRIC_PRESENTATION_REPRESENTATION ( '', ( #1464 ), #1486 ) ; #1457 = PRESENTATION_LAYER_ASSIGNMENT ( '', '', ( #1464 ) ) ; #1458 = CIRCLE ( 'NONE', #1485, 0.1630795170733867200 ) ; #1459 = CARTESIAN_POINT ( 'NONE', ( -0.6831178465618461500, -2.831694030585549400, -0.7649217471639060400 ) ) ; #1460 = CIRCLE ( 'NONE', #1475, 0.5080000000000002300 ) ; #1461 = CARTESIAN_POINT ( 'NONE', ( -4.018984513206119900, -2.179375962292003700, -0.7649217471639060400 ) ) ; #1462 = CARTESIAN_POINT ( 'NONE', ( -0.2936511798951790800, -2.505534996438777200, -0.7649217471639060400 ) ) ; #1463 =( LENGTH_UNIT ( ) NAMED_UNIT ( * ) SI_UNIT ( .MILLI., .METRE. ) ); #1464 = STYLED_ITEM ( 'NONE', ( #1465 ), #5486 ) ; #1465 = PRESENTATION_STYLE_ASSIGNMENT (( #1466 ) ) ; #1466 = SURFACE_STYLE_USAGE ( .BOTH. , #1467 ) ; #1467 = SURFACE_SIDE_STYLE ('',( #1468 ) ) ; #1468 = SURFACE_STYLE_FILL_AREA ( #1469 ) ; #1469 = FILL_AREA_STYLE ('',( #1438 ) ) ; #1470 = COLOUR_RGB ( '',0.7960784313725489700, 0.8235294117647058400, 0.9372549019607843100 ) ; #1471 = DIRECTION ( 'NONE', ( -1.643192110624288600E-033, 1.000000000000000000, 2.845984086649562800E-016 ) ) ; #1472 = DIRECTION ( 'NONE', ( 0.0000000000000000000, 1.000000000000000000, 0.0000000000000000000 ) ) ; #1473 = DIRECTION ( 'NONE', ( -1.000000000000000000, 0.0000000000000000000, -5.773722060964641000E-018 ) ) ; #1474 = DIRECTION ( 'NONE', ( 0.0000000000000000000, -1.000000000000000000, 0.0000000000000000000 ) ) ; #1475 = AXIS2_PLACEMENT_3D ( 'NONE', #1459, #1441, #1474 ) ; #1476 = DIRECTION ( 'NONE', ( -1.000000000000000000, 0.0000000000000000000, -5.773722060964641000E-018 ) ) ; #1477 = PRESENTATION_STYLE_ASSIGNMENT (( #1478 ) ) ; #1478 = SURFACE_STYLE_USAGE ( .BOTH. , #1479 ) ; #1479 = SURFACE_SIDE_STYLE ('',( #1480 ) ) ; #1480 = SURFACE_STYLE_FILL_AREA ( #1420 ) ; #1481 = DIRECTION ( 'NONE', ( 0.0000000000000000000, 1.000000000000000000, 2.134256245050205500E-016 ) ) ; #1482 = DIRECTION ( 'NONE', ( 5.773722060964641000E-018, 1.621377732827185800E-016, -1.000000000000000000 ) ) ; #1483 = UNCERTAINTY_MEASURE_WITH_UNIT (LENGTH_MEASURE( 1.000000000000000100E-005 ), #1455, 'distance_accuracy_value', 'NONE'); #1484 =( NAMED_UNIT ( * ) SI_UNIT ( $, .STERADIAN. ) SOLID_ANGLE_UNIT ( ) ); #1485 = AXIS2_PLACEMENT_3D ( 'NONE', #1429, #1476, #1453 ) ; #1486 =( GEOMETRIC_REPRESENTATION_CONTEXT ( 3 ) GLOBAL_UNCERTAINTY_ASSIGNED_CONTEXT ( ( #1483 ) ) GLOBAL_UNIT_ASSIGNED_CONTEXT ( ( #1455, #1432, #1484 ) ) REPRESENTATION_CONTEXT ( 'NONE', 'WORKASPACE' ) ); #1487 = AXI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
88983919700E-034, 1.000000000000000000, 1.565773844588825100E-016 ) ) ; #1579 = LINE ( 'NONE', #1595, #1594 ) ; #1580 = CARTESIAN_POINT ( 'NONE', ( -0.5273311798951795200, -2.342455479365390700, -1.123696684725355800 ) ) ; #1581 = PRESENTATION_LAYER_ASSIGNMENT ( '', '', ( #1582 ) ) ; #1582 = STYLED_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
.STERADIAN. ) SOLID_ANGLE_UNIT ( ) ); #2619 = UNCERTAINTY_MEASURE_WITH_UNIT (LENGTH_MEASURE( 1.000000000000000100E-005 ), #2555, 'distance_accuracy_value', 'NONE'); #2620 = PLANE ( 'NONE', #2603 ) ; #2621 = DIRECTION ( 'NONE', ( -1.000000000000000000, 0.0000000000000000000, 2.363190305937945300E-016 ) ) ; #2622 = DIRECTION ( 'NONE', ( -2.363190305937945300E-016, 0.0000000000000000000, -1.000000000000000000 ) ) ; #2623 = CARTESIAN_POINT ( 'NONE', ( -5.444017846550651500, 0.8921445206346105800, 1.846513695277483200 ) ) ; #2624 = AXIS2_PLACEMENT_3D ( 'NONE', #2623, #2622, #2621 ) ; #2625 = CARTESIAN_POINT ( 'NONE', ( -0.5545178465506520600, -1.012855479365389200, -1.125286304722517200 ) ) ; #2626 = MECHANICAL_DESIGN_GEOMETRIC_PRESENTATION_REPRESENTATION ( '', ( #2628 ), #2614 ) ; #2627 = PRESENTATION_LAYER_ASSIGNMENT ( '', '', ( #2628 ) ) ; #2628 = STYLED_ITEM ( 'NONE', ( #2632 ), #4747 ) ; #2629 = CARTESIAN_POINT ( 'NONE', ( -1.749917846550651300, 1.442144520634609500, -0.3886863047225183600 ) ) ; #2630 = CARTESIAN_POINT ( 'NONE', ( -0.1751178465506505700, 1.442144520634609500, -0.3886863047225189700 ) ) ; #2631 = DIRECTION ( 'NONE', ( 0.0000000000000000000, 2.753879025871232400E-016, -1.000000000000000000 ) ) ; #2632 = PRESENTATION_STYLE_ASSIGNMENT (( #2633 ) ) ; #2633 = SURFACE_STYLE_USAGE ( .BOTH. , #2634 ) ; #2634 = SURFACE_SIDE_STYLE ('',( #2635 ) ) ; #2635 = SURFACE_STYLE_FILL_AREA ( #2597 ) ; #2636 =( NAMED_UNIT ( * ) PLANE_ANGLE_UNIT ( ) SI_UNIT ( $, .RADIAN. ) ); #2637 =( LENGTH_UNIT ( ) NAMED_UNIT ( * ) SI_UNIT ( .MILLI., .METRE. ) ); #2638 = UNCERTAINTY_MEASURE_WITH_UNIT (LENGTH_MEASURE( 1.000000000000000100E-005 ), #2637, 'distance_accuracy_value', 'NONE'); #2639 = DIRECTION ( 'NONE', ( -0.0000000000000000000, -1.000000000000000000, -0.0000000000000000000 ) ) ; #2640 = VECTOR ( 'NONE', #2639, 1000.000000000000000 ) ; #2641 = CARTESIAN_POINT ( 'NONE', ( 9.237182153449342800, 0.8921445206346105800, -2.903286304722517000 ) ) ; #2642 =( LENGTH_UNIT ( ) NAMED_UNIT ( * ) SI_UNIT ( .MILLI., .METRE. ) ); #2643 = MECHANICAL_DESIGN_GEOMETRIC_PRESENTATION_REPRESENTATION ( '', ( #2656 ), #2654 ) ; #2644 = SURFACE_STYLE_FILL_AREA ( #2667 ) ; #2645 =( NAMED_UNIT ( * ) PLANE_ANGLE_UNIT ( ) SI_UNIT ( $, .RADIAN. ) ); #2646 = LINE ( 'NONE', #2666, #2665 ) ; #2647 = DIRECTION ( 'NONE', ( 0.0000000000000000000, 0.0000000000000000000, 1.000000000000000000 ) ) ; #2648 = DIRECTION ( 'NONE', ( 2.775557561562890900E-016, -1.000000000000000000, -1.621377732827185800E-016 ) ) ; #2649 = AXIS2_PLACEMENT_3D ( 'NONE', #2652, #2648, #2647 ) ; #2650 = UNCERTAINTY_MEASURE_WITH_UNIT (LENGTH_MEASURE( 1.000000000000000100E-005 ), #2642, 'distance_accuracy_value', 'NONE'); #2651 =( NAMED_UNIT ( * ) SI_UNIT ( $, .STERADIAN. ) SOLID_ANGLE_UNIT ( ) ); #2652 = CARTESIAN_POINT ( 'NONE', ( -0.9625178465506524200, 6.420544520634610600, -0.3886863047225181400 ) ) ; #2653 = CYLINDRICAL_SURFACE ( 'NONE', #2649, 0.7874000000000002100 ) ; #2654 =( GEOMETRIC_REPRESENTATION_CONTEXT ( 3 ) GLOBAL_UNCERTAINTY_ASSIGNED_CONTEXT ( ( #2650 ) ) GLOBAL_UNIT_ASSIGNED_CONTEXT ( ( #2642, #2645, #2651 ) ) REPRESENTATION_CONTEXT ( 'NONE', 'WORKASPACE' ) ); #2655 = PRESENTATION_LAYER_ASSIGNMENT ( '', '', ( #2656 ) ) ; #2656 = STYLED_ITEM ( 'NONE', ( #2657 ), #4767 ) ; #2657 = PRESENTATION_STYLE_ASSIGNMENT (( #2660 ) ) ; #2658 = SURFACE_SIDE_STYLE ('',( #2644 ) ) ; #2659 = FACE_OUTER_BOUND ( 'NONE', #4627, .T. ) ; #2660 = SURFACE_STYLE_USAGE ( .BOTH. , #2658 ) ; #2661 = COLOUR_RGB ( '',0.7960784313725489700, 0.8235294117647058400, 0.9372549019607843100 ) ; #2662 = FILL_AREA_STYLE_COLOUR ( '', #2661 ) ; #2663 = CARTESIAN_POINT ( 'NONE', ( -3.780317846550652400, -2.282855479365389200, 0.7289136952774799600 ) ) ; #2664 = DIRECTION ( 'NONE', ( 0.0000000000000000000, 0.0000000000000000000, 1.000000000000000000 ) ) ; #2665 = VECTOR ( 'NONE', #2664, 1000.000000000000000 ) ; #2666 = CARTESIAN_POINT ( 'NONE', ( -3.780317846550652400, -2.282855479365389200, 0.7289136952774799600 ) ) ; #2667 = FILL_AREA_STYLE ('',( #2662 ) ) ; #2668 = CARTESIAN_POINT ( 'NONE', ( -1.749917846550652600, 6.420544520634610600, -0.3886863047225174700 ) ) ; #2669 = DIRECTION ( 'NONE', ( 0.0000000000000000000, -1.000000000000000000, 0.0000000000000000000 ) ) ; #2670 = VECTOR ( 'NONE', #2669, 1000.000000000000000 ) ; #2671 = CARTESIAN_POINT ( 'NONE', ( -3.780317846550652400, -0.2127554793653891900, 0.7289136952774799600 ) ) ; #2672 = LINE ( 'NONE', #2671, #2670 ) ; #2673 = CARTESIAN_POINT ( 'NONE', ( -4.237517846550652200, 0.8921445206346105800, -1.125286304722517200 ) ) ; #2674 = PRESENTATION_LAYER_ASSIGNMENT ( '', '', ( #2735 ) ) ; #2675 = SURFACE_SIDE_STYLE ('',( #2719 ) ) ; #2676 = DIRECTION ( 'NONE', ( 1.000000000000000000, 0.0000000000000000000, 5.773722060964641000E-018 ) ) ; #2677 = VECTOR ( 'NONE', #2676, 1000.000000000000000 ) ; #2678 = CARTESIAN_POINT ( 'NONE', ( -4.188317846550649600, -0.1326554793653906500, -0.08388630472251959500 ) ) ; #2679 = LINE ( 'NONE', #2678, #2677 ) ; #2680 = CARTESIAN_POINT ( 'NONE', ( -3.780317846550652400, -1.647855479365389500, 0.7289136952774795100 ) ) ; #2681 =( NAMED_UNIT ( * ) PLANE_ANGLE_UNIT ( ) SI_UNIT ( $, .RADIAN. ) ); #2682 =( GEOMETRIC_REPRESENTATION_CONTEXT ( 3 ) GLOBAL_UNCERTAINTY_ASSIGNED_CONTEXT ( ( #2720 ) ) GLOBAL_UNIT_ASSIGNED_CONTEXT ( ( #2704, #2696, #2694 ) ) REPRESENTATION_CONTEXT ( 'NONE', 'WORKASPACE' ) ); #2683 = SURFACE_STYLE_USAGE ( .BOTH. , #2675 ) ; #2684 = FILL_AREA_STYLE_COLOUR ( '', #2718 ) ; #2685 = FILL_AREA_STYLE ('',( #2684 ) ) ; #2686 = AXIS2_PLACEMENT_3D ( 'NONE', #2673, #2724, #2723 ) ; #2687 = AXIS2_PLACEMENT_3D ( 'NONE', #2689, #2688, #2722 ) ; #2688 = DIRECTION ( 'NONE', ( -2.775557561562890900E-016, 1.000000000000000000, 1.621377732827185500E-016 ) ) ; #2689 = CARTESIAN_POINT ( 'NONE', ( -4.188317846550649600, -0.1326554793653906500, -0.08388630472251959500 ) ) ; #2690 = DIRECTION ( 'NONE', ( 0.0000000000000000000, -0.0000000000000000000, -1.000000000000000000 ) ) ; #2691 = VECTOR ( 'NONE', #2690, 1000.000000000000000 ) ; #2692 = CARTESIAN_POINT ( 'NONE', ( -4.237517846550652200, -2.282855479365389200, -1.785686304722517100 ) ) ; #2693 = LINE ( 'NONE', #2692, #2691 ) ; #2694 =( NAMED_UNIT ( * ) SI_UNIT ( $, .STERADIAN. ) SOLID_ANGLE_UNIT ( ) ); #2695 = CARTESIAN_POINT ( 'NONE', ( -1.445117846550652700, 6.420544520634610600, -0.3886863047225176900 ) ) ; #2696 =( NAMED_UNIT ( * ) PLANE_ANGLE_UNIT ( ) SI_UNIT ( $, .RADIAN. ) ); #2697 =( LENGTH_UNIT ( ) NAMED_UNIT ( * ) SI_UNIT ( .MILLI., .METRE. ) ); #2698 = MECHANICAL_DESIGN_GEOMETRIC_PRESENTATION_REPRESENTATION ( '', ( #2701 ), #2712 ) ; #2699 = PRESENTATION_STYLE_ASSIGNMENT (( #2683 ) ) ; #2700 = PRESENTATION_LAYER_ASSIGNMENT ( '', '', ( #2701 ) ) ; #2701 = STYLED_ITEM ( 'NONE', ( #2702 ), #4782 ) ; #2702 = PRESENTATION_STYLE_ASSIGNMENT (( #2703 ) ) ; #2703 = SURFACE_STYLE_USAGE ( .BOTH. , #2736 ) ; #2704 =( LENGTH_UNIT ( ) NAMED_UNIT ( * ) SI_UNIT ( .MILLI., .METRE. ) ); #2705 = PLANE ( 'NONE', #2686 ) ; #2706 = DIRECTION ( 'NONE', ( 0.0000000000000000000, 1.000000000000000000, 0.0000000000000000000 ) ) ; #2707 = VECTOR ( 'NONE', #2706, 1000.000000000000000 ) ; #2708 = CARTESIAN_POINT ( 'NONE', ( -0.5545178465506520600, -1.647855479365389500, 0.06851369527747966400 ) ) ; #2709 = LINE ( 'NONE', #2708, #2707 ) ; #2710 = PLANE ( 'NONE', #2687 ) ; #2711 = UNCERTAINTY_MEASURE_WITH_UNIT (LENGTH_MEASURE( 1.000000000000000100E-005 ), #2697, 'distance_accuracy_value', 'NONE'); #2712 =( GEOMETRIC_REPRESENTATION_CONTEXT ( 3 ) GLOBAL_UNCERTAINTY_ASSIGNED_CONTEXT ( ( #2711 ) ) GLOBAL_UNIT_ASSIGNED_CONTEXT ( ( #2697, #2681, #2734 ) ) REPRESENTATION_CONTEXT ( 'NONE', 'WORKASPACE' ) ); #2713 = CARTESIAN_POINT ( 'NONE', ( -0.5545178465506520600, -1.647855479365389500, 0.06851369527747966400 ) ) ; #2714 = CARTESIAN_POINT ( 'NONE', ( -0.5545178465506520600, -1.012855479365389400, 0.06851369527747966400 ) ) ; #2715 = DIRECTION ( 'NONE', ( 0.0000000000000000000, 0.0000000000000000000, -1.000000000000000000 ) ) ; #2716 = VECTOR ( 'NONE', #2715, 1000.000000000000000 ) ; #2717 = CARTESIAN_POINT ( 'NONE', ( -0.5545178465506520600, -1.012855479365389200, -1.125286304722517200 ) ) ; #2718 = COLOUR_RGB ( '',0.2000000000000000100, 0.2000000000000000100, 0.2000000000000000100 ) ; #2719 = SURFACE_STYLE_FILL_AREA ( #2685 ) ; #2720 = UNCERTAINTY_MEASURE_WITH_UNIT (LENGTH_MEASURE( 1.000000000000000100E-005 ), #2704, 'distance_accuracy_value', 'NONE'); #2721 = LINE ( 'NONE', #2717, #2716 ) ; #2722 = DIRECTION ( 'NONE', ( 5.773722060964636400E-018, 1.621377732827185500E-016, -1.000000000000000000 ) ) ; #2723 = DIRECTION ( 'NONE', ( 0.0000000000000000000, 0.0000000000000000000, -1.000000000000000000 ) ) ; #2724 = DIRECTION ( 'NONE', ( -1.000000000000000000, 0.0000000000000000000, 0.0000000000000000000 ) ) ; #2725 = FACE_OUTER_BOUND ( 'NONE', #4783, .T. ) ; #2726 = DIRECTION ( 'NONE', ( 2.775557561562890900E-016, -1.000000000000000000, -2.444382198915688000E-017 ) ) ; #2727 = VECTOR ( 'NONE', #2726, 1000.000000000000000 ) ; #2728 = FACE_OUTER_BOUND ( 'NONE', #4712, .T. ) ; #2729 = CARTESIAN_POINT ( 'NONE', ( -0.4799178465506518900, 6.420544520634610600, -0.08388630472251949700 ) ) ; #2730 = LINE ( 'NONE', #2729, #2727 ) ; #2731 = FILL_AREA_STYLE_COLOUR ( '', #2739 ) ; #2732 = CARTESIAN_POINT ( 'NONE', ( -0.4799178465506501700, -0.1326554793653906500, -0.08388630472251959500 ) ) ; #2733 = MECHANICAL_DESIGN_GEOMETRIC_PRESENTATION_REPRESENTATION ( '', ( #2735 ), #2682 ) ; #2734 =( NAMED_UNIT ( * ) SI_UNIT ( $, .STERADIAN. ) SOLID_ANGLE_UNIT ( ) ); #2735 = STYLED_ITEM ( 'NONE', ( #2699 ), #4775 ) ; #2736 = SURFACE_SIDE_STYLE ('',( #2737 ) ) ; #2737 = SURFACE_STYLE_FILL_AREA ( #2738 ) ; #2738 = FILL_AREA_STYLE ('',( #2731 ) ) ; #2739 = COLOUR_RGB ( '',0.7960784313725489700, 0.8235294117647058400, 0.9372549019607843100 ) ; #2740 = CARTESIAN_POINT ( 'NONE', ( -0.5545178465506520600, -2.282855479365389200, -1.785686304722517100 ) ) ; #2741 = DIRECTION ( 'NONE', ( 0.0000000000000000000, -1.000000000000000000, 0.0000000000000000000 ) ) ; #2742 = VECTOR ( 'NONE', #2741, 1000.000000000000000 ) ; #2743 = CARTESIAN_POINT ( 'NONE', ( -0.5545178465506520600, -0.2127554793653891900, -1.785686304722517100 ) ) ; #2744 = LINE ( 'NONE', #2743, #2742 ) ; #2745 = LINE ( 'NONE', #2751, #2761 ) ; #2746 = VECTOR ( 'NONE', #2752, 1000.000000000000000 ) ; #2747 = CARTESIAN_POINT ( 'NONE', ( 8.030682153449348000, -2.282855479365389200, 0.7289136952774795100 ) ) ; #2748 = DIRECTION ( 'NONE', ( 0.0000000000000000000, -1.000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
 #2799 = LINE ( 'NONE', #2798, #2797 ) ; #2800 = CARTESIAN_POINT ( 'NONE', ( 3.890482153449347400, -2.282855479365389200, -1.785686304722517100 ) ) ; #2801 = LINE ( 'NONE', #2791, #2790 ) ; #2802 = DIRECTION ( 'NONE', ( 0.0000000000000000000, -1.000000000000000000, 0.0000000000000000000 ) ) ; #2803 = DIRECTION ( 'NONE', ( 0.0000000000000000000, 0.0000000000000000000, 1.000000000000000000 ) ) ; #2804 = VECTOR ( 'NONE', #2803, 1000.000000000000000 ) ; #2805 = LINE ( 'NONE', #2788, #2787 ) ; #2806 = DIRECTION ( 'NONE', ( -0.0000000000000000000, -0.0000000000000000000, 1.000000000000000000 ) ) ; #2807 = VECTOR ( 'NONE', #2806, 1000.000000000000000 ) ; #2808 = CARTESIAN_POINT ( 'NONE', ( 3.890482153449347400, 0.8921445206346105800, -0.2616863047225170800 ) ) ; #2809 = LINE ( 'NONE', #2808, #2807 ) ; #2810 =( NAMED_UNIT ( * ) PLANE_ANGLE_UNIT ( ) SI_UNIT ( $, .RADIAN. ) ); #2811 =( LENGTH_UNIT ( ) NAMED_UNIT ( * ) SI_UNIT ( .MILLI., .METRE. ) ); #2812 = MECHANICAL_DESIGN_GEOMETRIC_PRESENTATION_REPRESENTATION ( '', ( #2814 ), #2794 ) ; #2813 = PRESENTATION_LAYER_ASSIGNMENT ( '', '', ( #2814 ) ) ; #2814 = STYLED_ITEM ( 'NONE', ( #2777 ), #5097 ) ; #2815 =( NAMED_UNIT ( * ) SI_UNIT ( $, .STERADIAN. ) SOLID_ANGLE_UNIT ( ) ); #2816 = SURFACE_STYLE_USAGE ( .BOTH. , #2842 ) ; #2817 = SURFACE_STYLE_FILL_AREA ( #2818 ) ; #2818 = FILL_AREA_STYLE ('',( #2819 ) ) ; #2819 = FILL_AREA_STYLE_COLOUR ( '', #2820 ) ; #2820 = COLOUR_RGB ( '',0.7960784313725489700, 0.8235294117647058400, 0.9372549019607843100 ) ; #2821 = FACE_OUTER_BOUND ( 'NONE', #5200, .T. ) ; #2822 = PRESENTATION_LAYER_ASSIGNMENT ( '', '', ( #2844 ) ) ; #2823 =( GEOMETRIC_REPRESENTATION_CONTEXT ( 3 ) GLOBAL_UNCERTAINTY_ASSIGNED_CONTEXT ( ( #2833 ) ) GLOBAL_UNIT_ASSIGNED_CONTEXT ( ( #2900, #2884, #2834 ) ) REPRESENTATION_CONTEXT ( 'NONE', 'WORKASPACE' ) ); #2824 =( LENGTH_UNIT ( ) NAMED_UNIT ( * ) SI_UNIT ( .MILLI., .METRE. ) ); #2825 = CARTESIAN_POINT ( 'NONE', ( 4.320495486793881000, -2.701230416926837300, -0.7649217471639050400 ) ) ; #2826 = DIRECTION ( 'NONE', ( 5.606166404184160800E-017, -5.993114065094844400E-017, 1.000000000000000000 ) ) ; #2827 = CARTESIAN_POINT ( 'NONE', ( 4.476282153460547700, -1.853216928145228600, -0.7649217471639049300 ) ) ; #2828 = AXIS2_PLACEMENT_3D ( 'NONE', #2827, #2826, #2883 ) ; #2829 = CIRCLE ( 'NONE', #2828, 0.2032000000000001600 ) ; #2830 = FILL_AREA_STYLE ('',( #2851 ) ) ; #2831 = AXIS2_PLACEMENT_3D ( 'NONE', #2865, #2864, #2863 ) ; #2832 = SPHERICAL_SURFACE ( 'NONE', #2831, 0.5588000000000014100 ) ; #2833 = UNCERTAINTY_MEASURE_WITH_UNIT (LENGTH_MEASURE( 1.000000000000000100E-005 ), #2900, 'distance_accuracy_value', 'NONE'); #2834 =( NAMED_UNIT ( * ) SI_UNIT ( $, .STERADIAN. ) SOLID_ANGLE_UNIT ( ) ); #2835 = FACE_OUTER_BOUND ( 'NONE', #5107, .T. ) ; #2836 = CARTESIAN_POINT ( 'NONE', ( -0.09731784655065203700, -2.282855479365389200, -1.785686304722516700 ) ) ; #2837 = DIRECTION ( 'NONE', ( 1.000000000000000000, 0.0000000000000000000, 0.0000000000000000000 ) ) ; #2838 = VECTOR ( 'NONE', #2837, 1000.000000000000000 ) ; #2839 = CARTESIAN_POINT ( 'NONE', ( -0.5545178465506520600, -2.282855479365389200, -1.785686304722517100 ) ) ; #2840 = DIRECTION ( 'NONE', ( 0.0000000000000000000, 0.0000000000000000000, 1.000000000000000000 ) ) ; #2841 = SURFACE_STYLE_FILL_AREA ( #2830 ) ; #2842 = SURFACE_SIDE_STYLE ('',( #2841 ) ) ; #2843 = COLOUR_RGB ( '',0.2000000000000000100, 0.2000000000000000100, 0.2000000000000000100 ) ; #2844 = STYLED_ITEM ( 'NONE', ( #2858 ), #5104 ) ; #2845 = CARTESIAN_POINT ( 'NONE', ( 4.273082153460547900, -1.853216928145228600, -0.7649217471639049300 ) ) ; #2846 = DIRECTION ( 'NONE', ( 0.0000000000000000000, 0.0000000000000000000, 1.000000000000000000 ) ) ; #2847 = DIRECTION ( 'NONE', ( -1.000000000000000000, 0.0000000000000000000, 5.606166404184160800E-017 ) ) ; #2848 = CARTESIAN_POINT ( 'NONE', ( 4.273082153460547900, -2.342455479365387600, -0.7649217471639049300 ) ) ; #2849 = AXIS2_PLACEMENT_3D ( 'NONE', #2848, #2847, #2846 ) ; #2850 = CIRCLE ( 'NONE', #2849, 0.4892385512201588600 ) ; #2851 = FILL_AREA_STYLE_COLOUR ( '', #2843 ) ; #2852 = CARTESIAN_POINT ( 'NONE', ( 4.320495486793881000, -2.342455479365387600, -1.123696684725354900 ) ) ; #2853 = PLANE ( 'NONE', #2887 ) ; #2854 =( GEOMETRIC_REPRESENTATION_CONTEXT ( 3 ) GLOBAL_UNCERTAINTY_ASSIGNED_CONTEXT ( ( #2901 ) ) GLOBAL_UNIT_ASSIGNED_CONTEXT ( ( #2824, #2899, #2815 ) ) REPRESENTATION_CONTEXT ( 'NONE', 'WORKASPACE' ) ); #2855 = CIRCLE ( 'NONE', #2862, 0.3587749375614500100 ) ; #2856 = CARTESIAN_POINT ( 'NONE', ( -1.445117846550652700, 6.420544520634610600, -0.3886863047225176900 ) ) ; #2857 = LINE ( 'NONE', #2856, #2889 ) ; #2858 = PRESENTATION_STYLE_ASSIGNMENT (( #2816 ) ) ; #2859 = DIRECTION ( 'NONE', ( 0.0000000000000000000, 0.0000000000000000000, 1.000000000000000000 ) ) ; #2860 = DIRECTION ( 'NONE', ( -1.000000000000000000, 0.0000000000000000000, 5.606166404184160800E-017 ) ) ; #2861 = CARTESIAN_POINT ( 'NONE', ( 4.320495486793881000, -2.342455479365387600, -0.7649217471639049300 ) ) ; #2862 = AXIS2_PLACEMENT_3D ( 'NONE', #2861, #2860, #2859 ) ; #2863 = DIRECTION ( 'NONE', ( 0.0000000000000000000, 0.0000000000000000000, 1.000000000000000000 ) ) ; #2864 = DIRECTION ( 'NONE', ( 0.0000000000000000000, 1.000000000000000000, -0.0000000000000000000 ) ) ; #2865 = CARTESIAN_POINT ( 'NONE', ( 3.892082153460546300, -2.342455479365387600, -0.7649217471639047100 ) ) ; #2866 = STYLED_ITEM ( 'NONE', ( #2867 ), #5114 ) ; #2867 = PRESENTATION_STYLE_ASSIGNMENT (( #2868 ) ) ; #2868 = SURFACE_STYLE_USAGE ( .BOTH. , #2869 ) ; #2869 = SURFACE_SIDE_STYLE ('',( #2817 ) ) ; #2870 =( NAMED_UNIT ( * ) SI_UNIT ( $, .STERADIAN. ) SOLID_ANGLE_UNIT ( ) ); #2871 = DIRECTION ( 'NONE', ( 0.0000000000000000000, 0.0000000000000000000, -1.000000000000000000 ) ) ; #2872 = DIRECTION ( 'NONE', ( 1.000000000000000000, -0.0000000000000000000, 0.0000000000000000000 ) ) ; #2873 = CARTESIAN_POINT ( 'NONE', ( 8.030682153449348000, 0.8921445206346105800, -1.125286304722517200 ) ) ; #2874 = AXIS2_PLACEMENT_3D ( 'NONE', #2873, #2872, #2871 ) ; #2875 = PLANE ( 'NONE', #2874 ) ; #2876 =( GEOMETRIC_REPRESENTATION_CONTEXT ( 3 ) GLOBAL_UNCERTAINTY_ASSIGNED_CONTEXT ( ( #2877 ) ) GLOBAL_UNIT_ASSIGNED_CONTEXT ( ( #2890, #2879, #2878 ) ) REPRESENTATION_CONTEXT ( 'NONE', 'WORKASPACE' ) ); #2877 = UNCERTAINTY_MEASURE_WITH_UNIT (LENGTH_MEASURE( 1.000000000000000100E-005 ), #2890, 'distance_accuracy_value', 'NONE'); #2878 =( NAMED_UNIT ( * ) SI_UNIT ( $, .STERADIAN. ) SOLID_ANGLE_UNIT ( ) ); #2879 =( NAMED_UNIT ( * ) PLANE_ANGLE_UNIT ( ) SI_UNIT ( $, .RADIAN. ) ); #2880 = MECHANICAL_DESIGN_GEOMETRIC_PRESENTATION_REPRESENTATION ( '', ( #2866 ), #2823 ) ; #2881 = PRESENTATION_LAYER_ASSIGNMENT ( '', '', ( #2866 ) ) ; #2882 = MECHANICAL_DESIGN_GEOMETRIC_PRESENTATION_REPRESENTATION ( '', ( #2844 ), #2854 ) ; #2883 = DIRECTION ( 'NONE', ( 0.0000000000000000000, -1.000000000000000000, 0.0000000000000000000 ) ) ; #2884 =( NAMED_UNIT ( * ) PLANE_ANGLE_UNIT ( ) SI_UNIT ( $, .RADIAN. ) ); #2885 = DIRECTION ( 'NONE', ( 1.000000000000000000, 0.0000000000000000000, -7.304406400171826500E-016 ) ) ; #2886 = CARTESIAN_POINT ( 'NONE', ( -5.444017846550651500, 0.8921445206346105800, 1.846513695277483200 ) ) ; #2887 = AXIS2_PLACEMENT_3D ( 'NONE', #2886, #2885, #2910 ) ; #2888 = DIRECTION ( 'NONE', ( 2.775557561562890900E-016, -1.000000000000000000, -1.621377732827185800E-016 ) ) ; #2889 = VECTOR ( 'NONE', #2888, 1000.000000000000000 ) ; #2890 =( LENGTH_UNIT ( ) NAMED_UNIT ( * ) SI_UNIT ( .MILLI., .METRE. ) ); #2891 = MECHANICAL_DESIGN_GEOMETRIC_PRESENTATION_REPRESENTATION ( '', ( #2893 ), #2876 ) ; #2892 = PRESENTATION_LAYER_ASSIGNMENT ( '', '', ( #2893 ) ) ; #2893 = STYLED_ITEM ( 'NONE', ( #2894 ), #5129 ) ; #2894 = PRESENTATION_STYLE_ASSIGNMENT (( #2895 ) ) ; #2895 = SURFACE_STYLE_USAGE ( .BOTH. , #2896 ) ; #2896 = SURFACE_SIDE_STYLE ('',( #2897 ) ) ; #2897 = SURFACE_STYLE_FILL_AREA ( #2898 ) ; #2898 = FILL_AREA_STYLE ('',( #2902 ) ) ; #2899 =( NAMED_UNIT ( * ) PLANE_ANGLE_UNIT ( ) SI_UNIT ( $, .RADIAN. ) ); #2900 =( LENGTH_UNIT ( ) NAMED_UNIT ( * ) SI_UNIT ( .MILLI., .METRE. ) ); #2901 = UNCERTAINTY_MEASURE_WITH_UNIT (LENGTH_MEASURE( 1.000000000000000100E-005 ), #2824, 'distance_accuracy_value', 'NONE'); #2902 = FILL_AREA_STYLE_COLOUR ( '', #2903 ) ; #2903 = COLOUR_RGB ( '',0.2000000000000000100, 0.2000000000000000100, 0.2000000000000000100 ) ; #2904 = FACE_OUTER_BOUND ( 'NONE', #5146, .T. ) ; #2905 = CARTESIAN_POINT ( 'NONE', ( -0.09731784655065203700, 0.8921445206346105800, -1.785686304722517100 ) ) ; #2906 = DIRECTION ( 'NONE', ( 1.000000000000000000, 0.0000000000000000000, 0.0000000000000000000 ) ) ; #2907 = VECTOR ( 'NONE', #2906, 1000.000000000000000 ) ; #2908 = CARTESIAN_POINT ( 'NONE', ( -4.237517846550652200, 0.8921445206346105800, -1.785686304722517100 ) ) ; #2909 = LINE ( 'NONE', #2908, #2907 ) ; #2910 = DIRECTION ( 'NONE', ( -7.304406400171826500E-016, 0.0000000000000000000, -1.000000000000000000 ) ) ; #2911 = DIRECTION ( 'NONE', ( 1.022518647196729900E-032, 1.000000000000000000, 1.823917760331861300E-016 ) ) ; #2912 = CARTESIAN_POINT ( 'NONE', ( 3.892082153460546300, -2.342455479365387600, -0.7649217471639047100 ) ) ; #2913 = AXIS2_PLACEMENT_3D ( 'NONE', #2912, #2911, #2840 ) ; #2914 = CIRCLE ( 'NONE', #2913, 0.5588000000000014100 ) ; #2915 = LINE ( 'NONE', #2839, #2838 ) ; #2916 = DIRECTION ( 'NONE', ( -1.000000000000000000, 0.0000000000000000000, 5.335640612625522300E-017 ) ) ; #2917 = CARTESIAN_POINT ( 'NONE', ( 7.244882153449348800, 6.420544520634614100, 0.04311369527748153800 ) ) ; #2918 = DIRECTION ( 'NONE', ( -2.775557561562890900E-016, 1.000000000000000000, 5.993114065094845700E-017 ) ) ; #2919 =( NAMED_UNIT ( * ) PLANE_ANGLE_UNIT ( ) SI_UNIT ( $, .RADIAN. ) ); #2920 =( NAMED_UNIT ( * ) SI_UNIT ( $, .STERADIAN. ) SOLID_ANGLE_UNIT ( ) ); #2921 = PLANE ( 'NONE', #2951 ) ; #2922 = CARTESIAN_POINT ( 'NONE', ( 4.320495486793881000, -2.342455479365387600, -0.4061468096024547500 ) ) ; #2923 = VECTOR ( 'NONE', #2924, 1000.000000000000000 ) ; #2924 = DIRECTION ( 'NONE', ( -1.000000000000000000, -0.0000000000000000000, -0.0000000000000000000 ) ) ; #2925 = CARTESIAN_POINT ( 'NONE', ( 8.030682153449348000, 0.8921445206346105800, -0.2616863047225170800 ) ) ; #2926 = SURFACE_SIDE_STYLE ('',( #2927 ) ) ; #2927 = SURFACE_STYLE_FILL_AREA ( #2928 ) ; #2928 = FILL_AREA_STYLE ('',( #2962 ) ) ; #2929 = FILL_AREA_STYLE ('',( #2930 ) ) ; #2930 = FILL_AREA_STYLE_COLOUR ( '', #2931 ) ; #2931 = COLOUR_RGB ( '',0.2000000000000000100, 0.2000000000000000100, 0.2000000000000000100 ) ; #2932 = FACE_BOUND ( 'NONE', #5213, .T. ) ; #2933 = FACE_OUTER_BOUND ( 'NONE', #5215, .T. ) ; #2934 = FACE_BOUND ( 'NONE', #5195, .T. ) ; #2935 = FACE_BOUND ( 'NONE', #5140, .T. ) ; #2936 = DIRECTION ( 'NONE', ( 0.0000000000000000000, 0.0000000000000000000, -1.000000000000000000 ) ) ; #2937 = DIRECTION ( 'NONE', ( 0.0000000000000000000, 1.000000000000000000, 8.537024980200821300E-017 ) ) ; #2938 = VECTOR ( 'NONE', #2937, 1000.000000000000000 ) ; #2939 = CARTESIAN_POINT ( 'NONE', ( -0.09731784655065203700, 0.8921445206346105800, -1.785686304722517100 ) ) ; #2940 = CARTESIAN_POINT ( 'NONE', ( 8.030682153449348000, -2.282855479365389200, -1.785686304722516700 ) ) ; #2941 = DIRECTION ( 'NONE', ( 0.0000000000000000000, 0.0000000000000000000, 1.000000000000000000 ) ) ; #2942 = CARTESIAN_POINT ( 'NONE', ( 7.573482153449347700, -2.282855479365389200, -1.785686304722517100 ) ) ; #2943 = UNCERTAINTY_MEASURE_WITH_UNIT (LENGTH_MEASURE( 1.000000000000000100E-005 ), #2967, 'distance_accuracy_value', 'NONE'); #2944 = VECTOR ( 'NONE', #2995, 1000.000000000000000 ) ; #2945 = COLOUR_RGB ( '',0.2000000000000000100, 0.2000000000000000100, 0.2000000000000000100 ) ; #2946 = FACE_OUTER_BOUND ( 'NONE', #5189, .T. ) ; #2947 = CARTESIAN_POINT ( 'NONE', ( 3.892082153460546300, -2.342455479365387600, -0.7649217471639047100 ) ) ; #2948 = DIRECTION ( 'NONE', ( 0.0000000000000000000, 0.0000000000000000000, -1.000000000000000000 ) ) ; #2949 = DIRECTION ( 'NONE', ( -1.000000000000000000, 0.0000000000000000000, 0.0000000000000000000 ) ) ; #2950 = CARTESIAN_POINT ( 'NONE', ( -0.09731784655065203700, 0.8921445206346105800, -1.125286304722517200 ) ) ; #2951 = AXIS2_PLACEMENT_3D ( 'NONE', #2950, #2949, #2948 ) ; #2952 = LINE ( 'NONE', #2942, #2923 ) ; #2953 = STYLED_ITEM ( 'NONE', ( #2954 ), #5149 ) ; #2954 = PRESENTATION_STYLE_ASSIGNMENT (( #2955 ) ) ; #2955 = SURFACE_STYLE_USAGE ( .BOTH. , #2926 ) ; #2956 = VECTOR ( 'NONE', #2941, 1000.000000000000000 ) ; #2957 = CARTESIAN_POINT ( 'NONE', ( -0.09731784655065203700, -2.282855479365389200, -1.785686304722517100 ) ) ; #2958 = DIRECTION ( 'NONE', ( -3.359839472817826400E-033, -1.000000000000000000, -5.993114065094840700E-017 ) ) ; #2959 = AXIS2_PLACEMENT_3D ( 'NONE', #2947, #2958, #2936 ) ; #2960 = CIRCLE ( 'NONE', #2959, 0.5588000000000014100 ) ; #2961 = FACE_BOUND ( 'NONE', #5134, .T. ) ; #2962 = FILL_AREA_STYLE_COLOUR ( '', #2945 ) ; #2963 = AXIS2_PLACEMENT_3D ( 'NONE', #2982, #2981, #2980 ) ; #2964 = PLANE ( 'NONE', #2963 ) ; #2965 =( GEOMETRIC_REPRESENTATION_CONTEXT ( 3 ) GLOBAL_UNCERTAINTY_ASSIGNED_CONTEXT ( ( #2970 ) ) GLOBAL_UNIT_ASSIGNED_CONTEXT ( ( #2983, #2969, #2968 ) ) REPRESENTATION_CONTEXT ( 'NONE', 'WORKASPACE' ) ); #2966 =( GEOMETRIC_REPRESENTATION_CONTEXT ( 3 ) GLOBAL_UNCERTAINTY_ASSIGNED_CONTEXT ( ( #2943 ) ) GLOBAL_UNIT_ASSIGNED_CONTEXT ( ( #2967, #2998, #2993 ) ) REPRESENTATION_CONTEXT ( 'NONE', 'WORKASPACE' ) ); #2967 =( LENGTH_UNIT ( ) NAMED_UNIT ( * ) SI_UNIT ( .MILLI., .METRE. ) ); #2968 =( NAMED_UNIT ( * ) SI_UNIT ( $, .STERADIAN. ) SOLID_ANGLE_UNIT ( ) ); #2969 =( NAMED_UNIT ( * ) PLANE_ANGLE_UNIT ( ) SI_UNIT ( $, .RADIAN. ) ); #2970 = UNCERTAINTY_MEASURE_WITH_UNIT (LENGTH_MEASURE( 1.000000000000000100E-005 ), #2983, 'distance_accuracy_value', 'NONE'); #2971 = UNCERTAINTY_MEASURE_WITH_UNIT (LENGTH_MEASURE( 1.000000000000000100E-005 ), #3081, 'distance_accuracy_value', 'NONE'); #2972 = DIRECTION ( 'NONE', ( -0.0000000000000000000, 1.000000000000000000, 8.537024980200821300E-017 ) ) ; #2973 = VECTOR ( 'NONE', #2972, 1000.000000000000000 ) ; #2974 = CARTESIAN_POINT ( 'NONE', ( 8.030682153449348000, 0.8921445206346105800, -1.785686304722517100 ) ) ; #2975 = LINE ( 'NONE', #2974, #2973 ) ; #2976 = DIRECTION ( 'NONE', ( 7.304406400171826500E-016, -0.0000000000000000000, 1.000000000000000000 ) ) ; #2977 = VECTOR ( 'NONE', #2976, 1000.000000000000000 ) ; #2978 = CARTESIAN_POINT ( 'NONE', ( -5.444017846550651500, -2.282855479365389200, 1.846513695277483200 ) ) ; #2979 = LINE ( 'NONE', #2978, #2977 ) ; #2980 = DIRECTION ( 'NONE', ( 0.0000000000000000000, -0.0000000000000000000, 1.000000000000000000 ) ) ; #2981 = DIRECTION ( 'NONE', ( 0.0000000000000000000, 1.000000000000000000, 0.0000000000000000000 ) ) ; #2982 = CARTESIAN_POINT ( 'NONE', ( -5.444017846550651500, -2.282855479365389200, 1.846513695277483200 ) ) ; #2983 =( LENGTH_UNIT ( ) NAMED_UNIT ( * ) SI_UNIT ( .MILLI., .METRE. ) ); #2984 = MECHANICAL_DESIGN_GEOMETRIC_PRESENTATION_REPRESENTATION ( '', ( #2986 ), #2965 ) ; #2985 = PRESENTATION_LAYER_ASSIGNMENT ( '', '', ( #2986 ) ) ; #2986 = STYLED_ITEM ( 'NONE', ( #2987 ), #5157 ) ; #2987 = PRESENTATION_STYLE_ASSIGNMENT (( #2988 ) ) ; #2988 = SURFACE_STYLE_USAGE ( .BOTH. , #2989 ) ; #2989 = SURFACE_SIDE_STYLE ('',( #2990 ) ) ; #2990 = SURFACE_STYLE_FILL_AREA ( #2929 ) ; #2991 = LINE ( 'NONE', #2957, #2956 ) ; #2992 = LINE ( 'NONE', #2939, #2938 ) ; #2993 =( NAMED_UNIT ( * ) SI_UNIT ( $, .STERADIAN. ) SOLID_ANGLE_UNIT ( ) ); #2994 = LINE ( 'NONE', #2925, #2944 ) ; #2995 = DIRECTION ( 'NONE', ( -0.0000000000000000000, -0.0000000000000000000, 1.000000000000000000 ) ) ; #2996 = MECHANICAL_DESIGN_GEOMETRIC_PRESENTATION_REPRESENTATION ( '', ( #2953 ), #2966 ) ; #2997 = PRESENTATION_LAYER_ASSIGNMENT ( '', '', ( #2953 ) ) ; #2998 =( NAMED_UNIT ( * ) PLANE_ANGLE_UNIT ( ) SI_UNIT ( $, .RADIAN. ) ); #2999 =( NAMED_UNIT ( * ) PLANE_ANGLE_UNIT ( ) SI_UNIT ( $, .RADIAN. ) ); #3000 = SURFACE_STYLE_USAGE ( .BOTH. , #3002 ) ; #3001 =( NAMED_UNIT ( * ) SI_UNIT ( $, .STERADIAN. ) SOLID_ANGLE_UNIT ( ) ); #3002 = SURFACE_SIDE_STYLE ('',( #3004 ) ) ; #3003 = MECHANICAL_DESIGN_GEOMETRIC_PRESENTATION_REPRESENTATION ( '', ( #3012 ), #3018 ) ; #3004 = SURFACE_STYLE_FILL_AREA ( #3007 ) ; #3005 = FACE_BOUND ( 'NONE', #5158, .T. ) ; #3006 =( LENGTH_UNIT ( ) NAMED_UNIT ( * ) SI_UNIT ( .MILLI., .METRE. ) ); #3007 = FILL_AREA_STYLE ('',( #3015 ) ) ; #3008 = UNCERTAINTY_MEASURE_WITH_UNIT (LENGTH_MEASURE( 1.000000000000000100E-005 ), #3006, 'distance_accuracy_value', 'NONE'); #3009 = PRESENTATION_STYLE_ASSIGNMENT (( #3000 ) ) ; #3010 = FACE_OUTER_BOUND ( 'NONE', #5127, .T. ) ; #3011 = PRESENTATION_LAYER_ASSIGNMENT ( '', '', ( #3012 ) ) ; #3012 = STYLED_ITEM ( 'NONE', ( #3009 ), #5165 ) ; #3013 = FACE_BOUND ( 'NONE', #4834, .T. ) ; #3014 = COLOUR_RGB ( '',0.2000000000000000100, 0.2000000000000000100, 0.2000000000000000100 ) ; #3015 = FILL_AREA_STYLE_COLOUR ( '', #3014 ) ; #3016 = AXIS2_PLACEMENT_3D ( 'NONE', #2756, #2757, #2753 ) ; #3017 = PLANE ( 'NONE', #3016 ) ; #3018 =( GEOMETRIC_REPRESENTATION_CONTEXT ( 3 ) GLOBAL_UNCERTAINTY_ASSIGNED_CONTEXT ( ( #3008 ) ) GLOBAL_UNIT_ASSIGNED_CONTEXT ( ( #3006, #2999, #3001 ) ) REPRESENTATION_CONTEXT ( 'NONE', 'WORKASPACE' ) ); #3019 = DIRECTION ( 'NONE', ( -1.000000000000000000, 0.0000000000000000000, 0.0000000000000000000 ) ) ; #3020 = LINE ( 'NONE', #3025, #3027 ) ; #3021 = LINE ( 'NONE', #3026, #3023 ) ; #3022 =( GEOMETRIC_REPRESENTATION_CONTEXT ( 3 ) GLOBAL_UNCERTAINTY_ASSIGNED_CONTEXT ( ( #2971 ) ) GLOBAL_UNIT_ASSIGNED_CONTEXT ( ( #3081, #2772, #2870 ) ) REPRESENTATION_CONTEXT ( 'NONE', 'WORKASPACE' ) ); #3023 = VECTOR ( 'NONE', #3024, 1000.000000000000000 ) ; #3024 = DIRECTION ( 'NONE', ( -0.0000000000000000000, -0.0000000000000000000, -1.000000000000000000 ) ) ; #3025 = CARTESIAN_POINT ( 'NONE', ( 8.030682153449348000, 0.8921445206346105800, -1.785686304722517100 ) ) ; #3026 = CARTESIAN_POINT ( 'NONE', ( 8.030682153449348000, -2.282855479365389200, -1.785686304722517100 ) ) ; #3027 = VECTOR ( 'NONE', #3019, 1000.000000000000000 ) ; #3028 = LINE ( 'NONE', #3056, #3034 ) ; #3029 = UNCERTAINTY_MEASURE_WITH_UNIT (LENGTH_MEASURE( 1.000000000000000100E-005 ), #3038, 'distance_accuracy_value', 'NONE'); #3030 =( NAMED_UNIT ( * ) SI_UNIT ( $, .STERADIAN. ) SOLID_ANGLE_UNIT ( ) ); #3031 = SURFACE_STYLE_USAGE ( .BOTH. , #3037 ) ; #3032 = CARTESIAN_POINT ( 'NONE', ( 8.030682153449348000, 0.8921445206346105800, -1.785686304722517100 ) ) ; #3033 = CARTESIAN_POINT ( 'NONE', ( 4.450882153460548300, -2.342455479365387600, -0.7649217471639047100 ) ) ; #3034 = VECTOR ( 'NONE', #3063, 1000.000000000000000 ) ; #3035 = FILL_AREA_STYLE ('',( #3057 ) ) ; #3036 = FACE_OUTER_BOUND ( 'NONE', #5159, .T. ) ; #3037 = SURFACE_SIDE_STYLE ('',( #3065 ) ) ; #3038 =( LENGTH_UNIT ( ) NAMED_UNIT ( * ) SI_UNIT ( .MILLI., .METRE. ) ); #3039 = MECHANICAL_DESIGN_GEOMETRIC_PRESENTATION_REPRESENTATION ( '', ( #3054 ), #3062 ) ; #3040 = CARTESIAN_POINT ( 'NONE', ( -4.237517846550652200, 0.8921445206346105800, -1.785686304722517100 ) ) ; #3041 = AXIS2_PLACEMENT_3D ( 'NONE', #3040, #3046, #3045 ) ; #3042 = FILL_AREA_STYLE_COLOUR ( '', #3043 ) ; #3043 = COLOUR_RGB ( '',0.2000000000000000100, 0.2000000000000000100, 0.2000000000000000100 ) ; #3044 = FACE_OUTER_BOUND ( 'NONE', #5197, .T. ) ; #3045 = DIRECTION ( 'NONE', ( 0.0000000000000000000, 1.000000000000000000, 8.537024980200821300E-017 ) ) ; #3046 = DIRECTION ( 'NONE', ( 0.0000000000000000000, 8.537024980200821300E-017, -1.000000000000000000 ) ) ; #3047 = MECHANICAL_DESIGN_GEOMETRIC_PRESENTATION_REPRESENTATION ( '', ( #3049 ), #2764 ) ; #3048 = PRESENTATION_LAYER_ASSIGNMENT ( '', '', ( #3049 ) ) ; #3049 = STYLED_ITEM ( 'NONE', ( #3050 ), #5194 ) ; #3050 = PRESENTATION_STYLE_ASSIGNMENT (( #3051 ) ) ; #3051 = SURFACE_STYLE_USAGE ( .BOTH. , #3058 ) ; #3052 = PRESENTATION_STYLE_ASSIGNMENT (( #3031 ) ) ; #3053 = PRESENTATION_LAYER_ASSIGNMENT ( '', '', ( #3054 ) ) ; #3054 = STYLED_ITEM ( 'NONE', ( #3052 ), #5174 ) ; #3055 = COLOUR_RGB ( '',0.2000000000000000100, 0.2000000000000000100, 0.2000000000000000100 ) ; #3056 = CARTESIAN_POINT ( 'NONE', ( -0.09731784655065203700, 0.8921445206346105800, -0.2616863047225170800 ) ) ; #3057 = FILL_AREA_STYLE_COLOUR ( '', #3055 ) ; #3058 = SURFACE_SIDE_STYLE ('',( #3059 ) ) ; #3059 = SURFACE_STYLE_FILL_AREA ( #3060 ) ; #3060 = FILL_AREA_STYLE ('',( #3042 ) ) ; #3061 = PLANE ( 'NONE', #3041 ) ; #3062 =( GEOMETRIC_REPRESENTATION_CONTEXT ( 3 ) GLOBAL_UNCERTAINTY_ASSIGNED_CONTEXT ( ( #3029 ) ) GLOBAL_UNIT_ASSIGNED_CONTEXT ( ( #3038, #3064, #3030 ) ) REPRESENTATION_CONTEXT ( 'NONE', 'WORKASPACE' ) ); #3063 = DIRECTION ( 'NONE', ( 0.0000000000000000000, 0.0000000000000000000, 1.000000000000000000 ) ) ; #3064 =( NAMED_UNIT ( * ) PLANE_ANGLE_UNIT ( ) SI_UNIT ( $, .RADIAN. ) ); #3065 = SURFACE_STYLE_FILL_AREA ( #3035 ) ; #3066 =( LENGTH_UNIT ( ) NAMED_UNIT ( * ) SI_UNIT ( .MILLI., .METRE. ) ); #3067 = DIRECTION ( 'NONE', ( -1.000000000000000000, 0.0000000000000000000, 5.606166404184160800E-017 ) ) ; #3068 = CIRCLE ( 'NONE', #3101, 0.1630795170733867200 ) ; #3069 = CIRCLE ( 'NONE', #3111, 0.3587749375614500100 ) ; #3070 = SURFACE_STYLE_USAGE ( .BOTH. , #3071 ) ; #3071 = SURFACE_SIDE_STYLE ('',( #3072 ) ) ; #3072 = SURFACE_STYLE_FILL_AREA ( #3073 ) ; #3073 = FILL_AREA_STYLE ('',( #3098 ) ) ; #3074 = COLOUR_RGB ( '',0.7960784313725489700, 0.8235294117647058400, 0.9372549019607843100 ) ; #3075 = DIRECTION ( 'NONE', ( -1.000000000000000000, 0.0000000000000000000, 5.606166404184160800E-017 ) ) ; #3076 = CIRCLE ( 'NONE', #3107, 0.1630795170733867200 ) ; #3077 = DIRECTION ( 'NONE', ( 0.0000000000000000000, 1.000000000000000000, 0.0000000000000000000 ) ) ; #3078 = DIRECTION ( 'NONE', ( -1.000000000000000000, 0.0000000000000000000, 5.606166404184160800E-017 ) ) ; #3079 = CARTESIAN_POINT ( 'NONE', ( 4.086815486793881300, -2.342455479365387600, -0.7649217471639049300 ) ) ; #3080 = AXIS2_PLACEMENT_3D ( 'NONE', #3079, #3078, #3077 ) ; #3081 =( LENGTH_UNIT ( ) NAMED_UNIT ( * ) SI_UNIT ( .MILLI., .METRE. ) ); #3082 = MECHANICAL_DESIGN_GEOMETRIC_PRESENTATION_REPRESENTATION ( '', ( #3084 ), #3022 ) ; #3083 = PRESENTATION_LAYER_ASSIGNMENT ( '', '', ( #3084 ) ) ; #3084 = STYLED_ITEM ( 'NONE', ( #3085 ), #5234 ) ; #3085 = PRESENTATION_STYLE_ASSIGNMENT (( #3086 ) ) ; #3086 = SURFACE_STYLE_USAGE ( .BOTH. , #3087 ) ; #3087 = SURFACE_SIDE_STYLE ('',( #3088 ) ) ; #3088 = SURFACE_STYLE_FILL_AREA ( #3089 ) ; #3089 = FILL_AREA_STYLE ('',( #3097 ) ) ; #3090 = CARTESIAN_POINT ( 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
) ) ; #3142 = CARTESIAN_POINT ( 'NONE', ( -1.445117846550652700, 6.420544520634610600, -0.3886863047225176900 ) ) ; #3143 = UNCERTAINTY_MEASURE_WITH_UNIT (LENGTH_MEASURE( 1.000000000000000100E-005 ), #3066, 'distance_accuracy_value', 'NONE'); #3144 = DIRECTION ( 'NONE', ( 0.0000000000000000000, 0.0000000000000000000, 1.000000000000000000 ) ) ; #3145 = CARTESIAN_POINT ( 'NONE', ( 3.892082153460546300, -2.342455479365387600, -0.7649217471639047100 ) ) ; #3146 = UNCERTAINTY_MEASURE_WITH_UNIT (LENGTH_MEASURE( 1.000000000000000100E-005 ), #3241, 'distance_accuracy_value', 'NONE'); #3147 = AXIS2_PLACEMENT_3D ( 'NONE', #3145, #3149, #3144 ) ; #3148 = SPHERICAL_SURFACE ( 'NONE', #3147, 0.2540000000000013900 ) ; #3149 = DIRECTION ( 'NONE', ( 0.0000000000000000000, 1.000000000000000000, -0.0000000000000000000 ) ) ; #3150 = LINE ( 'NONE', #3151, #2750 ) ; #3151 = CARTESIAN_POINT ( 'NONE', ( 8.030682153449348000, 0.8921445206346105800, 0.7289136952774799600 ) ) ; #3152 = CARTESIAN_POINT ( 'NONE', ( 3.890482153449347400, 0.8921445206346105800, -1.785686304722517100 ) ) ; #3153 = SURFACE_STYLE_USAGE ( .BOTH. , #3154 ) ; #3154 = SURFACE_SIDE_STYLE ('',( #3155 ) ) ; #3155 = SURFACE_STYLE_FILL_AREA ( #3156 ) ; #3156 = FILL_AREA_STYLE ('',( #3157 ) ) ; #3157 = FILL_AREA_STYLE_COLOUR ( '', #3158 ) ; #3158 = COLOUR_RGB ( '',0.7960784313725489700, 0.8235294117647058400, 0.9372549019607843100 ) ; #3159 = FACE_OUTER_BOUND ( 'NONE', #5268, .T. ) ; #3160 = CARTESIAN_POINT ( 'NONE', ( 4.086815486793881300, -2.342455479365387600, -0.6018422300905180700 ) ) ; #3161 = CARTESIAN_POINT ( 'NONE', ( 4.086815486793881300, -2.342455479365387600, -0.9280012642372916800 ) ) ; #3162 = DIRECTION ( 'NONE', ( 0.0000000000000000000, 1.000000000000000000, 0.0000000000000000000 ) ) ; #3163 = COLOUR_RGB ( '',0.7960784313725489700, 0.8235294117647058400, 0.9372549019607843100 ) ; #3164 =( NAMED_UNIT ( * ) PLANE_ANGLE_UNIT ( ) SI_UNIT ( $, .RADIAN. ) ); #3165 =( LENGTH_UNIT ( ) NAMED_UNIT ( * ) SI_UNIT ( .MILLI., .METRE. ) ); #3166 = PRESENTATION_LAYER_ASSIGNMENT ( '', '', ( #3199 ) ) ; #3167 = UNCERTAINTY_MEASURE_WITH_UNIT (LENGTH_MEASURE( 1.000000000000000100E-005 ), #3177, 'distance_accuracy_value', 'NONE'); #3168 =( NAMED_UNIT ( * ) SI_UNIT ( $, .STERADIAN. ) SOLID_ANGLE_UNIT ( ) ); #3169 =( NAMED_UNIT ( * ) PLANE_ANGLE_UNIT ( ) SI_UNIT ( $, .RADIAN. ) ); #3170 = UNCERTAINTY_MEASURE_WITH_UNIT (LENGTH_MEASURE( 1.000000000000000100E-005 ), #3229, 'distance_accuracy_value', 'NONE'); #3171 =( NAMED_UNIT ( * ) SI_UNIT ( $, .STERADIAN. ) SOLID_ANGLE_UNIT ( ) ); #3172 = PRESENTATION_STYLE_ASSIGNMENT (( #3202 ) ) ; #3173 = SURFACE_SIDE_STYLE ('',( #3191 ) ) ; #3174 = DIRECTION ( 'NONE', ( 6.095048960246059200E-033, 1.000000000000000000, 1.087204431837239300E-016 ) ) ; #3175 = DIRECTION ( 'NONE', ( 1.000000000000000000, 0.0000000000000000000, -5.606166404184160800E-017 ) ) ; #3176 = AXIS2_PLACEMENT_3D ( 'NONE', #3218, #3175, #3174 ) ; #3177 =( LENGTH_UNIT ( ) NAMED_UNIT ( * ) SI_UNIT ( .MILLI., .METRE. ) ); #3178 = MECHANICAL_DESIGN_GEOMETRIC_PRESENTATION_REPRESENTATION ( '', ( #3180 ), #3204 ) ; #3179 = PRESENTATION_LAYER_ASSIGNMENT ( '', '', ( #3180 ) ) ; #3180 = STYLED_ITEM ( 'NONE', ( #3181 ), #5252 ) ; #3181 = PRESENTATION_STYLE_ASSIGNMENT (( #3153 ) ) ; #3182 = AXIS2_PLACEMENT_3D ( 'NONE', #2917, #2918, #2916 ) ; #3183 = CIRCLE ( 'NONE', #3182, 0.3809999999999993900 ) ; #3184 =( GEOMETRIC_REPRESENTATION_CONTEXT ( 3 ) GLOBAL_UNCERTAINTY_ASSIGNED_CONTEXT ( ( #3146 ) ) GLOBAL_UNIT_ASSIGNED_CONTEXT ( ( #3241, #2919, #2920 ) ) REPRESENTATION_CONTEXT ( 'NONE', 'WORKASPACE' ) ); #3185 = CARTESIAN_POINT ( 'NONE', ( 7.625882153449350800, -0.1326554793653871900, -0.08388630472251895600 ) ) ; #3186 = DIRECTION ( 'NONE', ( 2.775557561562890900E-016, -1.000000000000000000, 7.776281064261323500E-017 ) ) ; #3187 = DIRECTION ( 'NONE', ( -5.606166404184158300E-017, -7.776281064261324700E-017, -1.000000000000000000 ) ) ; #3188 = CARTESIAN_POINT ( 'NONE', ( 3.917482153449350200, 1.442144520634612800, -0.08388630472251884500 ) ) ; #3189 = AXIS2_PLACEMENT_3D ( 'NONE', #3188, #3187, #3186 ) ; #3190 =( GEOMETRIC_REPRESENTATION_CONTEXT ( 3 ) GLOBAL_UNCERTAINTY_ASSIGNED_CONTEXT ( ( #3170 ) ) GLOBAL_UNIT_ASSIGNED_CONTEXT ( ( #3229, #3220, #3171 ) ) REPRESENTATION_CONTEXT ( 'NONE', 'WORKASPACE' ) ); #3191 = SURFACE_STYLE_FILL_AREA ( #3192 ) ; #3192 = FILL_AREA_STYLE ('',( #3228 ) ) ; #3193 = DIRECTION ( 'NONE', ( -1.000000000000000000, 0.0000000000000000000, 5.606166404184160800E-017 ) ) ; #3194 = CARTESIAN_POINT ( 'NONE', ( 3.968282153460548100, -2.342455479365387600, -0.7649217471639047100 ) ) ; #3195 = AXIS2_PLACEMENT_3D ( 'NONE', #3194, #3193, #3162 ) ; #3196 = CIRCLE ( 'NONE', #3195, 0.4892385512201588600 ) ; #3197 = DIRECTION ( 'NONE', ( 1.000000000000000000, 0.0000000000000000000, -5.606166404184160800E-017 ) ) ; #3198 =( GEOMETRIC_REPRESENTATION_CONTEXT ( 3 ) GLOBAL_UNCERTAINTY_ASSIGNED_CONTEXT ( ( #3210 ) ) GLOBAL_UNIT_ASSIGNED_CONTEXT ( ( #3165, #3164, #3211 ) ) REPRESENTATION_CONTEXT ( 'NONE', 'WORKASPACE' ) ); #3199 = STYLED_ITEM ( 'NONE', ( #3172 ), #5235 ) ; #3200 = MECHANICAL_DESIGN_GEOMETRIC_PRESENTATION_REPRESENTATION ( '', ( #3212 ), #3190 ) ; #3201 = PRESENTATION_LAYER_ASSIGNMENT ( '', '', ( #3212 ) ) ; #3202 = SURFACE_STYLE_USAGE ( .BOTH. , #3173 ) ; #3203 = PLANE ( 'NONE', #3189 ) ; #3204 =( GEOMETRIC_REPRESENTATION_CONTEXT ( 3 ) GLOBAL_UNCERTAINTY_ASSIGNED_CONTEXT ( ( #3167 ) ) GLOBAL_UNIT_ASSIGNED_CONTEXT ( ( #3177, #3169, #3168 ) ) REPRESENTATION_CONTEXT ( 'NONE', 'WORKASPACE' ) ); #3205 = DIRECTION ( 'NONE', ( 2.775557561562890900E-016, -1.000000000000000000, -5.993114065094845700E-017 ) ) ; #3206 = VECTOR ( 'NONE', #3205, 1000.000000000000000 ) ; #3207 = CARTESIAN_POINT ( 'NONE', ( 6.355882153449347700, 6.420544520634614100, -0.3886863047225174700 ) ) ; #3208 = LINE ( 'NONE', #3207, #3206 ) ; #3209 = LINE ( 'NONE', #3227, #3226 ) ; #3210 = UNCERTAINTY_MEASURE_WITH_UNIT (LENGTH_MEASURE( 1.000000000000000100E-005 ), #3165, 'distance_accuracy_value', 'NONE'); #3211 =( NAMED_UNIT ( * ) SI_UNIT ( $, .STERADIAN. ) SOLID_ANGLE_UNIT ( ) ); #3212 = STYLED_ITEM ( 'NONE', ( #3213 ), #5238 ) ; #3213 = PRESENTATION_STYLE_ASSIGNMENT (( #3214 ) ) ; #3214 = SURFACE_STYLE_USAGE ( .BOTH. , #3215 ) ; #3215 = SURFACE_SIDE_STYLE ('',( #3216 ) ) ; #3216 = SURFACE_STYLE_FILL_AREA ( #3217 ) ; #3217 = FILL_AREA_STYLE ('',( #3223 ) ) ; #3218 = CARTESIAN_POINT ( 'NONE', ( 7.422682153438154600, -2.342455479365387600, -0.7649217471639049300 ) ) ; #3219 = TOROIDAL_SURFACE ( 'NONE', #3176, 0.4892385512201587500, 0.5080000000000000100 ) ; #3220 =( NAMED_UNIT ( * ) PLANE_ANGLE_UNIT ( ) SI_UNIT ( $, .RADIAN. ) ); #3221 = CARTESIAN_POINT ( 'NONE', ( 4.086815486793881300, -2.342455479365387600, -0.7649217471639049300 ) ) ; #3222 = CIRCLE ( 'NONE', #3238, 0.1630795170733867200 ) ; #3223 = FILL_AREA_STYLE_COLOUR ( '', #3235 ) ; #3224 = CARTESIAN_POINT ( 'NONE', ( 7.930682153449350100, -0.1326554793653871900, -0.08388630472251895600 ) ) ; #3225 = DIRECTION ( 'NONE', ( 2.775557561562890900E-016, -1.000000000000000000, 7.776281064261323500E-017 ) ) ; #3226 = VECTOR ( 'NONE', #3225, 1000.000000000000000 ) ; #3227 = CARTESIAN_POINT ( 'NONE', ( 7.930682153449348300, 6.420544520634614100, -0.08388630472251938600 ) ) ; #3228 = FILL_AREA_STYLE_COLOUR ( '', #3163 ) ; #3229 =( LENGTH_UNIT ( ) NAMED_UNIT ( * ) SI_UNIT ( .MILLI., .METRE. ) ); #3230 = FACE_OUTER_BOUND ( 'NONE', #5228, .T. ) ; #3231 = MECHANICAL_DESIGN_GEOMETRIC_PRESENTATION_REPRESENTATION ( '', ( #3199 ), #3198 ) ; #3232 = DIRECTION ( 'NONE', ( -1.000000000000000000, 0.0000000000000000000, 5.606166404184160800E-017 ) ) ; #3233 = DIRECTION ( 'NONE', ( 0.0000000000000000000, 1.000000000000000000, 0.0000000000000000000 ) ) ; #3234 = AXIS2_PLACEMENT_3D ( 'NONE', #3239, #3197, #3233 ) ; #3235 = COLOUR_RGB ( '',0.7960784313725489700, 0.8235294117647058400, 0.9372549019607843100 ) ; #3236 = FACE_OUTER_BOUND ( 'NONE', #5258, .T. ) ; #3237 = DIRECTION ( 'NONE', ( 0.0000000000000000000, 1.000000000000000000, 0.0000000000000000000 ) ) ; #3238 = AXIS2_PLACEMENT_3D ( 'NONE', #3221, #3232, #3237 ) ; #3239 = CARTESIAN_POINT ( 'NONE', ( 7.422682153438154600, -2.342455479365387600, -0.7649217471639049300 ) ) ; #3240 = TOROIDAL_SURFACE ( 'NONE', #3234, 0.4892385512201587500, 0.2032000000000000200 ) ; #3241 =( LENGTH_UNIT ( ) NAMED_UNIT ( * ) SI_UNIT ( .MILLI., .METRE. ) ); #3242 = SURFACE_SIDE_STYLE ('',( #3243 ) ) ; #3243 = SURFACE_STYLE_FILL_AREA ( #3255 ) ; #3244 = DIRECTION ( 'NONE', ( -1.000000000000000000, 0.0000000000000000000, 5.606166404184160800E-017 ) ) ; #3245 = PRESENTATION_STYLE_ASSIGNMENT (( #3246 ) ) ; #3246 = SURFACE_STYLE_USAGE ( .BOTH. , #3242 ) ; #3247 = AXIS2_PLACEMENT_3D ( 'NONE', #3254, #3244, #3257 ) ; #3248 = PRESENTATION_LAYER_ASSIGNMENT ( '', '', ( #3249 ) ) ; #3249 = STYLED_ITEM ( 'NONE', ( #3245 ), #5262 ) ; #3250 = CIRCLE ( 'NONE', #3247, 0.1630795170733867200 ) ; #3251 = FACE_OUTER_BOUND ( 'NONE', #5241, .T. ) ; #3252 = MECHANICAL_DESIGN_GEOMETRIC_PRESENTATION_REPRESENTATION ( '', ( #3249 ), #3184 ) ; #3253 = COLOUR_RGB ( '',0.7960784313725489700, 0.8235294117647058400, 0.9372549019607843100 ) ; #3254 = CARTESIAN_POINT ( 'NONE', ( 4.086815486793881300, -2.342455479365387600, -0.7649217471639049300 ) ) ; #3255 = FILL_AREA_STYLE ('',( #3256 ) ) ; #3256 = FILL_AREA_STYLE_COLOUR ( '', #3253 ) ; #3257 = DIRECTION ( 'NONE', ( 0.0000000000000000000, 1.000000000000000000, 0.0000000000000000000 ) ) ; #3258 = CIRCLE ( 'NONE', #3259, 0.2540000000000013900 ) ; #3259 = AXIS2_PLACEMENT_3D ( 'NONE', #3262, #3298, #3297 ) ; #3260 = SPHERICAL_SURFACE ( 'NONE', #3301, 0.2540000000000013900 ) ; #3261 = CARTESIAN_POINT ( 'NONE', ( 7.812148820104821000, -2.342455479365387600, -0.9280012642372919000 ) ) ; #3262 = CARTESIAN_POINT ( 'NONE', ( 8.006882153438155600, -2.342455479365387600, -0.7649217471639051500 ) ) ; #3263 = DIRECTION ( 'NONE', ( 0.0000000000000000000, 0.0000000000000000000, 1.000000000000000000 ) ) ; #3264 = CARTESIAN_POINT ( 'NONE', ( 8.006882153438155600, -2.342455479365387600, -0.7649217471639051500 ) ) ; #3265 = DIRECTION ( 'NONE', ( 0.0000000000000000000, -1.000000000000000000, 0.0000000000000000000 ) ) ; #3266 = LINE ( 'NONE', #3278, #3277 ) ; #3267 = DIRECTION ( 'NONE', ( 0.0000000000000000000, 0.0000000000000000000, -1.000000000000000000 ) ) ; #3268 = DIRECTION ( 'NONE', ( -3.359839472817826400E-033, -1.000000000000000000, -5.993114065094840700E-017 ) ) ; #3269 = DIRECTION ( 'NONE', ( 0.0000000000000000000, 1.0000000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
PRESENTATION_REPRESENTATION ( '', ( #3375 ), #3409 ) ; #3321 = DIRECTION ( 'NONE', ( 2.775557561562890900E-016, -1.000000000000000000, -5.993114065094845700E-017 ) ) ; #3322 =( GEOMETRIC_REPRESENTATION_CONTEXT ( 3 ) GLOBAL_UNCERTAINTY_ASSIGNED_CONTEXT ( ( #3323 ) ) GLOBAL_UNIT_ASSIGNED_CONTEXT ( ( #4064, #3325, #3324 ) ) REPRESENTATION_CONTEXT ( 'NONE', 'WORKASPACE' ) ); #3323 = UNCERTAINTY_MEASURE_WITH_UNIT (LENGTH_MEASURE( 1.000000000000000100E-005 ), #4064, 'distance_accuracy_value', 'NONE'); #3324 =( NAMED_UNIT ( * ) SI_UNIT ( $, .STERADIAN. ) SOLID_ANGLE_UNIT ( ) ); #3325 =( NAMED_UNIT ( * ) PLANE_ANGLE_UNIT ( ) SI_UNIT ( $, .RADIAN. ) ); #3326 =( LENGTH_UNIT ( ) NAMED_UNIT ( * ) SI_UNIT ( .MILLI., .METRE. ) ); #3327 =( NAMED_UNIT ( * ) PLANE_ANGLE_UNIT ( ) SI_UNIT ( $, .RADIAN. ) ); #3328 = PRESENTATION_STYLE_ASSIGNMENT (( #3329 ) ) ; #3329 = SURFACE_STYLE_USAGE ( .BOTH. , #3330 ) ; #3330 = SURFACE_SIDE_STYLE ('',( #3331 ) ) ; #3331 = SURFACE_STYLE_FILL_AREA ( #3358 ) ; #3332 = CARTESIAN_POINT ( 'NONE', ( 4.654082153449349100, 6.420544520634614100, 0.4241136952774814900 ) ) ; #3333 = LINE ( 'NONE', #3351, #3350 ) ; #3334 = FILL_AREA_STYLE_COLOUR ( '', #3359 ) ; #3335 = VECTOR ( 'NONE', #3321, 1000.000000000000000 ) ; #3336 = CARTESIAN_POINT ( 'NONE', ( 5.543082153449349300, 6.420544520634614100, -0.3886863047225187500 ) ) ; #3337 = DIRECTION ( 'NONE', ( -1.000000000000000000, 0.0000000000000000000, 0.0000000000000000000 ) ) ; #3338 = DIRECTION ( 'NONE', ( -2.775557561562890900E-016, 1.000000000000000000, 5.993114065094845700E-017 ) ) ; #3339 = CARTESIAN_POINT ( 'NONE', ( 4.755682153449351200, 1.442144520634612800, -0.3886863047225187500 ) ) ; #3340 = AXIS2_PLACEMENT_3D ( 'NONE', #3339, #3338, #3337 ) ; #3341 = CIRCLE ( 'NONE', #3340, 0.4825999999999997000 ) ; #3342 = CARTESIAN_POINT ( 'NONE', ( 4.273082153449348800, 6.420544520634614100, -0.3886863047225185300 ) ) ; #3343 = DIRECTION ( 'NONE', ( -2.775557561562890900E-016, 1.000000000000000000, 5.993114065094842000E-017 ) ) ; #3344 = CARTESIAN_POINT ( 'NONE', ( 4.273082153449350600, 1.442144520634612800, -0.3886863047225187500 ) ) ; #3345 =( LENGTH_UNIT ( ) NAMED_UNIT ( * ) SI_UNIT ( .MILLI., .METRE. ) ); #3346 = MECHANICAL_DESIGN_GEOMETRIC_PRESENTATION_REPRESENTATION ( '', ( #3348 ), #3363 ) ; #3347 = PRESENTATION_LAYER_ASSIGNMENT ( '', '', ( #3348 ) ) ; #3348 = STYLED_ITEM ( 'NONE', ( #3328 ), #5693 ) ; #3349 = DIRECTION ( 'NONE', ( 2.775557561562890900E-016, -1.000000000000000000, -5.993114065094845700E-017 ) ) ; #3350 = VECTOR ( 'NONE', #3349, 1000.000000000000000 ) ; #3351 = CARTESIAN_POINT ( 'NONE', ( 5.238282153449349100, 6.420544520634614100, -0.3886863047225185300 ) ) ; #3352 = AXIS2_PLACEMENT_3D ( 'NONE', #3342, #3343, #3367 ) ; #3353 = PLANE ( 'NONE', #3352 ) ; #3354 = LINE ( 'NONE', #3336, #3335 ) ; #3355 = DIRECTION ( 'NONE', ( 0.0000000000000000000, 0.0000000000000000000, 1.000000000000000000 ) ) ; #3356 = DIRECTION ( 'NONE', ( 2.775557561562890900E-016, -1.000000000000000000, -5.993114065094845700E-017 ) ) ; #3357 = AXIS2_PLACEMENT_3D ( 'NONE', #3361, #3356, #3355 ) ; #3358 = FILL_AREA_STYLE ('',( #3334 ) ) ; #3359 = COLOUR_RGB ( '',0.7960784313725489700, 0.8235294117647058400, 0.9372549019607843100 ) ; #3360 = FACE_OUTER_BOUND ( 'NONE', #5848, .T. ) ; #3361 = CARTESIAN_POINT ( 'NONE', ( 4.755682153449349400, 6.420544520634614100, -0.3886863047225185300 ) ) ; #3362 = CYLINDRICAL_SURFACE ( 'NONE', #3357, 0.4825999999999999700 ) ; #3363 =( GEOMETRIC_REPRESENTATION_CONTEXT ( 3 ) GLOBAL_UNCERTAINTY_ASSIGNED_CONTEXT ( ( #3365 ) ) GLOBAL_UNIT_ASSIGNED_CONTEXT ( ( #3345, #3364, #3366 ) ) REPRESENTATION_CONTEXT ( 'NONE', 'WORKASPACE' ) ); #3364 =( NAMED_UNIT ( * ) PLANE_ANGLE_UNIT ( ) SI_UNIT ( $, .RADIAN. ) ); #3365 = UNCERTAINTY_MEASURE_WITH_UNIT (LENGTH_MEASURE( 1.000000000000000100E-005 ), #3345, 'distance_accuracy_value', 'NONE'); #3366 =( NAMED_UNIT ( * ) SI_UNIT ( $, .STERADIAN. ) SOLID_ANGLE_UNIT ( ) ); #3367 = DIRECTION ( 'NONE', ( -5.606166404184162000E-017, 5.993114065094840700E-017, -1.000000000000000000 ) ) ; #3368 = LINE ( 'NONE', #3372, #3371 ) ; #3369 = CIRCLE ( 'NONE', #3386, 0.7873999999999999900 ) ; #3370 = DIRECTION ( 'NONE', ( 2.775557561562890900E-016, -1.000000000000000000, -5.993114065094845700E-017 ) ) ; #3371 = VECTOR ( 'NONE', #3370, 1000.000000000000000 ) ; #3372 = CARTESIAN_POINT ( 'NONE', ( 3.968282153449348600, 6.420544520634614100, -0.3886863047225183600 ) ) ; #3373 = CARTESIAN_POINT ( 'NONE', ( 7.244882153449348800, 6.420544520634614100, 0.4241136952774812700 ) ) ; #3374 = PRESENTATION_LAYER_ASSIGNMENT ( '', '', ( #3375 ) ) ; #3375 = STYLED_ITEM ( 'NONE', ( #3376 ), #5706 ) ; #3376 = PRESENTATION_STYLE_ASSIGNMENT (( #3377 ) ) ; #3377 = SURFACE_STYLE_USAGE ( .BOTH. , #3378 ) ; #3378 = SURFACE_SIDE_STYLE ('',( #3379 ) ) ; #3379 = SURFACE_STYLE_FILL_AREA ( #3380 ) ; #3380 = FILL_AREA_STYLE ('',( #3387 ) ) ; #3381 = COLOUR_RGB ( '',0.7960784313725489700, 0.8235294117647058400, 0.9372549019607843100 ) ; #3382 = FACE_OUTER_BOUND ( 'NONE', #5711, .T. ) ; #3383 = DIRECTION ( 'NONE', ( 0.0000000000000000000, 0.0000000000000000000, 1.000000000000000000 ) ) ; #3384 = DIRECTION ( 'NONE', ( -2.775557561562890900E-016, 1.000000000000000000, 5.993114065094845700E-017 ) ) ; #3385 = CARTESIAN_POINT ( 'NONE', ( 4.755682153449351200, 1.442144520634612800, -0.3886863047225187500 ) ) ; #3386 = AXIS2_PLACEMENT_3D ( 'NONE', #3385, #3384, #3383 ) ; #3387 = FILL_AREA_STYLE_COLOUR ( '', #3381 ) ; #3388 = CARTESIAN_POINT ( 'NONE', ( 5.543082153449351100, 1.442144520634612800, -0.3886863047225189700 ) ) ; #3389 =( NAMED_UNIT ( * ) SI_UNIT ( $, .STERADIAN. ) SOLID_ANGLE_UNIT ( ) ); #3390 = SURFACE_SIDE_STYLE ('',( #3391 ) ) ; #3391 = SURFACE_STYLE_FILL_AREA ( #3392 ) ; #3392 = FILL_AREA_STYLE ('',( #3416 ) ) ; #3393 = COLOUR_RGB ( '',0.7960784313725489700, 0.8235294117647058400, 0.9372549019607843100 ) ; #3394 = FACE_OUTER_BOUND ( 'NONE', #5720, .T. ) ; #3395 = DIRECTION ( 'NONE', ( 1.000000000000000000, 7.339205563297394700E-033, -1.785222994240793000E-016 ) ) ; #3396 = VECTOR ( 'NONE', #3395, 1000.000000000000000 ) ; #3397 = CARTESIAN_POINT ( 'NONE', ( 7.244882153449348800, 6.420544520634614100, 0.4241136952774810500 ) ) ; #3398 = PLANE ( 'NONE', #3414 ) ; #3399 = LINE ( 'NONE', #3421, #3420 ) ; #3400 =( LENGTH_UNIT ( ) NAMED_UNIT ( * ) SI_UNIT ( .MILLI., .METRE. ) ); #3401 = MECHANICAL_DESIGN_GEOMETRIC_PRESENTATION_REPRESENTATION ( '', ( #3403 ), #3410 ) ; #3402 = PRESENTATION_LAYER_ASSIGNMENT ( '', '', ( #3403 ) ) ; #3403 = STYLED_ITEM ( 'NONE', ( #3404 ), #5713 ) ; #3404 = PRESENTATION_STYLE_ASSIGNMENT (( #3405 ) ) ; #3405 = SURFACE_STYLE_USAGE ( .BOTH. , #3390 ) ; #3406 = UNCERTAINTY_MEASURE_WITH_UNIT (LENGTH_MEASURE( 1.000000000000000100E-005 ), #3326, 'distance_accuracy_value', 'NONE'); #3407 = UNCERTAINTY_MEASURE_WITH_UNIT (LENGTH_MEASURE( 1.000000000000000100E-005 ), #3400, 'distance_accuracy_value', 'NONE'); #3408 =( NAMED_UNIT ( * ) SI_UNIT ( $, .STERADIAN. ) SOLID_ANGLE_UNIT ( ) ); #3409 =( GEOMETRIC_REPRESENTATION_CONTEXT ( 3 ) GLOBAL_UNCERTAINTY_ASSIGNED_CONTEXT ( ( #3406 ) ) GLOBAL_UNIT_ASSIGNED_CONTEXT ( ( #3326, #3327, #3389 ) ) REPRESENTATION_CONTEXT ( 'NONE', 'WORKASPACE' ) ); #3410 =( GEOMETRIC_REPRESENTATION_CONTEXT ( 3 ) GLOBAL_UNCERTAINTY_ASSIGNED_CONTEXT ( ( #3407 ) ) GLOBAL_UNIT_ASSIGNED_CONTEXT ( ( #3400, #3411, #3408 ) ) REPRESENTATION_CONTEXT ( 'NONE', 'WORKASPACE' ) ); #3411 =( NAMED_UNIT ( * ) PLANE_ANGLE_UNIT ( ) SI_UNIT ( $, .RADIAN. ) ); #3412 = CARTESIAN_POINT ( 'NONE', ( 3.968282153449350400, 1.442144520634612800, -0.3886863047225185300 ) ) ; #3413 = DIRECTION ( 'NONE', ( 5.773722060964636400E-018, 1.621377732827185500E-016, -1.000000000000000000 ) ) ; #3414 = AXIS2_PLACEMENT_3D ( 'NONE', #3418, #3417, #3413 ) ; #3415 = LINE ( 'NONE', #3397, #3396 ) ; #3416 = FILL_AREA_STYLE_COLOUR ( '', #3393 ) ; #3417 = DIRECTION ( 'NONE', ( -2.775557561562890900E-016, 1.000000000000000000, 1.621377732827185500E-016 ) ) ; #3418 = CARTESIAN_POINT ( 'NONE', ( -4.188317846550649600, -0.1326554793653906500, -0.08388630472251959500 ) ) ; #3419 = DIRECTION ( 'NONE', ( -2.775557561562890900E-016, 1.000000000000000000, 2.444382198915688000E-017 ) ) ; #3420 = VECTOR ( 'NONE', #3419, 1000.000000000000000 ) ; #3421 = CARTESIAN_POINT ( 'NONE', ( -3.832717846550651500, 6.420544520634610600, -0.08388630472251949700 ) ) ; #3422 = DIRECTION ( 'NONE', ( 0.0000000000000000000, 0.0000000000000000000, 1.000000000000000000 ) ) ; #3423 = DIRECTION ( 'NONE', ( 2.775557561562890900E-016, -1.000000000000000000, -1.621377732827185800E-016 ) ) ; #3424 = AXIS2_PLACEMENT_3D ( 'NONE', #3426, #3423, #3422 ) ; #3425 = UNCERTAINTY_MEASURE_WITH_UNIT (LENGTH_MEASURE( 1.000000000000000100E-005 ), #3448, 'distance_accuracy_value', 'NONE'); #3426 = CARTESIAN_POINT ( 'NONE', ( -3.350117846550651400, 6.420544520634610600, -0.3886863047225185300 ) ) ; #3427 = CYLINDRICAL_SURFACE ( 'NONE', #3424, 0.7873999999999999900 ) ; #3428 = DIRECTION ( 'NONE', ( 2.775557561562890900E-016, -1.000000000000000000, -1.621377732827185800E-016 ) ) ; #3429 = VECTOR ( 'NONE', #3428, 1000.000000000000000 ) ; #3430 = CARTESIAN_POINT ( 'NONE', ( -3.832717846550651500, 6.420544520634610600, -0.3886863047225185300 ) ) ; #3431 = LINE ( 'NONE', #3430, #3429 ) ; #3432 = CIRCLE ( 'NONE', #3494, 0.4826000000000001400 ) ; #3433 = SURFACE_STYLE_USAGE ( .BOTH. , #3437 ) ; #3434 = COLOUR_RGB ( '',0.7960784313725489700, 0.8235294117647058400, 0.9372549019607843100 ) ; #3435 = PRESENTATION_LAYER_ASSIGNMENT ( '', '', ( #3509 ) ) ; #3436 = SURFACE_STYLE_FILL_AREA ( #3467 ) ; #3437 = SURFACE_SIDE_STYLE ('',( #3436 ) ) ; #3438 = DIRECTION ( 'NONE', ( 0.0000000000000000000, -2.753879025871232800E-016, 1.000000000000000000 ) ) ; #3439 = DIRECTION ( 'NONE', ( -2.775557561562890900E-016, 1.000000000000000000, 1.621377732827185800E-016 ) ) ; #3440 = CARTESIAN_POINT ( 'NONE', ( -3.350117846550650000, 1.442144520634609500, -0.3886863047225194200 ) ) ; #3441 = AXIS2_PLACEMENT_3D ( 'NONE', #3440, #3439, #3438 ) ; #3442 =( GEOMETRIC_REPRESENTATION_CONTEXT ( 3 ) GLOBAL_UNCERTAINTY_ASSIGNED_CONTEXT ( ( #3519 ) ) GLOBAL_UNIT_ASSIGNED_CONTEXT ( ( #3443, #3501, #3514 ) ) REPRESENTATION_CONTEXT ( 'NONE', 'WORKASPACE' ) ); #3443 =( LENGTH_UNIT ( ) NAMED_UNIT ( * ) SI_UNIT ( .MILLI., .METRE. ) ); #3444 = CARTESIAN_POINT ( 'NONE', ( -3.832717846550649700, -0.1326554793653902400, -1.455486304722519900 ) ) ; #3445 = CARTESIAN_POINT ( 'NONE', ( -2.867517846550651700, 6.420544520634610600, -0.3886863047225185300 ) ) ; #3446 = CARTESIAN_POINT ( 'NONE', ( -2.562717846550649700, 1.442144520634609500, -0.3886863047225196400 ) ) ; #3447 = FILL_AREA_STYLE_COLOUR ( '', #3434 ) ; #3448 =( LENGTH_UNIT ( ) NAMED_UNIT ( * ) SI_UNIT ( .MILLI., .METRE. ) ); #3449 = MECHANICAL_DESIGN_GEOMETRIC_PRESENTATION_REPRESENTATION ( '', ( #3451 ), #3538 ) ; #3450 = PRESENTATION_LAYER_ASSIGNMENT ( '', '', ( #3451 ) ) ; #3451 = STYLED_ITEM ( 'NONE', ( #3452 ), #5754 ) ; #3452 = PRESENTATION_STYLE_ASSIGNMENT (( #3461 ) ) ; #3453 = PRESENTATION_STYLE_ASSIGNMENT (( #3433 ) ) ; #3454 = CIRCLE ( 'NONE', #3441, 0.7873999999999999900 ) ; #3455 = DIRECTION ( 'NONE', ( 2.775557561562890900E-016, -1.000000000000000000, -1.621377732827185800E-016 ) ) ; #3456 = VECTOR ( 'NONE', #3455, 1000.000000000000000 ) ; #3457 = CARTESIAN_POINT ( 'NONE', ( -4.137517846550650800, 6.420544520634610600, -0.3886863047225185300 ) ) ; #3458 = LINE ( 'NONE', #3457, #3456 ) ; #3459 = COLOUR_RGB ( '',0.7960784313725489700, 0.8235294117647058400, 0.9372549019607843100 ) ; #3460 = FACE_OUTER_BOUND ( 'NONE', #5752, .T. ) ; #3461 = SURFACE_STYLE_USAGE ( .BOTH. , #3462 ) ; #3462 = SURFACE_SIDE_STYLE ('',( #3463 ) ) ; #3463 = SURFACE_STYLE_FILL_AREA ( #3464 ) ; #3464 = FILL_AREA_STYLE ('',( #3472 ) ) ; #3465 = DIRECTION ( 'NONE', ( -1.000000000000000000, -1.153478517290588000E-031, 7.056450262891038800E-016 ) ) ; #3466 = VECTOR ( 'NONE', #3465, 1000.000000000000000 ) ; #3467 = FILL_AREA_STYLE ('',( #3447 ) ) ; #3468 = CARTESIAN_POINT ( 'NONE', ( -2.562717846550651500, 6.420544520634610600, -0.3886863047225187500 ) ) ; #3469 = DIRECTION ( 'NONE', ( 1.000000000000000000, 0.0000000000000000000, 5.773722060964641000E-018 ) ) ; #3470 = CARTESIAN_POINT ( 'NONE', ( -2.562717846550651500, 6.420544520634610600, -0.3886863047225187500 ) ) ; #3471 = LINE ( 'NONE', #3470, #3466 ) ; #3472 = FILL_AREA_STYLE_COLOUR ( '', #3459 ) ; #3473 = DIRECTION ( 'NONE', ( 2.775557561562890900E-016, -1.000000000000000000, -1.621377732827185800E-016 ) ) ; #3474 = VECTOR ( 'NONE', #3473, 1000.000000000000000 ) ; #3475 = DIRECTION ( 'NONE', ( 0.0000000000000000000, 0.0000000000000000000, 1.000000000000000000 ) ) ; #3476 = DIRECTION ( 'NONE', ( -2.775557561562890900E-016, 1.000000000000000000, 1.621377732827185800E-016 ) ) ; #3477 = CARTESIAN_POINT ( 'NONE', ( -3.350117846550651400, 6.420544520634610600, -0.3886863047225185300 ) ) ; #3478 = AXIS2_PLACEMENT_3D ( 'NONE', #3477, #3476, #3475 ) ; #3479 = CARTESIAN_POINT ( 'NONE', ( -3.832717846550650200, 1.442144520634609500, -0.3886863047225194200 ) ) ; #3480 = CARTESIAN_POINT ( 'NONE', ( -3.832717846550650200, 1.442144520634609500, -0.08388630472251959500 ) ) ; #3481 = CARTESIAN_POINT ( 'NONE', ( -4.137517846550649000, -0.1326554793653904600, -1.455486304722519900 ) ) ; #3482 = CARTESIAN_POINT ( 'NONE', ( -2.867517846550651700, 6.420544520634610600, -0.3886863047225185300 ) ) ; #3483 = LINE ( 'NONE', #3513, #3515 ) ; #3484 = MECHANICAL_DESIGN_GEOMETRIC_PRESENTATION_REPRESENTATION ( '', ( #3509 ), #3442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
62891038800E-016 ) ) ; #3538 =( GEOMETRIC_REPRESENTATION_CONTEXT ( 3 ) GLOBAL_UNCERTAINTY_ASSIGNED_CONTEXT ( ( #3425 ) ) GLOBAL_UNIT_ASSIGNED_CONTEXT ( ( #3448, #3500, #3499 ) ) REPRESENTATION_CONTEXT ( 'NONE', 'WORKASPACE' ) ); #3539 = AXIS2_PLACEMENT_3D ( 'NONE', #3540, #3523, #3537 ) ; #3540 = CARTESIAN_POINT ( 'NONE', ( -2.562717846550651500, 6.420544520634610600, -0.3886863047225187500 ) ) ; #3541 = SURFACE_STYLE_FILL_AREA ( #3552 ) ; #3542 = FILL_AREA_STYLE_COLOUR ( '', #3545 ) ; #3543 =( NAMED_UNIT ( * ) PLANE_ANGLE_UNIT ( ) SI_UNIT ( $, .RADIAN. ) ); #3544 = STYLED_ITEM ( 'NONE', ( #3554 ), #5767 ) ; #3545 = COLOUR_RGB ( '',0.7960784313725489700, 0.8235294117647058400, 0.9372549019607843100 ) ; #3546 =( LENGTH_UNIT ( ) NAMED_UNIT ( * ) SI_UNIT ( .MILLI., .METRE. ) ); #3547 =( GEOMETRIC_REPRESENTATION_CONTEXT ( 3 ) GLOBAL_UNCERTAINTY_ASSIGNED_CONTEXT ( ( #3551 ) ) GLOBAL_UNIT_ASSIGNED_CONTEXT ( ( #3546, #3550, #3556 ) ) REPRESENTATION_CONTEXT ( 'NONE', 'WORKASPACE' ) ); #3548 = MECHANICAL_DESIGN_GEOMETRIC_PRESENTATION_REPRESENTATION ( '', ( #3544 ), #3547 ) ; #3549 = PRESENTATION_LAYER_ASSIGNMENT ( '', '', ( #3544 ) ) ; #3550 =( NAMED_UNIT ( * ) PLANE_ANGLE_UNIT ( ) SI_UNIT ( $, .RADIAN. ) ); #3551 = UNCERTAINTY_MEASURE_WITH_UNIT (LENGTH_MEASURE( 1.000000000000000100E-005 ), #3546, 'distance_accuracy_value', 'NONE'); #3552 = FILL_AREA_STYLE ('',( #3542 ) ) ; #3553 = SURFACE_STYLE_USAGE ( .BOTH. , #3555 ) ; #3554 = PRESENTATION_STYLE_ASSIGNMENT (( #3553 ) ) ; #3555 = SURFACE_SIDE_STYLE ('',( #3541 ) ) ; #3556 =( NAMED_UNIT ( * ) SI_UNIT ( $, .STERADIAN. ) SOLID_ANGLE_UNIT ( ) ); #3557 = DIRECTION ( 'NONE', ( 1.000000000000000000, 0.0000000000000000000, 5.773722060964641000E-018 ) ) ; #3558 = VECTOR ( 'NONE', #3557, 1000.000000000000000 ) ; #3559 = PRESENTATION_STYLE_ASSIGNMENT (( #3560 ) ) ; #3560 = SURFACE_STYLE_USAGE ( .BOTH. , #3561 ) ; #3561 = SURFACE_SIDE_STYLE ('',( #3562 ) ) ; #3562 = SURFACE_STYLE_FILL_AREA ( #3563 ) ; #3563 = FILL_AREA_STYLE ('',( #3603 ) ) ; #3564 = COLOUR_RGB ( '',0.7960784313725489700, 0.8235294117647058400, 0.9372549019607843100 ) ; #3565 = VECTOR ( 'NONE', #3595, 1000.000000000000000 ) ; #3566 = CARTESIAN_POINT ( 'NONE', ( -3.832717846550648400, -4.755455479365391400, -1.455486304722520400 ) ) ; #3567 = LINE ( 'NONE', #3566, #3565 ) ; #3568 =( LENGTH_UNIT ( ) NAMED_UNIT ( * ) SI_UNIT ( .MILLI., .METRE. ) ); #3569 = MECHANICAL_DESIGN_GEOMETRIC_PRESENTATION_REPRESENTATION ( '', ( #3581 ), #3579 ) ; #3570 = VECTOR ( 'NONE', #3573, 1000.000000000000000 ) ; #3571 = CARTESIAN_POINT ( 'NONE', ( -4.137517846550648100, -4.374455479365391100, -1.455486304722520400 ) ) ; #3572 = DIRECTION ( 'NONE', ( 5.773722060964641000E-018, 1.621377732827185500E-016, -1.000000000000000000 ) ) ; #3573 = DIRECTION ( 'NONE', ( -1.000000000000000000, 0.0000000000000000000, -5.773722060964641000E-018 ) ) ; #3574 = CARTESIAN_POINT ( 'NONE', ( -3.832717846550648400, -4.755455479365391400, -1.455486304722520400 ) ) ; #3575 = LINE ( 'NONE', #3597, #3596 ) ; #3576 =( NAMED_UNIT ( * ) SI_UNIT ( $, .STERADIAN. ) SOLID_ANGLE_UNIT ( ) ); #3577 = CARTESIAN_POINT ( 'NONE', ( -3.832717846550648400, -4.755455479365391400, -1.074486304722519500 ) ) ; #3578 = LINE ( 'NONE', #3577, #3558 ) ; #3579 =( GEOMETRIC_REPRESENTATION_CONTEXT ( 3 ) GLOBAL_UNCERTAINTY_ASSIGNED_CONTEXT ( ( #3611 ) ) GLOBAL_UNIT_ASSIGNED_CONTEXT ( ( #3568, #3592, #3576 ) ) REPRESENTATION_CONTEXT ( 'NONE', 'WORKASPACE' ) ); #3580 = PRESENTATION_LAYER_ASSIGNMENT ( '', '', ( #3581 ) ) ; #3581 = STYLED_ITEM ( 'NONE', ( #3582 ), #5778 ) ; #3582 = PRESENTATION_STYLE_ASSIGNMENT (( #3607 ) ) ; #3583 =( LENGTH_UNIT ( ) NAMED_UNIT ( * ) SI_UNIT ( .MILLI., .METRE. ) ); #3584 = MECHANICAL_DESIGN_GEOMETRIC_PRESENTATION_REPRESENTATION ( '', ( #3586 ), #3630 ) ; #3585 = PRESENTATION_LAYER_ASSIGNMENT ( '', '', ( #3586 ) ) ; #3586 = STYLED_ITEM ( 'NONE', ( #3559 ), #5782 ) ; #3587 = CARTESIAN_POINT ( 'NONE', ( -3.350117846550651400, 6.420544520634610600, -0.3886863047225185300 ) ) ; #3588 = AXIS2_PLACEMENT_3D ( 'NONE', #3574, #3572, #3589 ) ; #3589 = DIRECTION ( 'NONE', ( -1.000000000000000000, 0.0000000000000000000, -5.773722060964641000E-018 ) ) ; #3590 = AXIS2_PLACEMENT_3D ( 'NONE', #3587, #3601, #3600 ) ; #3591 = CYLINDRICAL_SURFACE ( 'NONE', #3590, 0.4825999999999999700 ) ; #3592 =( NAMED_UNIT ( * ) PLANE_ANGLE_UNIT ( ) SI_UNIT ( $, .RADIAN. ) ); #3593 = COLOUR_RGB ( '',0.7960784313725489700, 0.8235294117647058400, 0.9372549019607843100 ) ; #3594 = FACE_OUTER_BOUND ( 'NONE', #5727, .T. ) ; #3595 = DIRECTION ( 'NONE', ( -2.775557561562890900E-016, 1.000000000000000000, 1.621377732827185800E-016 ) ) ; #3596 = VECTOR ( 'NONE', #3606, 1000.000000000000000 ) ; #3597 = CARTESIAN_POINT ( 'NONE', ( -4.137517846550648100, -4.755455479365391400, -0.4648863047225214000 ) ) ; #3598 = CARTESIAN_POINT ( 'NONE', ( -3.832717846550648400, -4.374455479365389400, -0.08388630472252024700 ) ) ; #3599 = FILL_AREA_STYLE_COLOUR ( '', #3593 ) ; #3600 = DIRECTION ( 'NONE', ( 0.0000000000000000000, 0.0000000000000000000, 1.000000000000000000 ) ) ; #3601 = DIRECTION ( 'NONE', ( 2.775557561562890900E-016, -1.000000000000000000, -1.621377732827185800E-016 ) ) ; #3602 = FACE_OUTER_BOUND ( 'NONE', #5783, .T. ) ; #3603 = FILL_AREA_STYLE_COLOUR ( '', #3564 ) ; #3604 = LINE ( 'NONE', #3571, #3570 ) ; #3605 = PLANE ( 'NONE', #3588 ) ; #3606 = DIRECTION ( 'NONE', ( -1.000000000000000000, 0.0000000000000000000, -5.773722060964641000E-018 ) ) ; #3607 = SURFACE_STYLE_USAGE ( .BOTH. , #3608 ) ; #3608 = SURFACE_SIDE_STYLE ('',( #3609 ) ) ; #3609 = SURFACE_STYLE_FILL_AREA ( #3610 ) ; #3610 = FILL_AREA_STYLE ('',( #3599 ) ) ; #3611 = UNCERTAINTY_MEASURE_WITH_UNIT (LENGTH_MEASURE( 1.000000000000000100E-005 ), #3568, 'distance_accuracy_value', 'NONE'); #3612 = LINE ( 'NONE', #3622, #3621 ) ; #3613 = CARTESIAN_POINT ( 'NONE', ( -3.832717846550648400, -4.755455479365391400, -1.074486304722518200 ) ) ; #3614 = DIRECTION ( 'NONE', ( 1.921789193134769600E-016, -0.7071067811865461300, 0.7071067811865489100 ) ) ; #3615 = UNCERTAINTY_MEASURE_WITH_UNIT (LENGTH_MEASURE( 1.000000000000000100E-005 ), #3583, 'distance_accuracy_value', 'NONE'); #3616 = CARTESIAN_POINT ( 'NONE', ( -4.137517846550648100, -4.755455479365391400, -0.4648863047225214000 ) ) ; #3617 = DIRECTION ( 'NONE', ( -2.003441953574658900E-016, 0.7071067811865459100, 0.7071067811865491300 ) ) ; #3618 = VECTOR ( 'NONE', #3617, 1000.000000000000100 ) ; #3619 = CARTESIAN_POINT ( 'NONE', ( -4.137517846550648100, -4.374455479365391100, -0.08388630472252013600 ) ) ; #3620 = DIRECTION ( 'NONE', ( 1.000000000000000000, 0.0000000000000000000, 5.773722060964641000E-018 ) ) ; #3621 = VECTOR ( 'NONE', #3620, 1000.000000000000000 ) ; #3622 = CARTESIAN_POINT ( 'NONE', ( -4.188317846550649600, -0.1326554793653906500, -0.08388630472251959500 ) ) ; #3623 = LINE ( 'NONE', #3619, #3618 ) ; #3624 = DIRECTION ( 'NONE', ( -2.775557561562890900E-016, 1.000000000000000000, 5.993114065094845700E-017 ) ) ; #3625 = DIRECTION ( 'NONE', ( -2.775557561562890900E-016, 1.000000000000000000, 2.444382198915688000E-017 ) ) ; #3626 = VECTOR ( 'NONE', #3625, 1000.000000000000000 ) ; #3627 = CARTESIAN_POINT ( 'NONE', ( -4.137517846550650800, 6.420544520634610600, -0.08388630472251949700 ) ) ; #3628 = LINE ( 'NONE', #3627, #3626 ) ; #3629 = PLANE ( 'NONE', #3633 ) ; #3630 =( GEOMETRIC_REPRESENTATION_CONTEXT ( 3 ) GLOBAL_UNCERTAINTY_ASSIGNED_CONTEXT ( ( #3615 ) ) GLOBAL_UNIT_ASSIGNED_CONTEXT ( ( #3583, #3543, #3634 ) ) REPRESENTATION_CONTEX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
TYLE_USAGE ( .BOTH. , #3759 ) ; #3759 = SURFACE_SIDE_STYLE ('',( #3760 ) ) ; #3760 = SURFACE_STYLE_FILL_AREA ( #3741 ) ; #3761 =( LENGTH_UNIT ( ) NAMED_UNIT ( * ) SI_UNIT ( .MILLI., .METRE. ) ); #3762 = CARTESIAN_POINT ( 'NONE', ( 6.355882153449347700, 6.420544520634614100, -0.3886863047225174700 ) 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
UND ( 'NONE', #6036, .T. ) ; #4486 = CARTESIAN_POINT ( 'NONE', ( 3.968282153449351300, -1.580455479365387300, 0.04311369527748110100 ) ) ; #4487 = FILL_AREA_STYLE ('',( #4488 ) ) ; #4488 = FILL_AREA_STYLE_COLOUR ( '', #4448 ) ; #4489 =( NAMED_UNIT ( * ) SI_UNIT ( $, .STERADIAN. ) SOLID_ANGLE_UNIT ( ) ); #4490 = CARTESIAN_POINT ( 'NONE', ( 4.273082153449351500, -1.580455479365387300, -0.08388630472251905300 ) ) ; #4491 = DIRECTION ( 'NONE', ( 2.775557561562890900E-016, -1.000000000000000000, 7.666125903226468000E-017 ) ) ; #4492 = VECTOR ( 'NONE', #4491, 1000.000000000000000 ) ; #4493 = DIRECTION ( 'NONE', ( -1.566199745268830900E-016, 0.7071067811865460200, 0.7071067811865490200 ) ) ; #4494 = VECTOR ( 'NONE', #4493, 1000.000000000000100 ) ; #4495 = CARTESIAN_POINT ( 'NONE', ( 3.968282153449352200, -4.374455479365387600, -0.08388630472251873400 ) ) ; #4496 = LINE ( 'NONE', #4495, #4494 ) ; #4497 = PRESENTATION_LAYER_ASSIGNMENT ( '', '', ( #4498 ) ) ; #4498 = STYLED_ITEM ( 'NONE', ( #4454 ), #6053 ) ; #4499 =( GEOMETRIC_REPRESENTATION_CONTEXT ( 3 ) GLOBAL_UNCERTAINTY_ASSIGNED_CONTEXT ( ( #4466 ) ) GLOBAL_UNIT_ASSIGNED_CONTEXT ( ( #4504, #4511, #4489 ) ) REPRESENTATION_CONTEXT ( 'NONE', 'WORKASPACE' ) ); #4500 = LINE ( 'NONE', #4477, #4505 ) ; #4501 = CARTESIAN_POINT ( 'NONE', ( 3.968282153449352200, -4.374455479365387600, -1.455486304722519300 ) ) ; #4502 = PLANE ( 'NONE', #4515 ) ; #4503 = DIRECTION ( 'NONE', ( -5.606166404184162000E-017, 5.993114065094840700E-017, -1.000000000000000000 ) ) ; #4504 =( LENGTH_UNIT ( ) NAMED_UNIT ( * ) SI_UNIT ( .MILLI., .METRE. ) ); #4505 = VECTOR ( 'NONE', #4503, 1000.000000000000000 ) ; #4506 = CARTESIAN_POINT ( 'NONE', ( 4.273082153449352400, -4.374455479365385800, -0.08388630472251884500 ) ) ; #4507 = DIRECTION ( 'NONE', ( -5.606166404184162000E-017, 5.993114065094840700E-017, -1.000000000000000000 ) ) ; #4508 = VECTOR ( 'NONE', #4507, 1000.000000000000000 ) ; #4509 = CARTESIAN_POINT ( 'NONE', ( 4.273082153449352400, -4.755455479365387800, 0.04311369527748099000 ) ) ; #4510 = LINE ( 'NONE', #4509, #4508 ) ; #4511 =( NAMED_UNIT ( * ) PLANE_ANGLE_UNIT ( ) SI_UNIT ( $, .RADIAN. ) ); #4512 = DIRECTION ( 'NONE', ( -5.606166404184162000E-017, 5.993114065094840700E-017, -1.000000000000000000 ) ) ; #4513 = DIRECTION ( 'NONE', ( 1.000000000000000000, 6.842277657836020900E-049, -5.606166404184162000E-017 ) ) ; #4514 = CARTESIAN_POINT ( 'NONE', ( 4.273082153449348800, 6.420544520634614100, 0.04311369527748164200 ) ) ; #4515 = AXIS2_PLACEMENT_3D ( 'NONE', #4514, #4513, #4512 ) ; #4516 = UNCERTAINTY_MEASURE_WITH_UNIT (LENGTH_MEASURE( 1.000000000000000100E-005 ), #4459, 'distance_accuracy_value', 'NONE'); #4517 =( NAMED_UNIT ( * ) SI_UNIT ( $, .STERADIAN. ) SOLID_ANGLE_UNIT ( ) ); #4518 =( GEOMETRIC_REPRESENTATION_CONTEXT ( 3 ) GLOBAL_UNCERTAINTY_ASSIGNED_CONTEXT ( ( #4516 ) ) GLOBAL_UNIT_ASSIGNED_CONTEXT ( ( #4459, #4458, #4517 ) ) REPRESENTATION_CONTEXT ( 'NONE', 'WORKASPACE' ) ); #4519 = AXIS2_PLACEMENT_3D ( 'NONE', #4551, #4554, #4538 ) ; #4520 = CARTESIAN_POINT ( 'NONE', ( 4.273082153449352400, -4.755455479365387800, -0.4648863047225200700 ) ) ; #4521 =( LENGTH_UNIT ( ) NAMED_UNIT ( * ) SI_UNIT ( .MILLI., .METRE. ) ); #4522 = DIRECTION ( 'NONE', ( 1.566199745268830900E-016, -0.7071067811865460200, -0.7071067811865490200 ) ) ; #4523 = VECTOR ( 'NONE', #4522, 1000.000000000000100 ) ; #4524 = CARTESIAN_POINT ( 'NONE', ( 4.273082153449351500, 1.086544520634589000, 5.377113695277480500 ) ) ; #4525 = LINE ( 'NONE', #4524, #4523 ) ; #4526 =( NAMED_UNIT ( * ) SI_UNIT ( $, .STERADIAN. ) SOLID_ANGLE_UNIT ( ) ); #4527 =( NAMED_UNIT ( * ) PLANE_ANGLE_UNIT ( ) SI_UNIT ( $, .RADIAN. ) ); #4528 = VECTOR ( 'NONE', #4529, 1000.000000000000000 ) ; #4529 = DIRECTION ( 'NONE', ( -1.000000000000000000, 0.0000000000000000000, 5.606166404184160800E-017 ) ) ; #4530 = CARTESIAN_POINT ( 'NONE', ( 3.968282153449352200, -4.755455479365387800, -0.4648863047225198500 ) ) ; #4531 = LINE ( 'NONE', #4530, #4528 ) ; #4532 = PLANE ( 'NONE', #4519 ) ; #4533 = CARTESIAN_POINT ( 'NONE', ( 3.968282153449352200, -4.374455479365387600, -0.08388630472251851200 ) ) ; #4534 = SHELL_BASED_SURFACE_MODEL ( 'NONE', ( #5208, #5456, #5544 ) ); #4535 = MANIFOLD_SURFACE_SHAPE_REPRESENTATION ( '3544-2', ( #4534, #4555 ), #4536 ) ; #4536 =( GEOMETRIC_REPRESENTATION_CONTEXT ( 3 ) GLOBAL_UNCERTAINTY_ASSIGNED_CONTEXT ( ( #4537 ) ) GLOBAL_UNIT_ASSIGNED_CONTEXT ( ( #4521, #4527, #4526 ) ) REPRESENTATION_CONTEXT ( 'NONE', 'WORKASPACE' ) ); #4537 = UNCERTAINTY_MEASURE_WITH_UNIT (LENGTH_MEASURE( 1.000000000000000100E-005 ), #4521, 'distance_accuracy_value', 'NONE'); #4538 = DIRECTION ( 'NONE', ( -1.566199745268830900E-016, 0.7071067811865460200, 0.7071067811865490200 ) ) ; #4539 = CARTESIAN_POINT ( 'NONE', ( 3.968282153449352200, -4.755455479365387800, -0.4648863047225198500 ) ) ; #4540 = STYLED_ITEM ( 'NONE', ( #4541 ), #4535 ) ; #4541 = PRESENTATION_STYLE_ASSIGNMENT (( #4542 ) ) ; #4542 = SURFACE_STYLE_USAGE ( .BOTH. , #4543 ) ; #4543 = SURFACE_SIDE_STYLE ('',( #4544 ) ) ; #4544 = SURFACE_STYLE_FILL_AREA ( #4545 ) ; #4545 = FILL_AREA_STYLE ('',( #4546 ) ) ; #4546 = FILL_AREA_STYLE_COLOUR ( '', #4547 ) ; #4547 = COLOUR_RGB ( '',0.7960784313725489700, 0.8235294117647058400, 0.9372549019607843100 ) ; #4548 = PRODUCT_DEFINITION_FORMATION_WITH_SPECIFIED_SOURCE ( 'ANY', '', #4566, .NOT_KNOWN. ) ; #4549 = PRODUCT_DEFINITION ( 'UNKNOWN', '', #4548, #4550 ) ; #4550 = PRODUCT_DEFINITION_CONTEXT ( 'detailed design', #4553, 'design' ) ; #4551 = CARTESIAN_POINT ( 'NONE', ( 3.917482153449352000, -4.374455479365387600, -0.08388630472251873400 ) ) ; #4552 = APPLICATION_PROTOCOL_DEFINITION ( 'draft international standard', 'automotive_design', 1998, #4553 ) ; #4553 = APPLICATION_CONTEXT ( 'automotive_design' ) ; #4554 = DIRECTION ( 'NONE', ( 2.359031401440604700E-016, -0.7071067811865490200, 0.7071067811865460200 ) ) ; #4555 = AXIS2_PLACEMENT_3D ( 'NONE', #4560, #4559, #4562 ) ; #4556 = UNCERTAINTY_MEASURE_WITH_UNIT (LENGTH_MEASURE( 1.000000000000000100E-005 ), #4565, 'distance_accuracy_value', 'NONE'); #4557 = APPLICATION_CONTEXT ( 'automotive_design' ) ; #4558 = PRESENTATION_LAYER_ASSIGNMENT ( '', '', ( #4540 ) ) ; #4559 = DIRECTION ( 'NONE', ( 0.0000000000000000000, 0.0000000000000000000, 1.000000000000000000 ) ) ; #4560 = CARTESIAN_POINT ( 'NONE', ( 0.0000000000000000000, 0.0000000000000000000, 0.0000000000000000000 ) ) ; #4561 = MECHANICAL_DESIGN_GEOMETRIC_PRESENTATION_REPRESENTATION ( '', ( #4540 ), #4569 ) ; #4562 = DIRECTION ( 'NONE', ( 1.000000000000000000, 0.0000000000000000000, 0.0000000000000000000 ) ) ; #4563 =( NAMED_UNIT ( * ) PLANE_ANGLE_UNIT ( ) SI_UNIT ( $, .RADIAN. ) ); #4564 =( NAMED_UNIT ( * ) SI_UNIT ( $, .STERADIAN. ) SOLID_ANGLE_UNIT ( ) ); #4565 =( LENGTH_UNIT ( ) NAMED_UNIT ( * ) SI_UNIT ( .MILLI., .METRE. ) ); #4566 = PRODUCT ( '3544-2', '3544-2', '', ( #4567 ) ) ; #4567 = PRODUCT_CONTEXT ( 'NONE', #4557, 'mechanical' ) ; #4568 = APPLICATION_PROTOCOL_DEFINITION ( 'draft international standard', 'automotive_design', 1998, #4557 ) ; #4569 =( GEOMETRIC_REPRESENTATION_CONTEXT ( 3 ) GLOBAL_UNCERTAINTY_ASSIGNED_CONTEXT ( ( #4556 ) ) GLOBAL_UNIT_ASSIGNED_CONTEXT ( ( #4565, #4563, #4564 ) ) REPRESENTATION_CONTEXT ( 'NONE', 'WORKASPACE' ) ); #4570 = SHAPE_DEFINITION_REPRESENTATION ( #4573, #4535 ) ; #4571 = ORIENTED_EDGE ( 'NONE', *, *, #5492, .F. ) ; #4572 = PRODUCT_RELATED_PRODUCT_CATEGORY ( 'part', '', ( #4566 ) ) ; #4573 = PRODUCT_DEFINITION_SHAPE ( 'NONE', 'NONE', #4549 ) ; #4574 = ORIENTED_EDGE ( 'NONE', *, *, #5565, .F. ) ; #4575 = ORIENTED_EDGE ( 'NONE', *, *, #4577, .T. ) ; #4576 = ORIENTED_EDGE ( 'NONE', *, *, #5237, .F. ) ; #4577 = EDGE_CURVE ( 'NONE', #5880, #4578, #77, .T. ) ; #4578 = VERTEX_POINT ( 'NONE', #96 ) ; #4579 = ORIENTED_EDGE ( 'NONE', *, *, #5640, .F. ) ; #4580 = ORIENTED_EDGE ( 'NONE', *, *, #5591, .F. ) ; #4581 = ORIENTED_EDGE ( 'NONE', *, *, #5497, .T. ) ; #4582 = ORIENTED_EDGE ( 'NONE', *, *, #5667, .T. ) ; #4583 = ADVANCED_FACE ( 'NONE', ( #97 ), #120, .F. ) ; #4584 = ORIENTED_EDGE ( 'NONE', *, *, #5117, .F. ) ; #4585 = ORIENTED_EDGE ( 'NONE', *, *, #5480, .F. ) ; #4586 = ORIENTED_EDGE ( 'NONE', *, *, #5639, .T. ) ; #4587 = ORIENTED_EDGE ( 'NONE', *, *, #4588, .T. ) ; #4588 = EDGE_CURVE ( 'NONE', #4578, #5649, #114, .T. ) ; #4589 = VERTEX_POINT ( 'NONE', #115 ) ; #4590 = ORIENTED_EDGE ( 'NONE', *, *, #5650, .T. ) ; #4591 = ADVANCED_FACE ( 'NONE', ( #106 ), #123, .T. ) ; #4592 = EDGE_CURVE ( 'NONE', #5676, #5880, #131, .T. ) ; #4593 = EDGE_LOOP ( 'NONE', ( #4571, #5922, #5641, #4581, #2217 ) ) ; #4594 = ORIENTED_EDGE ( 'NONE', *, *, #5106, .T. ) ; #4595 = VERTEX_POINT ( 'NONE', #149 ) ; #4596 = ADVANCED_FACE ( 'NONE', ( #136 ), #165, .F. ) ; #4597 = ORIENTED_EDGE ( 'NONE', *, *, #4598, .T. ) ; #4598 = EDGE_CURVE ( 'NONE', #4595, #4599, #168, .T. ) ; #4599 = VERTEX_POINT ( 'NONE', #158 ) ; #4600 = ORIENTED_EDGE ( 'NONE', *, *, #5653, .T. ) ; #4601 = ORIENTED_EDGE ( 'NONE', *, *, #4615, .F. ) ; #4602 = ORIENTED_EDGE ( 'NONE', *, *, #5257, .T. ) ; #4603 = ADVANCED_FACE ( 'NONE', ( #170 ), #174, .F. ) ; #4604 = EDGE_CURVE ( 'NONE', #4611, #5690, #191, .T. ) ; #4605 = EDGE_CURVE ( 'NONE', #4606, #5837, #190, .T. ) ; #4606 = VERTEX_POINT ( 'NONE', #201 ) ; #4607 = ORIENTED_EDGE ( 'NONE', *, *, #4608, .T. ) ; #4608 = EDGE_CURVE ( 'NONE', #4606, #5840, #202, .T. ) ; #4609 = ADVANCED_FACE ( 'NONE', ( #184 ), #232, .T. ) ; #4610 = EDGE_LOOP ( 'NONE', ( #5707, #5709, #5700, #5701 ) ) ; #4611 = VERTEX_POINT ( 'NONE', #208 ) ; #4612 = EDGE_LOOP ( 'NONE', ( #4597, #4613, #5834, #4602 ) ) ; #4613 = ORIENTED_EDGE ( 'NONE', *, *, #4614, .T. ) ; #4614 = EDGE_CURVE ( 'NONE', #4599, #5613, #238, .T. ) ; #4615 = EDGE_CURVE ( 'NONE', #5116, #5206, #228, .T. ) ; #4616 = ORIENTED_EDGE ( 'NONE', *, *, #5110, .T. ) ; #4617 = EDGE_LOOP ( 'NONE', ( #5832, #4618, #5843, #5703 ) ) ; #4618 = ORIENTED_EDGE ( 'NONE', *, *, #5347, .T. ) ; #4619 = ORIENTED_EDGE ( 'NONE', *, *, #5830, .T. ) ; #4620 = VERTEX_POINT ( 'NONE', #216 ) ; #4621 = VERTEX_POINT ( 'NONE', #215 ) ; #4622 = VERTEX_POINT ( 'NONE', #214 ) ; #4623 = ADVANCED_FACE ( 'NONE', ( #213 ), #2444, .F. ) ; #4624 = ADVANCED_FACE ( 'NONE', ( #2459 ), #2420, .F. ) ; #4625 = ORIENTED_EDGE ( 'NONE', *, *, #4626, .T. ) ; #4626 = EDGE_CURVE ( 'NONE', #4805, #4806, #2419, .T. ) ; #4627 = EDGE_LOOP ( 'NONE', ( #4759, #4755, #4757, #4692 ) ) ; #4628 = EDGE_CURVE ( 'NONE', #4819, #4629, #2427, .T. ) ; #4629 = VERTEX_POINT ( 'NONE', #2458 ) ; #4630 = ORIENTED_EDGE ( 'NONE', *, *, #4628, .T. ) ; #4631 = ORIENTED_EDGE ( 'NONE', *, *, #4632, .F. ) ; #4632 = EDGE_CURVE ( 'NONE', #4629, #4776, #2466, .T. ) ; #4633 = ORIENTED_EDGE ( 'NONE', *, *, #4686, .T. ) ; #4634 = EDGE_CURVE ( 'NONE', #4589, #5016, #2450, .T. ) ; #4635 = ORIENTED_EDGE ( 'NONE', *, *, #5049, .F. ) ; #4636 = ORIENTED_EDGE ( 'NONE', *, *, #5018, .T. ) ; #4637 = EDGE_LOOP ( 'NONE', ( #4633, #4630, #4678, #4691 ) ) ; #4638 = EDGE_LOOP ( 'NONE', ( #4763, #4764, #4820, #4631 ) ) ; #4639 = ADVANCED_FACE ( 'NONE', ( #2475 ), #2197, .T. ) ; #4640 = ORIENTED_EDGE ( 'NONE', *, *, #4641, .F. ) ; #4641 = EDGE_CURVE ( 'NONE', #4779, #4690, #2201, .T. ) ; #4642 = ORIENTED_EDGE ( 'NONE', *, *, #4778, .T. ) ; #4643 = ORIENTED_EDGE ( 'NONE', *, *, #4644, .T. ) ; #4644 = EDGE_CURVE ( 'NONE', #4675, #4687, #2263, .T. ) ; #4645 = EDGE_CURVE ( 'NONE', #4794, #4808, #2258, .T. ) ; #4646 = ADVANCED_FACE ( 'NONE', ( #2244 ), #2206, .F. ) ; #4647 = EDGE_LOOP ( 'NONE', ( #4797, #4801, #4803, #4804 ) ) ; #4648 = ORIENTED_EDGE ( 'NONE', *, *, #4649, .T. ) ; #4649 = EDGE_CURVE ( 'NONE', #4751, #4650, #2267, .T. ) ; #4650 = VERTEX_POINT ( 'NONE', #2286 ) ; #4651 = ORIENTED_EDGE ( 'NONE', *, *, #4652, .T. ) ; #4652 = EDGE_CURVE ( 'NONE', #4650, #4708, #2272, .T. ) ; #4653 = ORIENTED_EDGE ( 'NONE', *, *, #4719, .T. ) ; #4654 = VERTEX_POINT ( 'NONE', #2264 ) ; #4655 = ORIENTED_EDGE ( 'NONE', *, *, #4656, .F. ) ; #4656 = EDGE_CURVE ( 'NONE', #4754, #4654, #2278, .T. ) ; #4657 = ADVANCED_FACE ( 'NONE', ( #2270 ), #2233, .F. ) ; #4658 = EDGE_LOOP ( 'NONE', ( #4748, #4749, #4648, #4651 ) ) ; #4659 = EDGE_CURVE ( 'NONE', #4684, #4800, #2307, .T. ) ; #4660 = ADVANCED_FACE ( 'NONE', ( #2321 ), #2322, .F. ) ; #4661 = EDGE_LOOP ( 'NONE', ( #4752, #4706, #4709, #4711, #4768, #4771, #4663, #4655 ) ) ; #4662 = VERTEX_POINT ( 'NONE', #2355 ) ; #4663 = ORIENTED_EDGE ( 'NONE', *, *, #4664, .F. ) ; #4664 = EDGE_CURVE ( 'NONE', #4654, #4773, #2354, .T. ) ; #4665 = VERTEX_POINT ( 'NONE', #2326 ) ; #4666 = ORIENTED_EDGE ( 'NONE', *, *, #4667, .F. ) ; #4667 = EDGE_CURVE ( 'NONE', #4668, #4787, #2311, .T. ) ; #4668 = VERTEX_POINT ( 'NONE', #2324 ) ; #4669 = ORIENTED_EDGE ( 'NONE', *, *, #4680, .T. ) ; #4670 = EDGE_CURVE ( 'NONE', #4671, #4672, #2323, .T. ) ; #4671 = VERTEX_POINT ( 'NONE', #2312 ) ; #4672 = VERTEX_POINT ( 'NONE', #2332 ) ; #4673 = ORIENTED_EDGE ( 'NONE', *, *, #4674, .T. ) ; #4674 = EDGE_CURVE ( 'NONE', #4672, #4675, #2331, .T. ) ; #4675 = VERTEX_POINT ( 'NONE', #2347 ) ; #4676 = ADVANCED_FACE ( 'NONE', ( #2346 ), #2240, .T. ) ; #4677 = ORIENTED_EDGE ( 'NONE', *, *, #4634, .F. ) ; #4678 = ORIENTED_EDGE ( 'NONE', *, *, #4817, .F. ) ; #4679 = EDGE_CURVE ( 'NONE', #4776, #4766, #2378, .T. ) ; #4680 = EDGE_CURVE ( 'NONE', #4668, #4681, #2364, .T. ) ; #4681 = VERTEX_POINT ( 'NONE', #2365 ) ; #4682 = ORIENTED_EDGE ( 'NONE', *, *, #4683, .T. ) ; #4683 = EDGE_CURVE ( 'NONE', #4681, #4790, #2362, .T. ) ; #4684 = VERTEX_POINT ( 'NONE', #2363 ) ; #4685 = ADVANCED_FACE ( 'NONE', ( #2376 ), #2236, .T. ) ; #4686 = EDGE_CURVE ( 'NONE', #5016, #4819, #2416, .T. ) ; #4687 = VERTEX_POINT ( 'NONE', #2391 ) ; #4688 = ORIENTED_EDGE ( 'NONE', *, *, #4689, .F. ) ; #4689 = EDGE_CURVE ( 'NONE', #4690, #4687, #2403, .T. ) ; #4690 = VERTEX_POINT ( 'NONE', #2404 ) ; #4691 = ORIENTED_EDGE ( 'NONE', *, *, #4634, .T. ) ; #4692 = ORIENTED_EDGE ( 'NONE', *, *, #4693, .T. ) ; #4693 = EDGE_CURVE ( 'NONE', #4819, #4761, #2397, .T. ) ; #4694 = ADVANCED_FACE ( 'NONE', ( #2398 ), #2289, .T. ) ; #4695 = ORIENTED_EDGE ( 'NONE', *, *, #4670, .T. ) ; #4696 = VERTEX_POINT ( 'NONE', #2502 ) ; #4697 = EDGE_CURVE ( 'NONE', #4735, #4726, #2509, .T. ) ; #4698 = ADVANCED_FACE ( 'NONE', ( #2498 ), #2484, .T. ) ; #4699 = EDGE_LOOP ( 'NONE', ( #4700, #4994, #5067, #5065, #5087, #5076, #5074, #5089 ) ) ; #4700 = ORIENTED_EDGE ( 'NONE', *, *, #4922, .T. ) ; #4701 = EDGE_LOOP ( 'NONE', ( #4728, #4741, #5060, #4732 ) ) ; #4702 = ORIENTED_EDGE ( 'NONE', *, *, #4875, .F. ) ; #4703 = VERTEX_POINT ( 'NONE', #2480 ) ; #4704 = EDGE_CURVE ( 'NONE', #4770, #4808, #2479, .T. ) ; #4705 = ORIENTED_EDGE ( 'NONE', *, *, #4724, .T. ) ; #4706 = ORIENTED_EDGE ( 'NONE', *, *, #4707, .T. ) ; #4707 = EDGE_CURVE ( 'NONE', #4662, #4708, #2492, .T. ) ; #4708 = VERTEX_POINT ( 'NONE', #2487 ) ; #4709 = ORIENTED_EDGE ( 'NONE', *, *, #4710, .T. ) ; #4710 = EDGE_CURVE ( 'NONE', #4708, #4799, #2287, .T. ) ; #4711 = ORIENTED_EDGE ( 'NONE', *, *, #4798, .T. ) ; #4712 = EDGE_LOOP ( 'NONE', ( #4774, #4795, #4653, #4718 ) ) ; #4713 = EDGE_LOOP ( 'NONE', ( #4625, #4807, #4717, #4742, #4746, #4848, #4740, #5061 ) ) ; #4714 = ORIENTED_EDGE ( 'NONE', *, *, #4715, .T. ) ; #4715 = EDGE_CURVE ( 'NONE', #4793, #4650, #2516, .T. ) ; #4716 = EDGE_CURVE ( 'NONE', #4806, #4681, #2515, .T. ) ; #4717 = ORIENTED_EDGE ( 'NONE', *, *, #4680, .F. ) ; #4718 = ORIENTED_EDGE ( 'NONE', *, *, #4645, .T. ) ; #4719 = EDGE_CURVE ( 'NONE', #4665, #4794, #2519, .T. ) ; #4720 = ADVANCED_FACE ( 'NONE', ( #2530 ), #2536, .F. ) ; #4721 = EDGE_LOOP ( 'NONE', ( #4722, #4723, #4786, #4666, #4669, #4682, #4791, #4714 ) ) ; #4722 = ORIENTED_EDGE ( 'NONE', *, *, #4649, .F. ) ; #4723 = ORIENTED_EDGE ( 'NONE', *, *, #4784, .F. ) ; #4724 = EDGE_CURVE ( 'NONE', #4726, #4621, #2550, .T. ) ; #4725 = EDGE_CURVE ( 'NONE', #4730, #4810, #2545, .T. ) ; #4726 = VERTEX_POINT ( 'NONE', #2549 ) ; #4727 = EDGE_CURVE ( 'NONE', #4810, #4882, #2541, .T. ) ; #4728 = ORIENTED_EDGE ( 'NONE', *, *, #4831, .T. ) ; #4729 = VERTEX_POINT ( 'NONE', #2551 ) ; #4730 = VERTEX_POINT ( 'NONE', #2566 ) ; #4731 = ORIENTED_EDGE ( 'NONE', *, *, #4727, .T. ) ; #4732 = ORIENTED_EDGE ( 'NONE', *, *, #4733, .T. ) ; #4733 = EDGE_CURVE ( 'NONE', #4942, #4621, #2552, .T. ) ; #4734 = EDGE_LOOP ( 'NONE', ( #4705, #4814, #4815, #4736 ) ) ; #4735 = VERTEX_POINT ( 'NONE', #2553 ) ; #4736 = ORIENTED_EDGE ( 'NONE', *, *, #4697, .T. ) ; #4737 = VERTEX_POINT ( 'NONE', #2563 ) ; #4738 = ORIENTED_EDGE ( 'NONE', *, *, #4739, .F. ) ; #4739 = EDGE_CURVE ( 'NONE', #4737, #4813, #2576, .T. ) ; #4740 = ORIENTED_EDGE ( 'NONE', *, *, #4645, .F. ) ; #4741 = ORIENTED_EDGE ( 'NONE', *, *, #4745, .F. ) ; #4742 = ORIENTED_EDGE ( 'NONE', *, *, #5028, .F. ) ; #4743 = ADVANCED_FACE ( 'NONE', ( #2572 ), #2620, .F. ) ; #4744 = EDGE_CURVE ( 'NONE', #4794, #4805, #2578, .T. ) ; #4745 = EDGE_CURVE ( 'NONE', #4696, #4729, #2591, .T. ) ; #4746 = ORIENTED_EDGE ( 'NONE', *, *, #4772, .T. ) ; #4747 = ADVANCED_FACE ( 'NONE', ( #2599 ), #2613, .F. ) ; #4748 = ORIENTED_EDGE ( 'NONE', *, *, #4707, .F. ) ; #4749 = ORIENTED_EDGE ( 'NONE', *, *, #4750, .T. ) ; #4750 = EDGE_CURVE ( 'NONE', #4662, #4751, #2596, .T. ) ; #4751 = VERTEX_POINT ( 'NONE', #2625 ) ; #4752 = ORIENTED_EDGE ( 'NONE', *, *, #4753, .F. ) ; #4753 = EDGE_CURVE ( 'NONE', #4662, #4754, #2590, .T. ) ; #4754 = VERTEX_POINT ( 'NONE', #2579 ) ; #4755 = ORIENTED_EDGE ( 'NONE', *, *, #4756, .F. ) ; #4756 = EDGE_CURVE ( 'NONE', #4766, #4762, #2611, .T. ) ; #4757 = ORIENTED_EDGE ( 'NONE', *, *, #4765, .F. ) ; #4758 = EDGE_LOOP ( 'NONE', ( #4695, #4673, #4777, #4780 ) ) ; #4759 = ORIENTED_EDGE ( 'NONE', *, *, #4760, .T. ) ; #4760 = EDGE_CURVE ( 'NONE', #4761, #4762, #2607, .T. ) ; #4761 = VERTEX_POINT ( 'NONE', #2630 ) ; #4762 = VERTEX_POINT ( 'NONE', #2629 ) ; #4763 = ORIENTED_EDGE ( 'NONE', *, *, #4628, .F. ) ; #4764 = ORIENTED_EDGE ( 'NONE', *, *, #4765, .T. ) ; #4765 = EDGE_CURVE ( 'NONE', #4819, #4766, #2584, .T. ) ; #4766 = VERTEX_POINT ( 'NONE', #2668 ) ; #4767 = ADVANCED_FACE ( 'NONE', ( #2659 ), #2653, .T. ) ; #4768 = ORIENTED_EDGE ( 'NONE', *, *, #4769, .T. ) ; #4769 = EDGE_CURVE ( 'NONE', #4800, #4770, #2646, .T. ) ; #4770 = VERTEX_POINT ( 'NONE', #2663 ) ; #4771 = ORIENTED_EDGE ( 'NONE', *, *, #4772, .F. ) ; #4772 = EDGE_CURVE ( 'NONE', #4773, #4770, #2672, .T. ) ; #4773 = VERTEX_POINT ( 'NONE', #2680 ) ; #4774 = ORIENTED_EDGE ( 'NONE', *, *, #4789, .T. ) ; #4775 = ADVANCED_FACE ( 'NONE', ( #2728 ), #2705, .F. ) ; #4776 = VERTEX_POINT ( 'NONE', #2695 ) ; #4777 = ORIENTED_EDGE ( 'NONE', *, *, #4778, .F. ) ; #4778 = EDGE_CURVE ( 'NONE', #4779, #4675, #2679, .T. ) ; #4779 = VERTEX_POINT ( 'NONE', #2732 ) ; #4780 = ORIENTED_EDGE ( 'NONE', *, *, #4781, .F. ) ; #4781 = EDGE_CURVE ( 'NONE', #4671, #4779, #2730, .T. ) ; #4782 = ADVANCED_FACE ( 'NONE', ( #2725 ), #2710, .T. ) ; #4783 = EDGE_LOOP ( 'NONE', ( #4642, #4643, #4688, #4640 ) ) ; #4784 = EDGE_CURVE ( 'NONE', #4785, #4751, #2721, .T. ) ; #4785 = VERTEX_POINT ( 'NONE', #2714 ) ; #4786 = ORIENTED_EDGE ( 'NONE', *, *, #4788, .F. ) ; #4787 = VERTEX_POINT ( 'NONE', #2713 ) ; #4788 = EDGE_CURVE ( 'NONE', #4787, #4785, #2709, .T. ) ; #4789 = EDGE_CURVE ( 'NONE', #4808, #4684, #2693, .T. ) ; #4790 = VERTEX_POINT ( 'NONE', #2740 ) ; #4791 = ORIENTED_EDGE ( 'NONE', *, *, #4792, .F. ) ; #4792 = EDGE_CURVE ( 'NONE', #4793, #4790, #2744, .T. ) ; #4793 = VERTEX_POINT ( 'NONE', #492 ) ; #4794 = VERTEX_POINT ( 'NONE', #485 ) ; #4795 = ORIENTED_EDGE ( 'NONE', *, *, #4796, .T. ) ; #4796 = EDGE_CURVE ( 'NONE', #4684, #4665, #491, .T. ) ; #4797 = ORIENTED_EDGE ( 'NONE', *, *, #4798, .F. ) ; #4798 = EDGE_CURVE ( 'NONE', #4799, #4800, #482, .T. ) ; #4799 = VERTEX_POINT ( 'NONE', #497 ) ; #4800 = VERTEX_POINT ( 'NONE', #507 ) ; #4801 = ORIENTED_EDGE ( 'NONE', *, *, #4802, .F. ) ; #4802 = EDGE_CURVE ( 'NONE', #4665, #4799, #506, .T. ) ; #4803 = ORIENTED_EDGE ( 'NONE', *, *, #4796, .F. ) ; #4804 = ORIENTED_EDGE ( 'NONE', *, *, #4659, .T. ) ; #4805 = VERTEX_POINT ( 'NONE', #488 ) ; #4806 = VERTEX_POINT ( 'NONE', #502 ) ; #4807 = ORIENTED_EDGE ( 'NONE', *, *, #4716, .T. ) ; #4808 = VERTEX_POINT ( 'NONE', #501 ) ; #4809 = ORIENTED_EDGE ( 'NONE', *, *, #4725, .T. ) ; #4810 = VERTEX_POINT ( 'NONE', #487 ) ; #4811 = ORIENTED_EDGE ( 'NONE', *, *, #4745, .T. ) ; #4812 = EDGE_LOOP ( 'NONE', ( #4702, #4809, #4731, #4944 ) ) ; #4813 = VERTEX_POINT ( 'NONE', #486 ) ; #4814 = ORIENTED_EDGE ( 'NONE', *, *, #4733, .F. ) ; #4815 = ORIENTED_EDGE ( 'NONE', *, *, #4816, .F. ) ; #4816 = EDGE_CURVE ( 'NONE', #4735, #4942, #483, .T. ) ; #4817 = EDGE_CURVE ( 'NONE', #4589, #4629, #496, .T. ) ; #4818 = ORIENTED_EDGE ( 'NONE', *, *, #5667, .F. ) ; #4819 = VERTEX_POINT ( 'NONE', #292 ) ; #4820 = ORIENTED_EDGE ( 'NONE', *, *, #4679, .F. ) ; #4821 = ORIENTED_EDGE ( 'NONE', *, *, #4822, .F. ) ; #4822 = EDGE_CURVE ( 'NONE', #4959, #4830, #288, .T. ) ; #4823 = ADVANCED_FACE ( 'NONE', ( #290 ), #309, .F. ) ; #4824 = EDGE_LOOP ( 'NONE', ( #4980, #4918, #4919, #4878 ) ) ; #4825 = ORIENTED_EDGE ( 'NONE', *, *, #4686, .F. ) ; #4826 = ORIENTED_EDGE ( 'NONE', *, *, #5015, .T. ) ; #4827 = ORIENTED_EDGE ( 'NONE', *, *, #5062, .F. ) ; #4828 = EDGE_LOOP ( 'NONE', ( #4955, #4981, #4943, #4948 ) ) ; #4829 = ADVANCED_FACE ( 'NONE', ( #302 ), #332, .T. ) ; #4830 = VERTEX_POINT ( 'NONE', #322 ) ; #4831 = EDGE_CURVE ( 'NONE', #4621, #4729, #321, .T. ) ; #4832 = ORIENTED_EDGE ( 'NONE', *, *, #4833, .T. ) ; #4833 = EDGE_CURVE ( 'NONE', #4737, #4735, #326, .T. ) ; #4834 = EDGE_LOOP ( 'NONE', ( #4835, #4836, #4837, #5191, #5192, #5193, #5123, #5126 ) ) ; #4835 = ORIENTED_EDGE ( 'NONE', *, *, #4744, .F. ) ; #4836 = ORIENTED_EDGE ( 'NONE', *, *, #4719, .F. ) ; #4837 = ORIENTED_EDGE ( 'NONE', *, *, #4802, .T. ) ; #4838 = ORIENTED_EDGE ( 'NONE', *, *, #5130, .F. ) ; #4839 = ADVANCED_FACE ( 'NONE', ( #347 ), #356, .T. ) ; #4840 = ORIENTED_EDGE ( 'NONE', *, *, #5086, .T. ) ; #4841 = ORIENTED_EDGE ( 'NONE', *, *, #5079, .F. ) ; #4842 = ORIENTED_EDGE ( 'NONE', *, *, #4969, .F. ) ; #4843 = ORIENTED_EDGE ( 'NONE', *, *, #4973, .F. ) ; #4844 = ORIENTED_EDGE ( 'NONE', *, *, #4974, .T. ) ; #4845 = ORIENTED_EDGE ( 'NONE', *, *, #5043, .F. ) ; #4846 = EDGE_CURVE ( 'NONE', #4847, #4959, #360, .T. ) ; #4847 = VERTEX_POINT ( 'NONE', #400 ) ; #4848 = ORIENTED_EDGE ( 'NONE', *, *, #4704, .T. ) ; #4849 = ORIENTED_EDGE ( 'NONE', *, *, #5793, .F. ) ; #4850 = ORIENTED_EDGE ( 'NONE', *, *, #4851, .T. ) ; #4851 = EDGE_CURVE ( 'NONE', #5057, #4852, #413, .T. ) ; #4852 = VERTEX_POINT ( 'NONE', #377 ) ; #4853 = ORIENTED_EDGE ( 'NONE', *, *, #4854, .F. ) ; #4854 = EDGE_CURVE ( 'NONE', #5636, #4852, #404, .T. ) ; #4855 = ORIENTED_EDGE ( 'NONE', *, *, #4856, .T. ) ; #4856 = EDGE_CURVE ( 'NONE', #5019, #4934, #406, .T. ) ; #4857 = ADVANCED_FACE ( 'NONE', ( #390 ), #410, .F. ) ; #4858 = ORIENTED_EDGE ( 'NONE', *, *, #4817, .T. ) ; #4859 = EDGE_CURVE ( 'NONE', #4629, #4860, #388, .T. ) ; #4860 = VERTEX_POINT ( 'NONE', #399 ) ; #4861 = ORIENTED_EDGE ( 'NONE', *, *, #4859, .T. ) ; #4862 = ORIENTED_EDGE ( 'NONE', *, *, #4984, .F. ) ; #4863 = EDGE_LOOP ( 'NONE', ( #5036, #5037 ) ) ; #4864 = ORIENTED_EDGE ( 'NONE', *, *, #5032, .T. ) ; #4865 = ORIENTED_EDGE ( 'NONE', *, *, #4875, .T. ) ; #4866 = ADVANCED_FACE ( 'NONE', ( #398, #397 ), #419, .T. ) ; #4867 = ORIENTED_EDGE ( 'NONE', *, *, #5030, .T. ) ; #4868 = EDGE_LOOP ( 'NONE', ( #4869, #5216, #5247, #5249 ) ) ; #4869 = ORIENTED_EDGE ( 'NONE', *, *, #4870, .F. ) ; #4870 = EDGE_CURVE ( 'NONE', #4860, #4703, #446, .T. ) ; #4871 = ORIENTED_EDGE ( 'NONE', *, *, #4872, .T. ) ; #4872 = EDGE_CURVE ( 'NONE', #4620, #5676, #425, .T. ) ; #4873 = ORIENTED_EDGE ( 'NONE', *, *, #4957, .T. ) ; #4874 = ORIENTED_EDGE ( 'NONE', *, *, #5066, .T. ) ; #4875 = EDGE_CURVE ( 'NONE', #4730, #4620, #441, .T. ) ; #4876 = ORIENTED_EDGE ( 'NONE', *, *, #4877, .T. ) ; #4877 = EDGE_CURVE ( 'NONE', #4729, #4813, #424, .T. ) ; #4878 = ORIENTED_EDGE ( 'NONE', *, *, #4982, .T. ) ; #4879 = ADVANCED_FACE ( 'NONE', ( #418, #449 ), #468, .F. ) ; #4880 = ORIENTED_EDGE ( 'NONE', *, *, #4920, .T. ) ; #4881 = ORIENTED_EDGE ( 'NONE', *, *, #4846, .T. ) ; #4882 = VERTEX_POINT ( 'NONE', #463 ) ; #4883 = EDGE_CURVE ( 'NONE', #4942, #4696, #457, .T. ) ; #4884 = EDGE_CURVE ( 'NONE', #4852, #5019, #459, .T. ) ; #4885 = ORIENTED_EDGE ( 'NONE', *, *, #4926, .T. ) ; #4886 = ADVANCED_FACE ( 'NONE', ( #473 ), #512, .T. ) ; #4887 = EDGE_LOOP ( 'NONE', ( #5047, #5048, #5050, #5051 ) ) ; #4888 = EDGE_LOOP ( 'NONE', ( #4889, #4950 ) ) ; #4889 = ORIENTED_EDGE ( 'NONE', *, *, #5576, .T. ) ; #4890 = ORIENTED_EDGE ( 'NONE', *, *, #4971, .F. ) ; #4891 = ORIENTED_EDGE ( 'NONE', *, *, #4966, .F. ) ; #4892 = ORIENTED_EDGE ( 'NONE', *, *, #4894, .F. ) ; #4893 = ADVANCED_FACE ( 'NONE', ( #514 ), #557, .T. ) ; #4894 = EDGE_CURVE ( 'NONE', #4915, #4898, #567, .T. ) ; #4895 = VERTEX_POINT ( 'NONE', #564 ) ; #4896 = ORIENTED_EDGE ( 'NONE', *, *, #4967, .F. ) ; #4897 = VERTEX_POINT ( 'NONE', #541 ) ; #4898 = VERTEX_POINT ( 'NONE', #540 ) ; #4899 = ADVANCED_FACE ( 'NONE', ( #555 ), #560, .T. ) ; #4900 = EDGE_CURVE ( 'NONE', #4904, #4909, #546, .T. ) ; #4901 = EDGE_CURVE ( 'NONE', #4904, #5072, #593, .T. ) ; #4902 = ORIENTED_EDGE ( 'NONE', *, *, #4913, .F. ) ; #4903 = EDGE_LOOP ( 'NONE', ( #4902, #4916, #5004, #5008, #4891, #4841, #4843, #4892 ) ) ; #4904 = VERTEX_POINT ( 'NONE', #579 ) ; #4905 = ORIENTED_EDGE ( 'NONE', *, *, #4906, .F. ) ; #4906 = EDGE_CURVE ( 'NONE', #4909, #5070, #577, .T. ) ; #4907 = ORIENTED_EDGE ( 'NONE', *, *, #5092, .F. ) ; #4908 = EDGE_LOOP ( 'NONE', ( #4912, #4911, #4907, #4905 ) ) ; #4909 = VERTEX_POINT ( 'NONE', #578 ) ; #4910 = ADVANCED_FACE ( 'NONE', ( #572 ), #604, .T. ) ; #4911 = ORIENTED_EDGE ( 'NONE', *, *, #4901, .T. ) ; #4912 = ORIENTED_EDGE ( 'NONE', *, *, #4900, .F. ) ; #4913 = EDGE_CURVE ( 'NONE', #4914, #4915, #614, .T. ) ; #4914 = VERTEX_POINT ( 'NONE', #611 ) ; #4915 = VERTEX_POINT ( 'NONE', #610 ) ; #4916 = ORIENTED_EDGE ( 'NONE', *, *, #4965, .T. ) ; #4917 = EDGE_CURVE ( 'NONE', #4975, #4947, #608, .T. ) ; #4918 = ORIENTED_EDGE ( 'NONE', *, *, #4945, .T. ) ; #4919 = ORIENTED_EDGE ( 'NONE', *, *, #4920, .F. ) ; #4920 = EDGE_CURVE ( 'NONE', #5059, #4847, #624, .T. ) ; #4921 = ORIENTED_EDGE ( 'NONE', *, *, #4923, .F. ) ; #4922 = EDGE_CURVE ( 'NONE', #4941, #5040, #621, .T. ) ; #4923 = EDGE_CURVE ( 'NONE', #4924, #5044, #630, .T. ) ; #4924 = VERTEX_POINT ( 'NONE', #629 ) ; #4925 = ORIENTED_EDGE ( 'NONE', *, *, #4926, .F. ) ; #4926 = EDGE_CURVE ( 'NONE', #4852, #4924, #627, .T. ) ; #4927 = ORIENTED_EDGE ( 'NONE', *, *, #4851, .F. ) ; #4928 = ORIENTED_EDGE ( 'NONE', *, *, #5009, .T. ) ; #4929 = ADVANCED_FACE ( 'NONE', ( #640 ), #643, .T. ) ; #4930 = EDGE_LOOP ( 'NONE', ( #4931, #5014, #5017, #4855 ) ) ; #4931 = ORIENTED_EDGE ( 'NONE', *, *, #4932, .F. ) ; #4932 = EDGE_CURVE ( 'NONE', #4933, #4934, #678, .T. ) ; #4933 = VERTEX_POINT ( 'NONE', #672 ) ; #4934 = VERTEX_POINT ( 'NONE', #689 ) ; #4935 = ORIENTED_EDGE ( 'NONE', *, *, #5609, .F. ) ; #4936 = EDGE_LOOP ( 'NONE', ( #5020, #5021, #5010, #5011 ) ) ; #4937 = ORIENTED_EDGE ( 'NONE', *, *, #5009, .F. ) ; #4938 = ORIENTED_EDGE ( 'NONE', *, *, #5521, .F. ) ; #4939 = ADVANCED_FACE ( 'NONE', ( #688 ), #686, .T. ) ; #4940 = ORIENTED_EDGE ( 'NONE', *, *, #5022, .F. ) ; #4941 = VERTEX_POINT ( 'NONE', #683 ) ; #4942 = VERTEX_POINT ( 'NONE', #671 ) ; #4943 = ORIENTED_EDGE ( 'NONE', *, *, #4957, .F. ) ; #4944 = ORIENTED_EDGE ( 'NONE', *, *, #4956, .F. ) ; #4945 = EDGE_CURVE ( 'NONE', #4975, #4847, #669, .T. ) ; #4946 = EDGE_CURVE ( 'NONE', #4947, #4730, #709, .T. ) ; #4947 = VERTEX_POINT ( 'NONE', #718 ) ; #4948 = ORIENTED_EDGE ( 'NONE', *, *, #4725, .F. ) ; #4949 = ADVANCED_FACE ( 'NONE', ( #748 ), #702, .T. ) ; #4950 = ORIENTED_EDGE ( 'NONE', *, *, #5449, .T. ) ; #4951 = ADVANCED_FACE ( 'NONE', ( #731 ), #700, .T. ) ; #4952 = EDGE_LOOP ( 'NONE', ( #4953, #4954, #4983, #4985 ) ) ; #4953 = ORIENTED_EDGE ( 'NONE', *, *, #4977, .F. ) ; #4954 = ORIENTED_EDGE ( 'NONE', *, *, #4822, .T. ) ; #4955 = ORIENTED_EDGE ( 'NONE', *, *, #4946, .F. ) ; #4956 = EDGE_CURVE ( 'NONE', #4620, #4882, #706, .T. ) ; #4957 = EDGE_CURVE ( 'NONE', #4810, #5059, #744, .T. ) ; #4958 = EDGE_LOOP ( 'NONE', ( #5031, #4960, #5029, #4821 ) ) ; #4959 = VERTEX_POINT ( 'NONE', #740 ) ; #4960 = ORIENTED_EDGE ( 'NONE', *, *, #4945, .F. ) ; #4961 = ORIENTED_EDGE ( 'NONE', *, *, #4962, .F. ) ; #4962 = EDGE_CURVE ( 'NONE', #4968, #4895, #653, .T. ) ; #4963 = VERTEX_POINT ( 'NONE', #756 ) ; #4964 = EDGE_CURVE ( 'NONE', #4904, #4996, #751, .T. ) ; #4965 = EDGE_CURVE ( 'NONE', #4914, #4996, #753, .T. ) ; #4966 = EDGE_CURVE ( 'NONE', #5081, #4909, #778, .T. ) ; #4967 = EDGE_CURVE ( 'NONE', #4897, #4968, #767, .T. ) ; #4968 = VERTEX_POINT ( 'NONE', #800 ) ; #4969 = EDGE_CURVE ( 'NONE', #4895, #4914, #805, .T. ) ; #4970 = ORIENTED_EDGE ( 'NONE', *, *, #4965, .F. ) ; #4971 = EDGE_CURVE ( 'NONE', #4996, #4963, #777, .T. ) ; #4972 = EDGE_LOOP ( 'NONE', ( #5007, #4961, #4896, #5005, #4840, #4997, #5000, #4845 ) ) ; #4973 = EDGE_CURVE ( 'NONE', #4898, #5040, #809, .T. ) ; #4974 = EDGE_CURVE ( 'NONE', #4895, #4963, #781, .T. ) ; #4975 = VERTEX_POINT ( 'NONE', #816 ) ; #4976 = ORIENTED_EDGE ( 'NONE', *, *, #4977, .T. ) ; #4977 = EDGE_CURVE ( 'NONE', #4959, #4687, #803, .T. ) ; #4978 = ORIENTED_EDGE ( 'NONE', *, *, #4644, .F. ) ; #4979 = ORIENTED_EDGE ( 'NONE', *, *, #4674, .F. ) ; #4980 = ORIENTED_EDGE ( 'NONE', *, *, #4917, .F. ) ; #4981 = ORIENTED_EDGE ( 'NONE', *, *, #4982, .F. ) ; #4982 = EDGE_CURVE ( 'NONE', #5059, #4947, #818, .T. ) ; #4983 = ORIENTED_EDGE ( 'NONE', *, *, #4984, .T. ) ; #4984 = EDGE_CURVE ( 'NONE', #4830, #4690, #815, .T. ) ; #4985 = ORIENTED_EDGE ( 'NONE', *, *, #4689, .T. ) ; #4986 = EDGE_LOOP ( 'NONE', ( #4987, #4989, #4990, #4885 ) ) ; #4987 = ORIENTED_EDGE ( 'NONE', *, *, #4988, .T. ) ; #4988 = EDGE_CURVE ( 'NONE', #4924, #4934, #795, .T. ) ; #4989 = ORIENTED_EDGE ( 'NONE', *, *, #4856, .F. ) ; #4990 = ORIENTED_EDGE ( 'NONE', *, *, #4884, .F. ) ; #4991 = EDGE_CURVE ( 'NONE', #5674, #5057, #774, .T. ) ; #4992 = ORIENTED_EDGE ( 'NONE', *, *, #5041, .F. ) ; #4993 = ORIENTED_EDGE ( 'NONE', *, *, #5548, .F. ) ; #4994 = ORIENTED_EDGE ( 'NONE', *, *, #5079, .T. )
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
