aguileraGit/bf/PCB/mainPCB/mainPCB-Schematics-v0_4.pdf

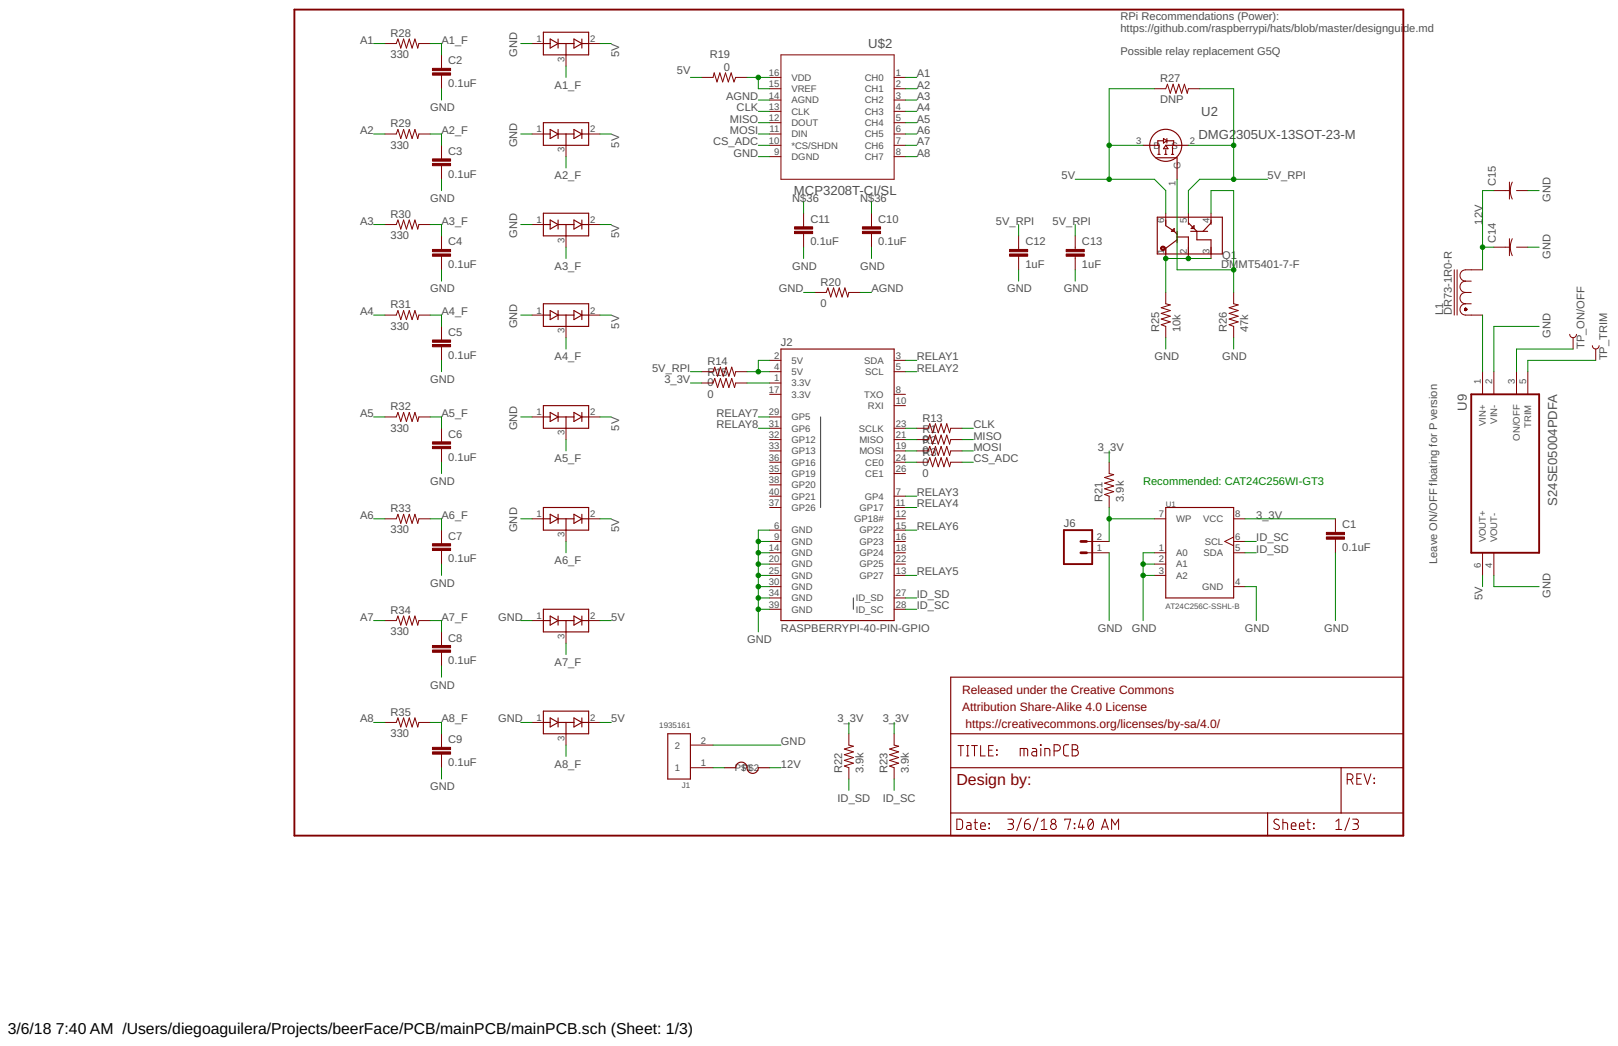
[picture p12: page 1]

RPi Recommendations (Power): https://github.com/raspberrypi/hats/blob/master/designguide.md

GND GND GND GND GND GND GND

Leave ON/OFF floating for P version

Released under the Creative Commons Attribution Share-Alike 4.0 License

https://creativecommons.org/licenses/by-sa/4.0/

3/6/18 7:40 AM /Users/diegoaguilera/Projects/beerFace/PCB/mainPCB/mainPCB.sch (Sheet: 1/3)

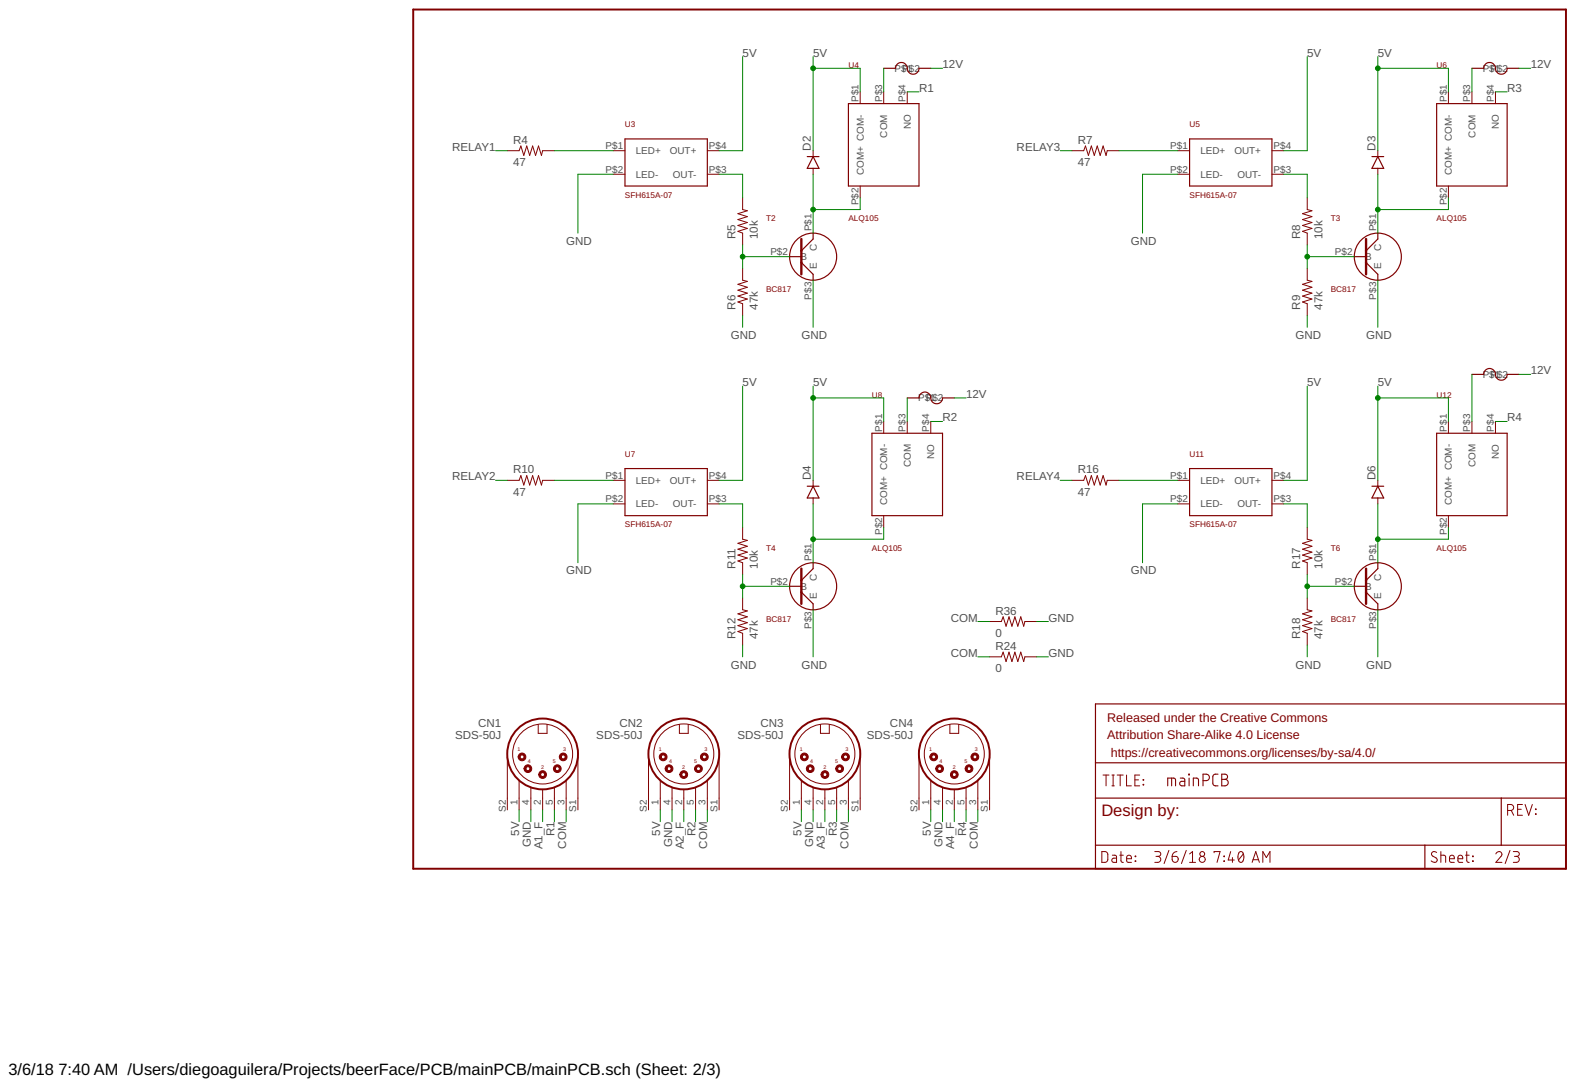
[picture p13: page 2]

Released under the Creative Commons Attribution Share-Alike 4.0 License

https://creativecommons.org/licenses/by-sa/4.0/

3/6/18 7:40 AM /Users/diegoaguilera/Projects/beerFace/PCB/mainPCB/mainPCB.sch (Sheet: 2/3)

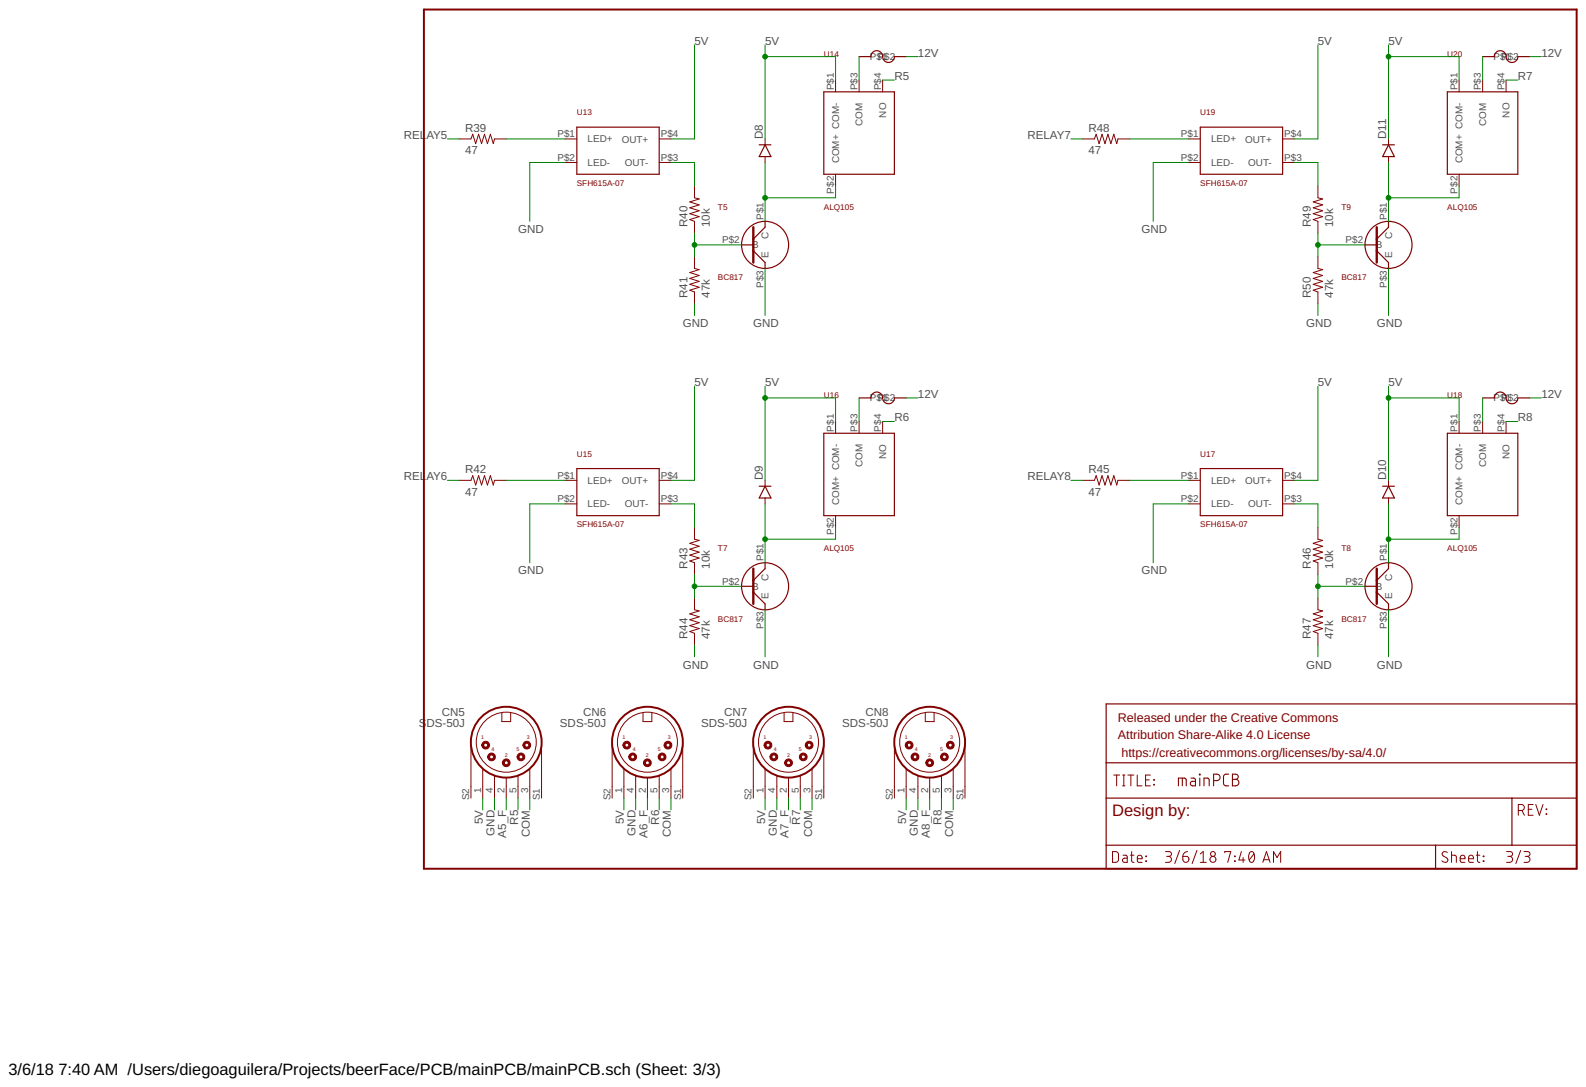
[picture p14: page 3]

Released under the Creative Commons Attribution Share-Alike 4.0 License

https://creativecommons.org/licenses/by-sa/4.0/

3/6/18 7:40 AM /Users/diegoaguilera/Projects/beerFace/PCB/mainPCB/mainPCB.sch (Sheet: 3/3)
