aguileraGit/bf/PCB/mainPCB/mainPCB-Layout-v0_4.pdf

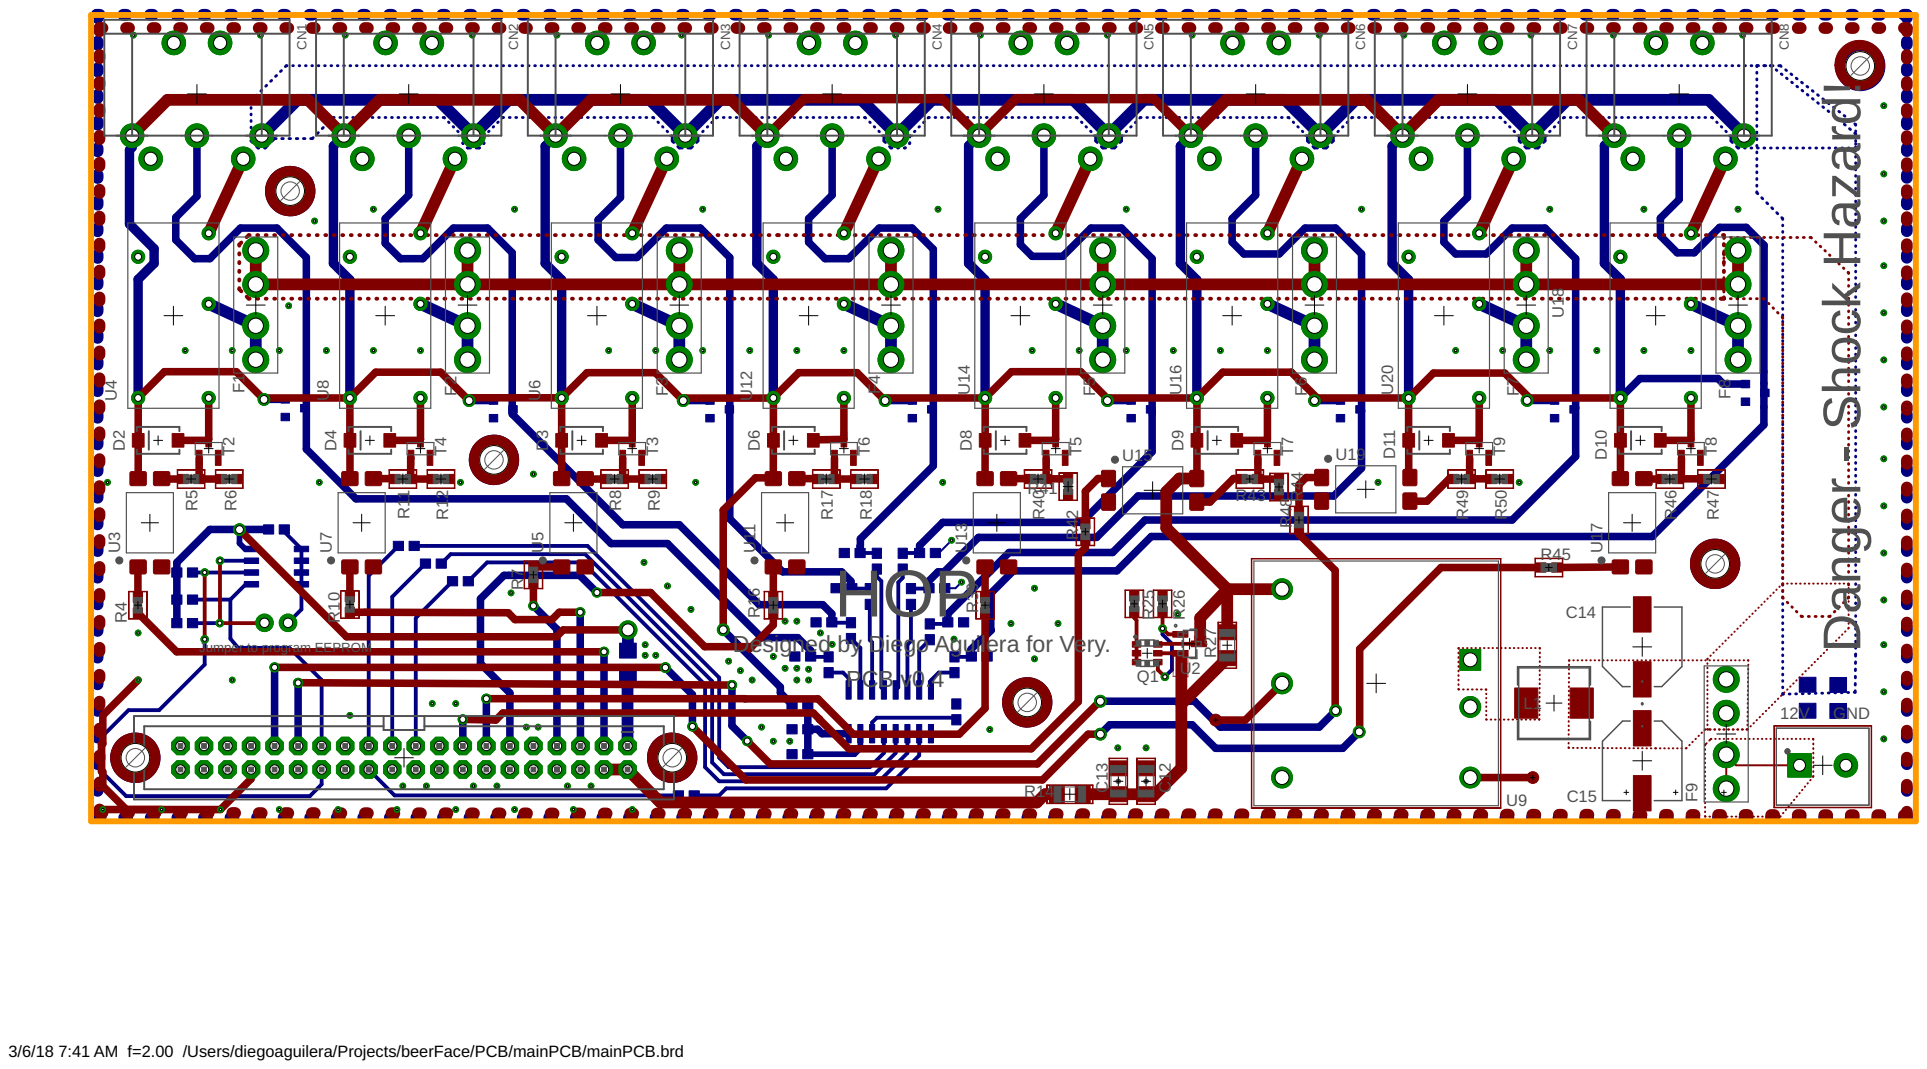
[picture p15: page 1]

Designed by Diego Aguilera for Very. HOP

Jumper to program EEPROM

3/6/18 7:41 AM f=2.00 /Users/diegoaguilera/Projects/beerFace/PCB/mainPCB/mainPCB.brd
