aguileraGit/bf/simulations/relay.asc

D1: diode; 1N4148
I1: load; 0.08
Q1: npn; BC817-25
R1: res; 47
R4: res; 1k
U1: SFH6156; REL_CTR=1.67
V1: voltage; PULSE(0 3.3 1 10ns 10ns 1 2 4)
V2: battery; 5
Named nets: 0, 5V
.tran 0 5 0 0.0001 startup
