aguileraGit/bf/PCB/mainPCB/mainPCB.brd

## EAGLE design PCB/mainPCB/mainPCB.brd (2018-03-08)

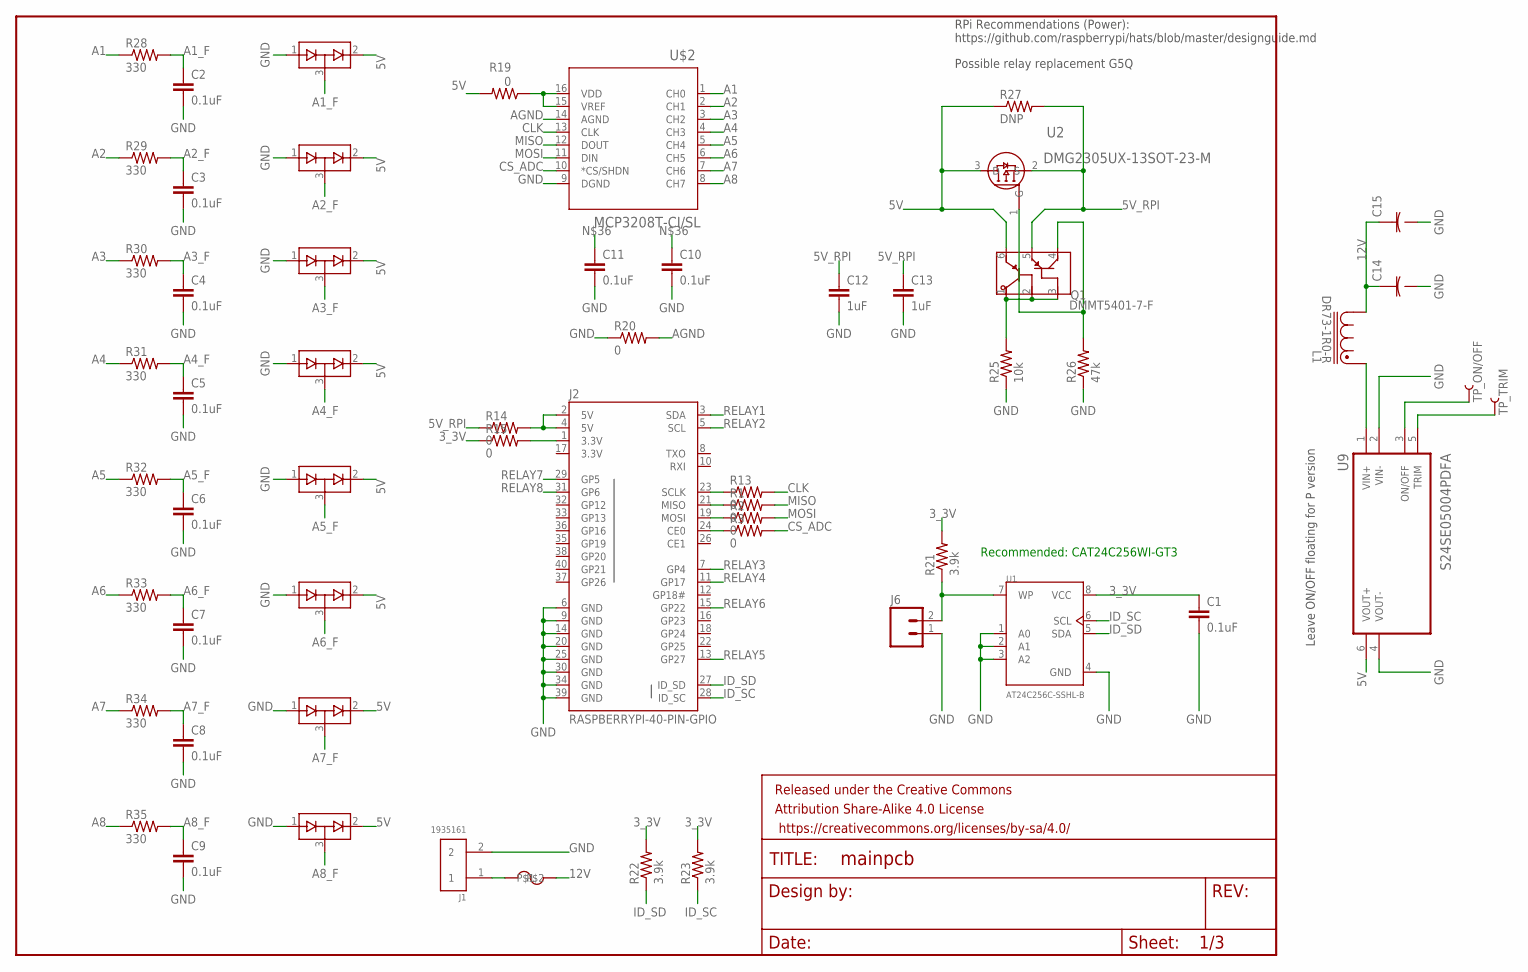
[picture p16: schematic mainPCB.sch, sheet 1, RPi/ADC]

Parts:
C1, C2, C3, C4, C5, C6, C7, C8, C9, C10, C11: 0.1uF; 0603-CAP
C12, C13: 1uF; 1206-CAP
C14, C15: EEE-HA1C471UPCAP_PAN_EEE_F-L; CAP_PAN_EEE_F-L
D1, D5, D7, D12, D13, D14, D15, D16: BAV99-7-F; SOT23-3
F9: 3544-2
FRAME2: FRAME-LETTERNO_PACKAGE; DUMMY
J1: 1935161; PHOENIX_1935161
J2: RASPBERRYPI-40-PIN-GPIO; 2X20-SHROUDED
J6: M02PTH; 1X02
L1: DR73-1R0-R; DR73
Q1: DMMT5401-7-F; SOT26
R1, R2, R3, R13, R19, R20: 0; 0603-RES
R14, R15: 0; 1206
R21, R22, R23: 3.9k; 0603-RES
R25: 10k; 0603-RES
R26: 47k; 0603-RES
R27: DNP; 1206
R28, R29, R30, R31, R32, R33, R34, R35: 330; 0603-RES
TP_ON/OFF: TEST-POINT3X5; PAD.03X.05
TP_TRIM: TEST-POINT3X5; PAD.03X.05
U1: AT24C256C-SSHL-B; SOIC127P600X175-8N
U2: DMG2305UX-13SOT-23-M; SOT-23-M
U9: S24SE05004PDFA; CONV_S24SE05002PDFA
U$2: MCP3208T-CI/SL; SOIC16-N_MC

Connections:
3.3V: J2.17 (3.3V)
3_3V: C1.1, R15.1, R21.2, R22.2, R23.2, U1.8 (VCC)
5V: D1.2 (C2), D5.2 (C2), D7.2 (C2), D12.2 (C2), D13.2 (C2), D14.2 (C2), D15.2 (C2), D16.2 (C2), Q1.6 (E1), R19.2, R27.1, U2.3 (D), U9.6 (VOUT+); also elsewhere on the board
5V_RPI: C12.1, C13.1, Q1.5 (E2), R14.1, R27.2, U2.2 (S)
12V: C14.1 (11), C15.1 (11), F9.P$3, F9.P$4, L1.2; also elsewhere on the board
A1: R28.1, U$2.1 (CH0)
A1_F: C2.1, D1.3 (COM), R28.2; also elsewhere on the board
A2: R29.1, U$2.2 (CH1)
A2_F: C3.1, D5.3 (COM), R29.2; also elsewhere on the board
A3: R30.1, U$2.3 (CH2)
A3_F: C4.1, D7.3 (COM), R30.2; also elsewhere on the board
A4: R31.1, U$2.4 (CH3)
A4_F: C5.1, D12.3 (COM), R31.2; also elsewhere on the board
A5: R32.1, U$2.5 (CH4)
A5_F: C6.1, D13.3 (COM), R32.2; also elsewhere on the board
A6: R33.1, U$2.6 (CH5)
A6_F: C7.1, D14.3 (COM), R33.2; also elsewhere on the board
A7: R34.1, U$2.7 (CH6)
A7_F: C8.1, D15.3 (COM), R34.2; also elsewhere on the board
A8: R35.1, U$2.8 (CH7)
A8_F: C9.1, D16.3 (COM), R35.2; also elsewhere on the board
AGND: R20.2, U$2.14 (AGND)
CLK: R13.2, U$2.13 (CLK)
CS_ADC: R3.2, U$2.10 (*CS/SHDN)
GND: C1.2, C2.2, C3.2, C4.2, C5.2, C6.2, C7.2, C8.2, C9.2, C10.2, C11.2, C12.2, C13.2, C14.2 (22), C15.2 (22), D1.1 (A1), D5.1 (A1), D7.1 (A1), D12.1 (A1), D13.1 (A1), D14.1 (A1), D15.1 (A1), D16.1 (A1), J1.2, J2.6 (GND), J2.9 (GND), J2.14 (GND), J2.20 (GND), J2.25 (GND), J2.30 (GND), J2.34 (GND), J2.39 (GND), J6.1, R20.1, R25.1, R26.1, U1.1 (A0), U1.2 (A1), U1.3 (A2), U1.4 (GND), U9.2 (VIN-), U9.4 (VOUT-), U$2.9 (DGND); also elsewhere on the board
ID_SC: J2.28 (ID_SC), R23.1, U1.6 (SCL)
ID_SD: J2.27 (ID_SD), R22.1, U1.5 (SDA)
MISO: R1.2, U$2.12 (DOUT)
MOSI: R2.2, U$2.11 (DIN)
unnamed: J2.2 (5V), J2.4 (5V), R14.2
unnamed: J2.1 (3.3V), R15.2
unnamed: J2.23 (SCLK), R13.1
unnamed: J2.21 (MISO), R1.1
unnamed: J2.19 (MOSI), R2.1
unnamed: J2.24 (CE0), R3.1
unnamed: Q1.1 (C1), Q1.2 (B1), Q1.3 (B2), R25.2
unnamed: Q1.4 (C2), R26.2, U2.1 (G)
unnamed: TP_ON/OFF.P$1, U9.3 (ON/OFF)
unnamed: C10.1, C11.1, R19.1, U$2.15 (VREF), U$2.16 (VDD)
unnamed: L1.1, U9.1 (VIN+)
unnamed: TP_TRIM.P$1, U9.5 (TRIM)
unnamed: F9.P$1, F9.P$2, J1.1
RELAY1: J2.3 (SDA); also elsewhere on the board
RELAY2: J2.5 (SCL); also elsewhere on the board
RELAY3: J2.7 (GP4); also elsewhere on the board
RELAY4: J2.11 (GP17); also elsewhere on the board
RELAY5: J2.13 (GP27); also elsewhere on the board
RELAY6: J2.15 (GP22); also elsewhere on the board
RELAY7: J2.29 (GP5); also elsewhere on the board
RELAY8: J2.31 (GP6); also elsewhere on the board
WP: J6.2, R21.1, U1.7 (WP)

Notes on the sheet:
Recommended: CAT24C256WI-GT3
RPi Recommendations (Power): https://github.com/raspberrypi/hats/blob/master/designguide.md
Possible relay replacement G5Q
Leave ON/OFF floating for P version

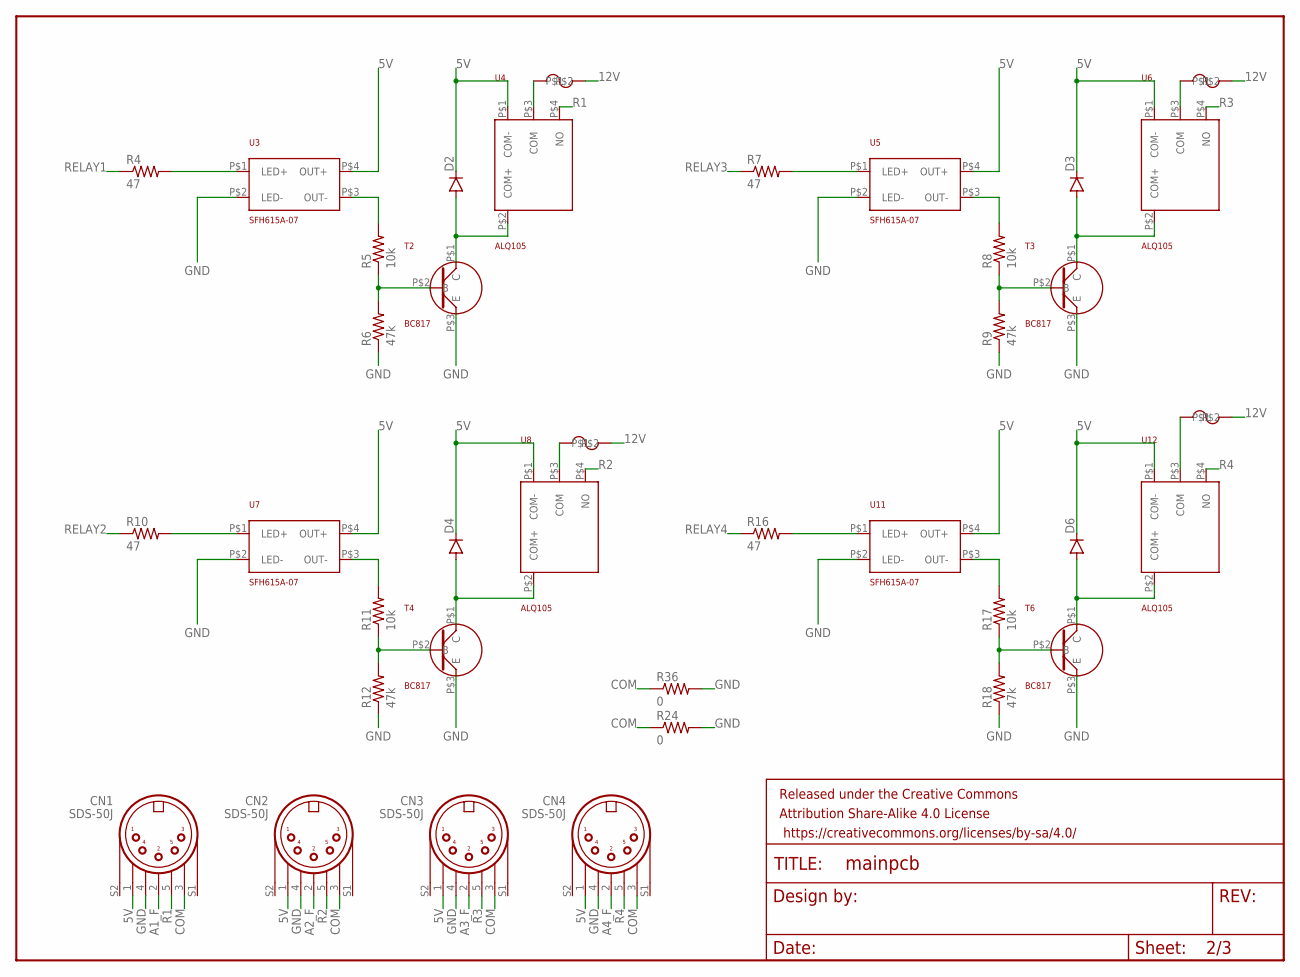
[picture p17: schematic mainPCB.sch, sheet 2, Relays 1-2]

Parts:
CN1, CN2, CN3, CN4: SDS-50J
D2, D3, D4, D6: DIODESMA; SMA-DIODE
F1, F2, F3, F4: 3544-2
FRAME1: FRAME-LETTERNO_PACKAGE; DUMMY
R4, R7, R10, R16: 47; 0603-RES
R5, R8, R11, R17: 10k; 0603-RES
R6, R9, R12, R18: 47k; 0603-RES
R24, R36: 0; 1206
T2, T3, T4, T6: BC817
U3, U5, U7, U11: SFH615A-07
U4, U6, U8, U12: ALQ105

Connections:
5V: CN1.1, CN2.1, CN3.1, CN4.1, D2.C, D3.C, D4.C, D6.C, U3.P$4 (OUT+), U4.P$1 (COM-), U5.P$4 (OUT+), U6.P$1 (COM-), U7.P$4 (OUT+), U8.P$1 (COM-), U11.P$4 (OUT+), U12.P$1 (COM-); also elsewhere on the board
12V: F1.P$3, F1.P$4, F2.P$3, F2.P$4, F3.P$3, F3.P$4, F4.P$3, F4.P$4; also elsewhere on the board
A1_F: CN1.2; also elsewhere on the board
A2_F: CN2.2; also elsewhere on the board
A3_F: CN3.2; also elsewhere on the board
A4_F: CN4.2; also elsewhere on the board
COM: CN1.3, CN2.3, CN3.3, CN4.3, R24.1, R36.1; also elsewhere on the board
GND: CN1.4, CN2.4, CN3.4, CN4.4, R6.1, R9.1, R12.1, R18.1, R24.2, R36.2, T2.P$3 (E), T3.P$3 (E), T4.P$3 (E), T6.P$3 (E), U3.P$2 (LED-), U5.P$2 (LED-), U7.P$2 (LED-), U11.P$2 (LED-); also elsewhere on the board
unnamed: F1.P$1, F1.P$2, U4.P$3 (COM)
unnamed: F2.P$1, F2.P$2, U8.P$3 (COM)
unnamed: F4.P$1, F4.P$2, U12.P$3 (COM)
unnamed: F3.P$1, F3.P$2, U6.P$3 (COM)
unnamed: R4.2, U3.P$1 (LED+)
unnamed: R5.2, U3.P$3 (OUT-)
unnamed: R5.1, R6.2, T2.P$2 (B)
unnamed: D2.A, T2.P$1 (C), U4.P$2 (COM+)
unnamed: R7.2, U5.P$1 (LED+)
unnamed: R8.2, U5.P$3 (OUT-)
unnamed: R8.1, R9.2, T3.P$2 (B)
unnamed: D3.A, T3.P$1 (C), U6.P$2 (COM+)
unnamed: R10.2, U7.P$1 (LED+)
unnamed: R11.2, U7.P$3 (OUT-)
unnamed: R11.1, R12.2, T4.P$2 (B)
unnamed: D4.A, T4.P$1 (C), U8.P$2 (COM+)
unnamed: R16.2, U11.P$1 (LED+)
unnamed: R17.2, U11.P$3 (OUT-)
unnamed: R17.1, R18.2, T6.P$2 (B)
unnamed: D6.A, T6.P$1 (C), U12.P$2 (COM+)
R1: CN1.5, U4.P$4 (NO)
R2: CN2.5, U8.P$4 (NO)
R3: CN3.5, U6.P$4 (NO)
R4: CN4.5, U12.P$4 (NO)
RELAY1: R4.1; also elsewhere on the board
RELAY2: R10.1; also elsewhere on the board
RELAY3: R7.1; also elsewhere on the board
RELAY4: R16.1; also elsewhere on the board

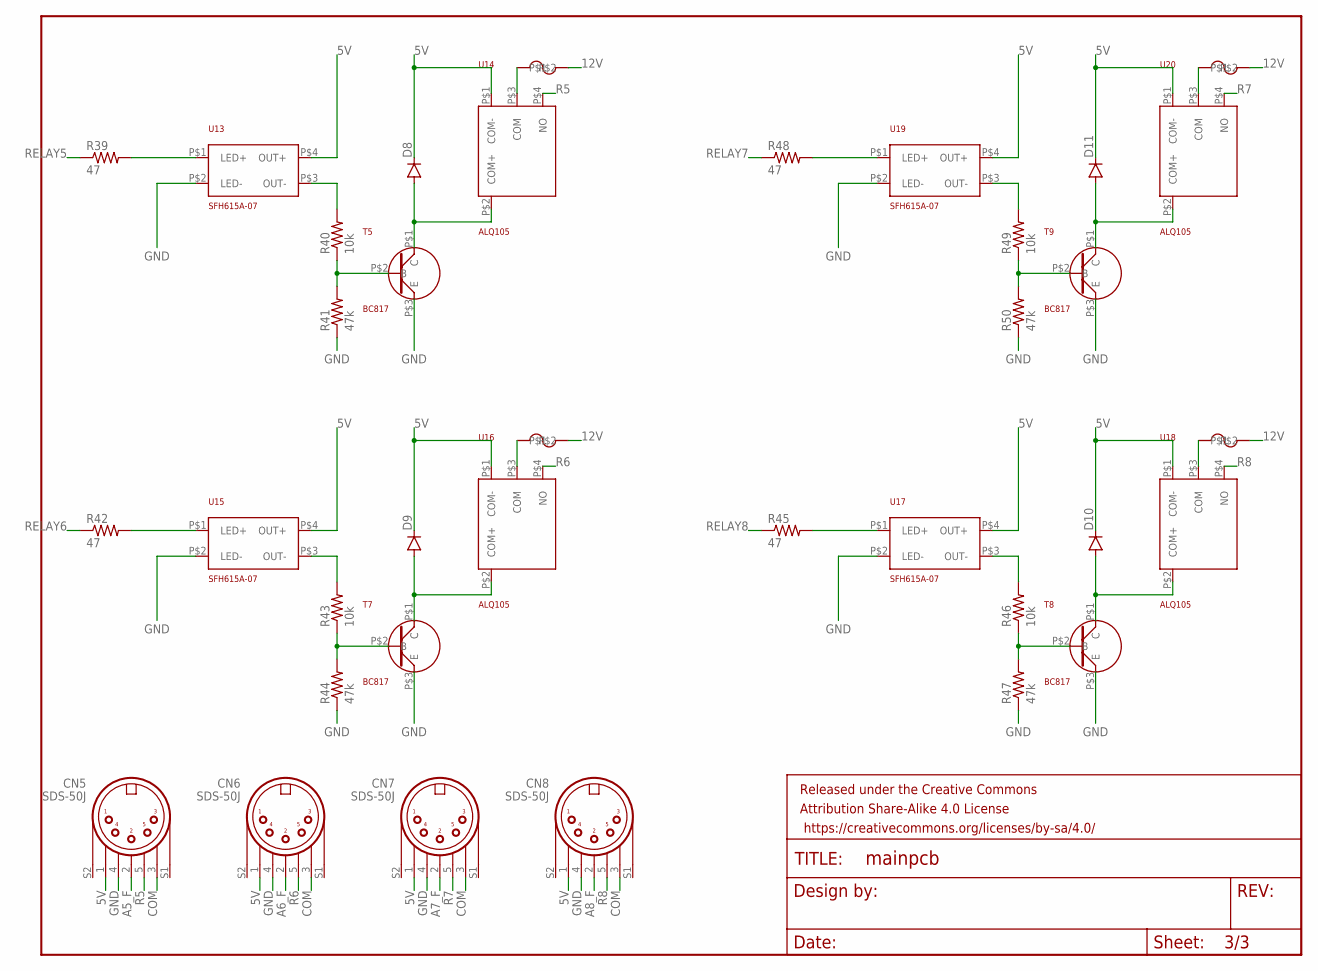
[picture p18: schematic mainPCB.sch, sheet 3]

Parts:
CN5, CN6, CN7, CN8: SDS-50J
D8, D9, D10, D11: DIODESMA; SMA-DIODE
F5, F6, F7, F8: 3544-2
FRAME3: FRAME-LETTER; CREATIVE_COMMONS
R39, R42, R45, R48: 47; 0603-RES
R40, R43, R46, R49: 10k; 0603-RES
R41, R44, R47, R50: 47k; 0603-RES
T5, T7, T8, T9: BC817
U13, U15, U17, U19: SFH615A-07
U14, U16, U18, U20: ALQ105

Connections:
5V: CN5.1, CN6.1, CN7.1, CN8.1, D8.C, D9.C, D10.C, D11.C, U13.P$4 (OUT+), U14.P$1 (COM-), U15.P$4 (OUT+), U16.P$1 (COM-), U17.P$4 (OUT+), U18.P$1 (COM-), U19.P$4 (OUT+), U20.P$1 (COM-); also elsewhere on the board
12V: F5.P$3, F5.P$4, F6.P$3, F6.P$4, F7.P$3, F7.P$4, F8.P$3, F8.P$4; also elsewhere on the board
A5_F: CN5.2; also elsewhere on the board
A6_F: CN6.2; also elsewhere on the board
A7_F: CN7.2; also elsewhere on the board
A8_F: CN8.2; also elsewhere on the board
COM: CN5.3, CN6.3, CN7.3, CN8.3; also elsewhere on the board
GND: CN5.4, CN6.4, CN7.4, CN8.4, R41.1, R44.1, R47.1, R50.1, T5.P$3 (E), T7.P$3 (E), T8.P$3 (E), T9.P$3 (E), U13.P$2 (LED-), U15.P$2 (LED-), U17.P$2 (LED-), U19.P$2 (LED-); also elsewhere on the board
unnamed: F5.P$1, F5.P$2, U14.P$3 (COM)
unnamed: F6.P$1, F6.P$2, U16.P$3 (COM)
unnamed: F7.P$1, F7.P$2, U20.P$3 (COM)
unnamed: F8.P$1, F8.P$2, U18.P$3 (COM)
unnamed: R39.2, U13.P$1 (LED+)
unnamed: R40.2, U13.P$3 (OUT-)
unnamed: R40.1, R41.2, T5.P$2 (B)
unnamed: D8.A, T5.P$1 (C), U14.P$2 (COM+)
unnamed: R42.2, U15.P$1 (LED+)
unnamed: R43.2, U15.P$3 (OUT-)
unnamed: R43.1, R44.2, T7.P$2 (B)
unnamed: D9.A, T7.P$1 (C), U16.P$2 (COM+)
unnamed: R45.2, U17.P$1 (LED+)
unnamed: R46.2, U17.P$3 (OUT-)
unnamed: R46.1, R47.2, T8.P$2 (B)
unnamed: D10.A, T8.P$1 (C), U18.P$2 (COM+)
unnamed: R48.2, U19.P$1 (LED+)
unnamed: R49.2, U19.P$3 (OUT-)
unnamed: R49.1, R50.2, T9.P$2 (B)
unnamed: D11.A, T9.P$1 (C), U20.P$2 (COM+)
R5: CN5.5, U14.P$4 (NO)
R6: CN6.5, U16.P$4 (NO)
R7: CN7.5, U20.P$4 (NO)
R8: CN8.5, U18.P$4 (NO)
RELAY5: R39.1; also elsewhere on the board
RELAY6: R42.1; also elsewhere on the board
RELAY7: R48.1; also elsewhere on the board
RELAY8: R45.1; also elsewhere on the board

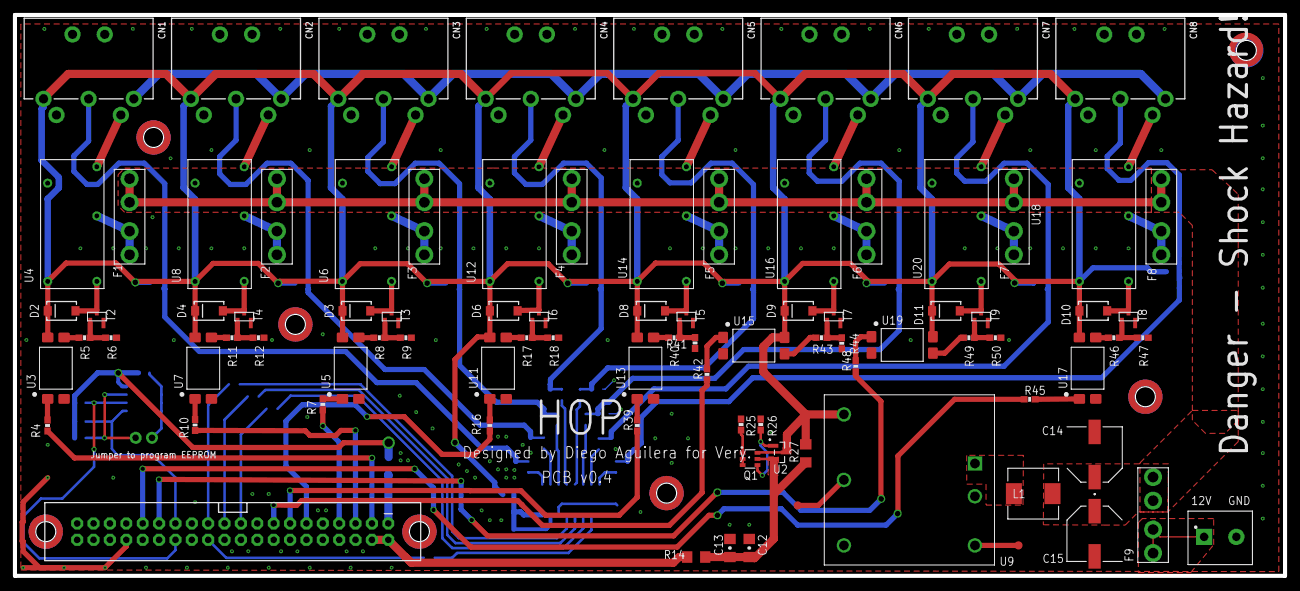
[picture p19: board mainPCB.brd from above]

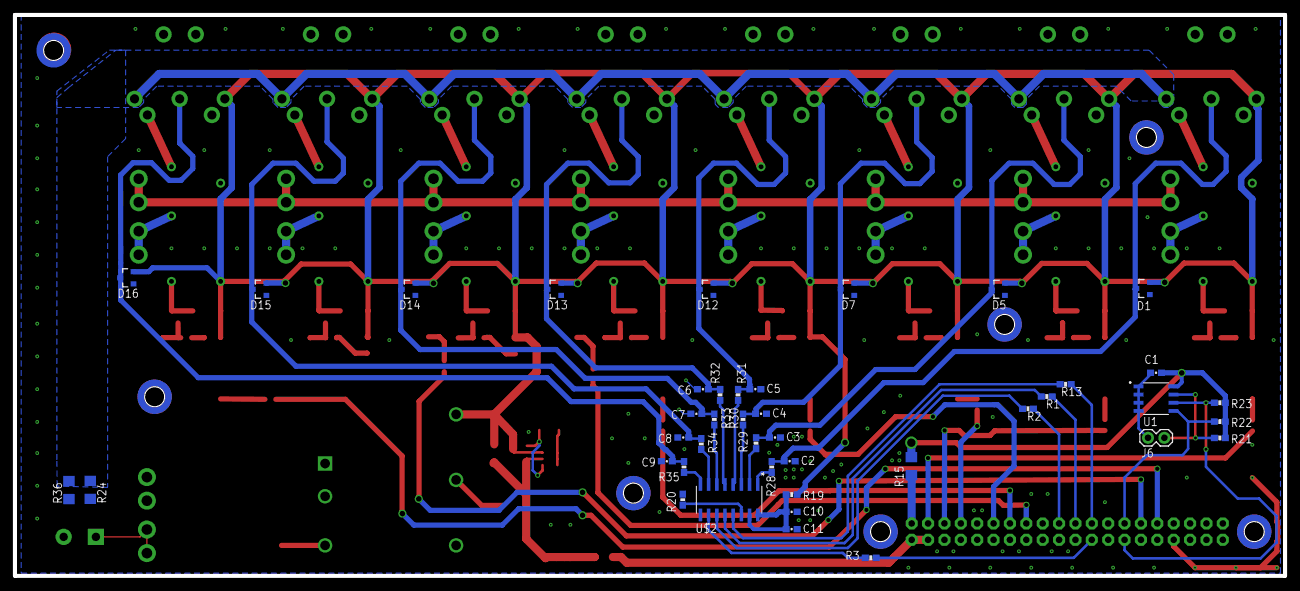
[picture p20: board mainPCB.brd from below]

Board: 2 copper layers, 197.0 x 87.0 mm, 134 parts (42 on the bottom side), 99 nets.
