aguileraGit/bf/PCB/relay/v1.brd

## EAGLE design PCB/relay/v1.brd (2018-01-02)

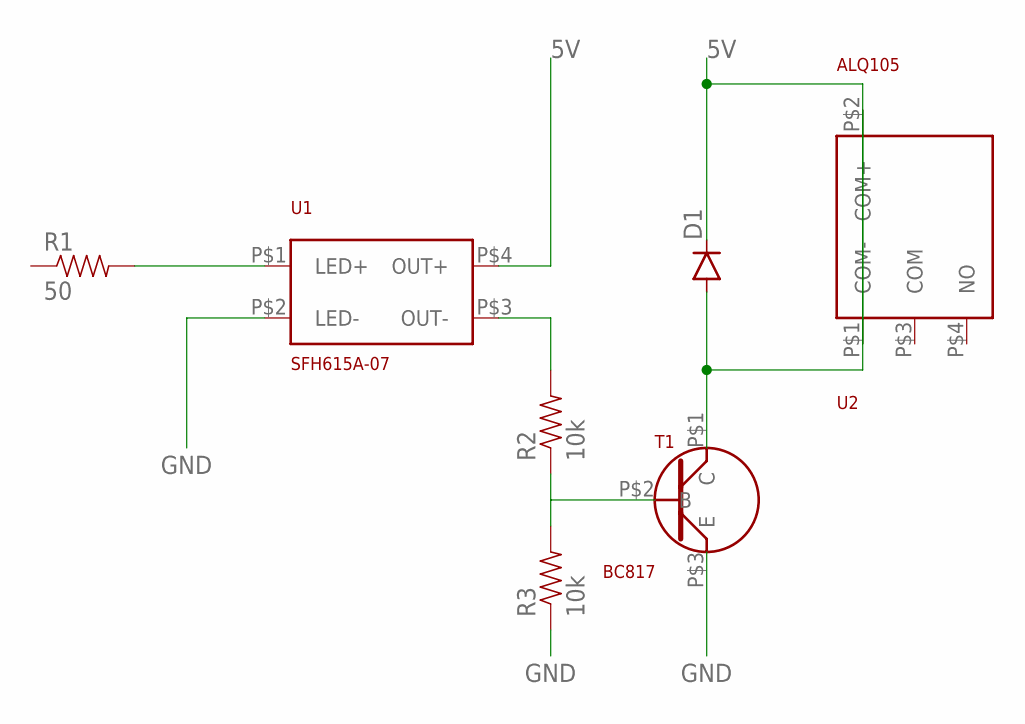
[picture p21: schematic v1.sch]

Parts:
D1: DIODESMA; SMA-DIODE
R1: 50; 0603-RES
R2, R3: 10k; 0603-RES
T1: BC817
U1: SFH615A-07
U2: ALQ105

Connections:
5V: D1.C, U1.P$4 (OUT+), U2.P$1 (COM-)
GND: R3.1, T1.P$3 (E), U1.P$2 (LED-)
unnamed: R1.2, U1.P$1 (LED+)
unnamed: R2.2, U1.P$3 (OUT-)
unnamed: R2.1, R3.2, T1.P$2 (B)
unnamed: D1.A, T1.P$1 (C), U2.P$2 (COM+)

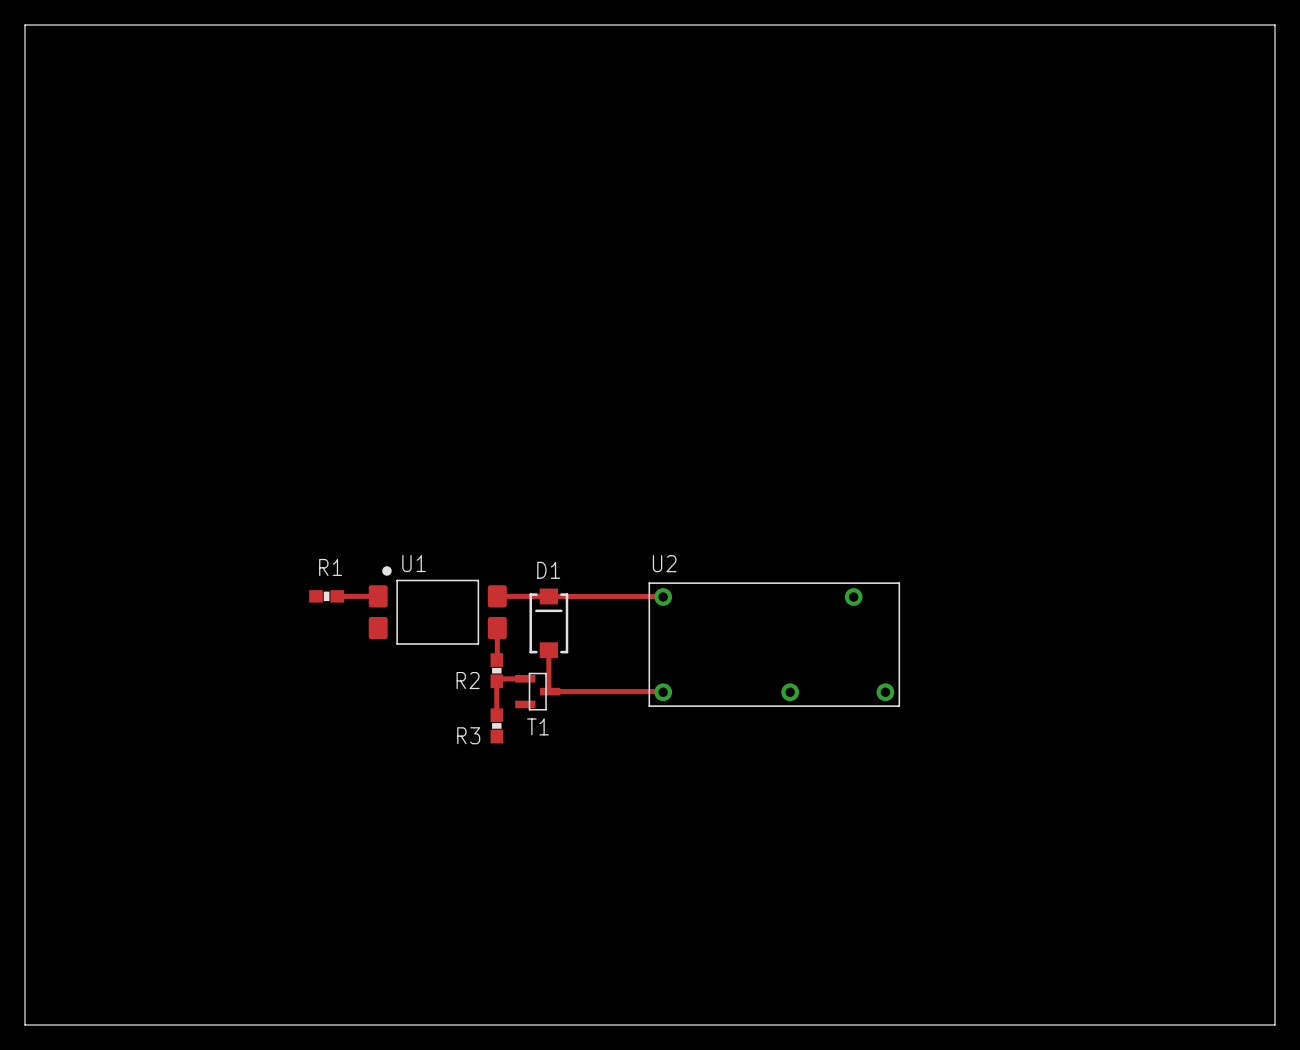
[picture p22: board v1.brd from above]

Board: 2 copper layers, 100.0 x 80.0 mm, 7 parts (0 on the bottom side), 6 nets.
