aguileraGit/bf/(commit log)

2017-10-07 Version 1 Ordered.
    [BOM.csv, PAN_ALQ1.step, mainPCB-BOM.csv, mainPCB-BOM.xlsx, mainPCB-perValue.csv, mainPCB.brd, mainPCB.sch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]
2017-12-04 Adding files for v0.2
    [BF_v0_2-00-BOM.xlsx, BOM.csv, mainPCB-BOM-v0_2-00.xlsx, mainPCB.brd, mainPCB.sch, v1.brd, v1.sch]
2017-12-10 Removed Diode.
    [mainPCB.brd, mainPCB.sch]
2018-01-02 Adding files
    [flowData.csv, mainPCB-BOM-v0_1.xlsx, mainPCB-BOM-v0_3-00.xlsx, mainPCB-BOM-v0_4-00.xlsx, mainPCB.brd, v1.brd, v1.sch]
2018-02-24 Technically version 0.4. Sending it to JLCPCB for production.
    [BF_v0_2-00-BOM-seeedExport.csv, Eagle\Eagle\Eagle.sch, STL\STL\STEP\DR73.step, bomExported.csv, mainPCB-BOM-v0_4-00.xlsx, mainPCB-BOM.csv, mainPCB-BOM.xlsx, mainPCB-perValue.csv]
2018-03-08 Added all design files for v0.4. Cleaned up old files.
    [BF_v0_2-00-BOM-seeedExport.csv, bomExported.csv, mainPCB-BOM-v04.csv, mainPCB-BOM-v0_4-01.xlsx, mainPCB.brd, mainPCB.csv, mainPCB.sch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]
2018-03-08 Adding Design Files for v0.4
    [mainPCB-BOM-v04.csv]
